canadoce/DuckBuddy/hardware/feet/rfq/duckbuddy-feet-drawing.pdf

TITLE

## Foot sole, LEFT shown, RIGHT is mirror image

PART NO.
DB-FOOT-SOLE-L / DB-FOOT-SOLE-R

MATERIAL
Cast PU elastomer, Shore 60A +-5, bright orange (e.g. RAL 2004)

SCALE

2:1

UNITS

mm

PROJECTION

Views as labelled

REV

A

DATE

2026-11-07

DRAWN

Rafael Caricio

SHEET

TOP VIEW (into cavity, dashed: cavity at Z=6)

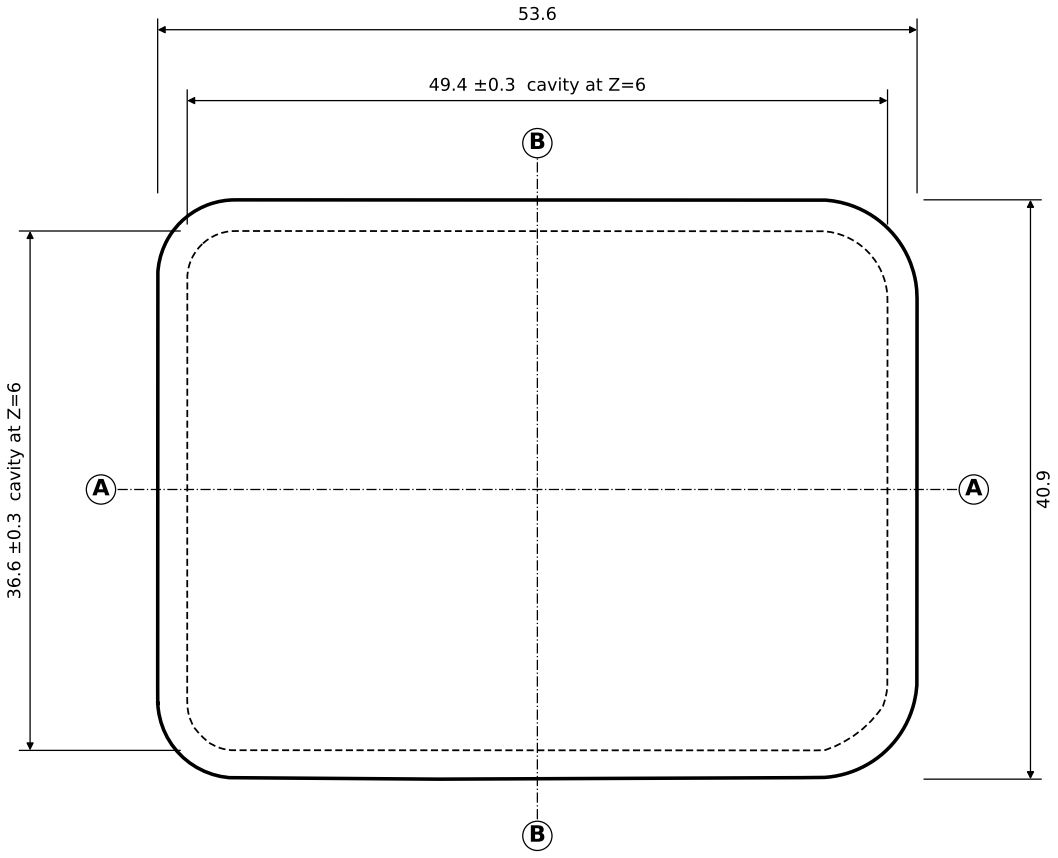
[picture p11: figure]
49.4 ±0.3 cavity at Z=6; 36.6 ±0.3 cavity at Z=6
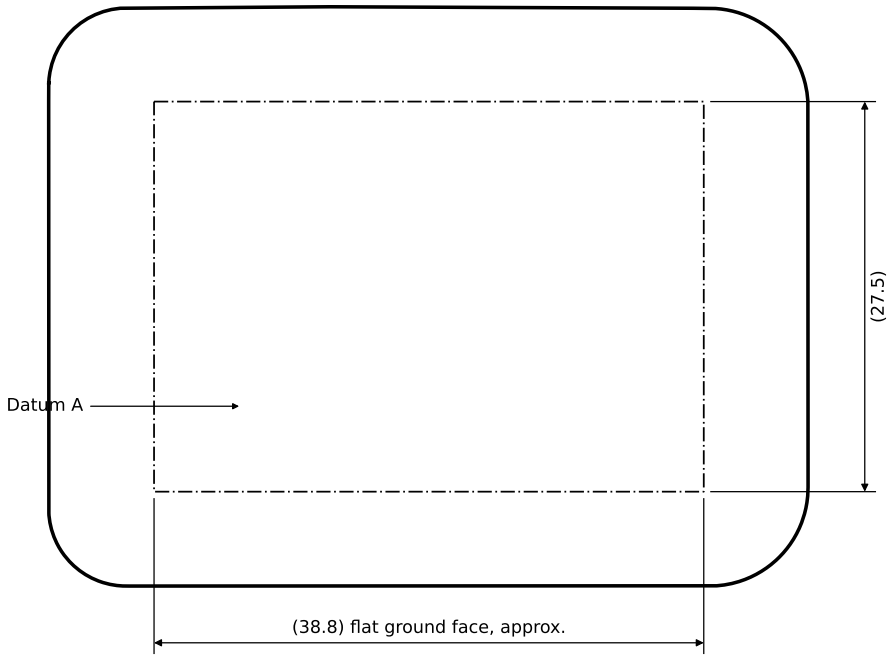
[picture p12: figure]
(38.8) flat ground face, approx.; Datum A

BOTTOM VIEW (ground face; dash-dot: flat area, edges blend up)

Datum A (ground)

(11.6)

# 2.0 floor

-X (heel) | +X (toe)
SECTION A-A (plane Y=0, seen from -Y; (11.6): rim at the toe, ref.) 13.3 | 10.0

Rim top is 4.9 deg to the ground face (ref.)

-Y | +Y
SECTION B-B (plane X=0, seen from +X)

NOTES
1. The STEP file is the master geometry. This drawing gives the critical dimensions and tolerances

only.

2. General tolerance +-0.3 mm (Yellowhammer standard vacuum casting accuracy: +-0.3 %, min +-0.3 mm).
3. The STEP is the finished sole: it is already 0.8 % smaller than the foot, so the soft sole

stretches over the rigid foot and grips it. Add only your usual casting-shrinkage compensation,
no other scaling.
4. Wall as modelled: 1.8-2.1 mm above Z=7; 1.2-1.5 mm in a band at Z=3-7 all round, where the cavity chamfer meets the rounded outside (thinnest at the toe). Wall +0.3/-0.2 mm and never under 1.0 mm. Floor 2.0 +-0.3 mm. No voids or bubbles.
5. Hardness Shore 60A +-5 (ISO 48-4 / ASTM D2240 type A, at 23 C, after full post-cure). Hardness not to be changed without written agreement.
6. Ground face (datum A): matte as-cast finish, no gloss, no release-agent film, no gate, vent, flash or parting line.
7. Gates and vents on the rim top face (it sits under the foot edge). Trim flash flush, max 0.2

mm.
8. Right sole = mirror image of the left sole about the XZ plane. Separate files: sole_left.step,

sole_right.step.

9. Pack left and right soles in separate labelled bags, not compressed or folded.

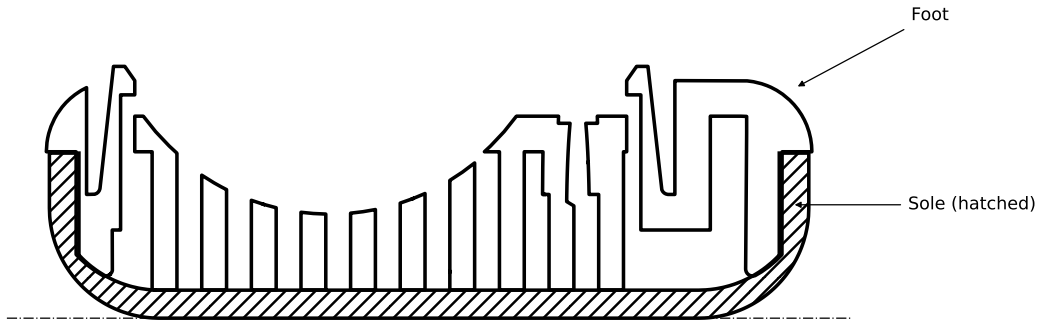
[picture p13: figure]
Sole (hatched); Foot

TITLE

## Foot (rigid), LEFT shown, RIGHT is mirror image

PART NO.
DB-FOOT-L / DB-FOOT-R

MATERIAL
PA12 (SLS, dyed), bright orange (e.g. RAL 2004)

SCALE

2:1

UNITS

mm

PROJECTION

Views as labelled

REV

A

DATE

2026-11-07

DRAWN

Rafael Caricio

SHEET

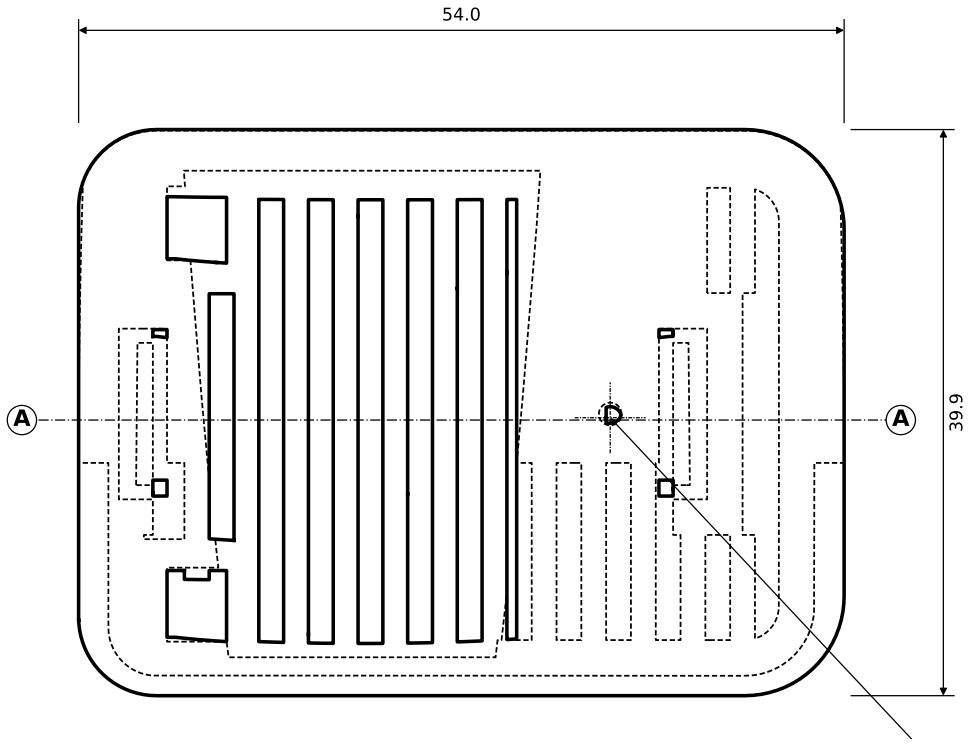
[picture p14: figure]

Pilot hole dia 1.6, 5 deep, for M2 self-tapping screw.
If printed smaller, clean to dia 1.6 with a drill. Do not enlarge.

TOP VIEW (dashed: section at Z=12)

16.4

SECTION A-A

The sole is 0.8 % smaller than the foot (stretch fit), so the outlines overlap.

ASSEMBLY, SECTION A-A (for reference)

NOTES
1. The STEP file is the master geometry. Make the part as modelled, no changes to holes, slots,

lugs or ribs.

2. General tolerance +-0.3 mm or the printing process standard, whichever is tighter.
3. Outer surfaces below the foot edge go into the sole cavity, which is made 0.8 % smaller (stretch fit). Do not add material on these surfaces (no thick coating).
4. Finish: as printed, bead blasted or vapour smoothed. Colour: bright orange, the same shade as the soles, dyed or pigmented through.
5. Right foot = mirror image of the left foot about the XZ plane. Separate files: foot_left.step,

foot_right.step.

6. The foot is an optional line item. Quote it separately from the soles.
