canadoce/DuckBuddy/hardware/pcb/pdb-imu/art/src/dog.png

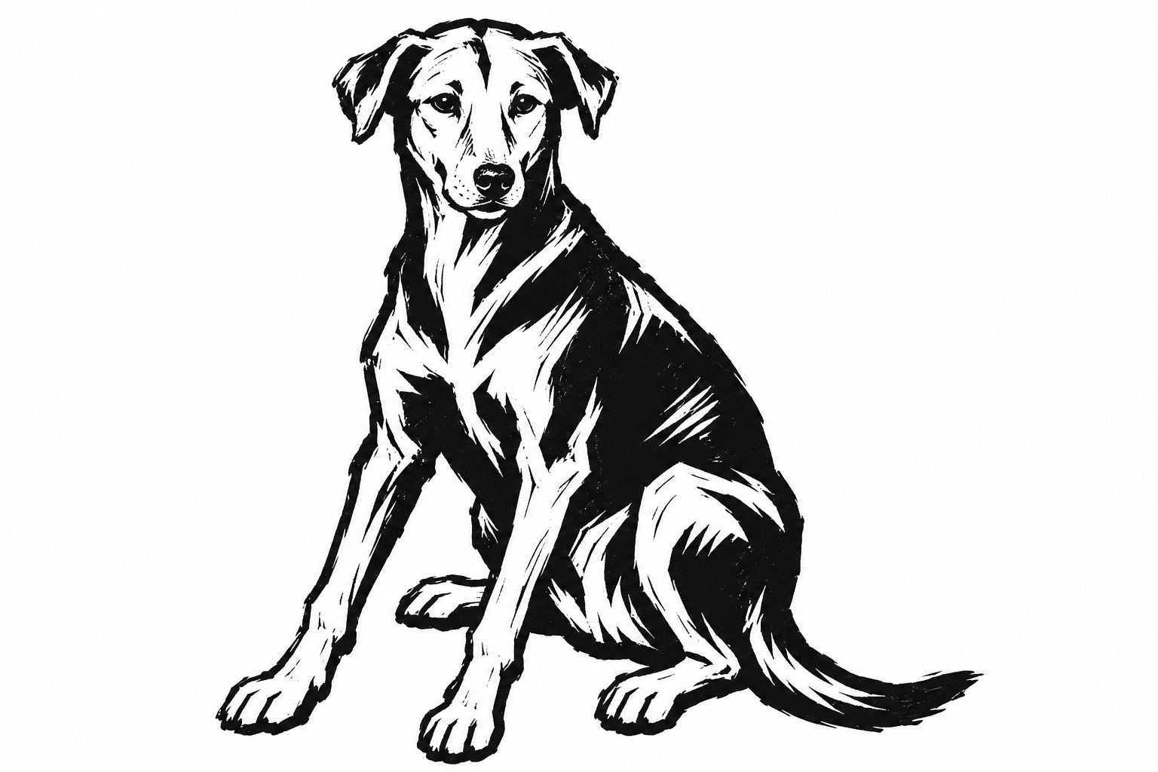
hardware/pcb/pdb-imu/art/src/dog.png
