canadoce/DuckBuddy/hardware/pcb/pdb-imu/fab/2026-11-04-jlcpcb-flat-mount/pdb-imu-r3-bom.csv

Designator | Comment | Value | Footprint | JLCPCB Part #
Q1 | AON7524 | C431195 | C431195 | C431195
Q2 | AON7524 | C431195 | C431195 | C431195
SW1 | MS-1290N | C19188866 | C19188866 | C19188866
R1 | 10k | 10k | res0402 | C25744
D4 |  | C2128 | sod323_anodepin2_cathodepin1 | C2128
Q4 | S8550 | C105432 | C105432 | C105432
Q3 | S8550 | C105432 | C105432 | C105432
U6 | CJ431 | C3113 | C3113 | C3113
R18 | 33k | 33k | res0402 | C25779
R19 | 39k | 39k | res0603 | C23153
R20 | 10k | 10k | res0402 | C25744
R21 | 27k | 27k | res0603 | C22967
R22 | 680k | 680k | res0603 | C25822
R23 | 4.7k | 4.7k | res0402 | C25900
R24 | 10k | 10k | res0402 | C25744
R25 | 10k | 10k | res0402 | C25744
C17 | 22u | 22u | cap0805_nonpolarized | C45783
R2 | 100k | 100k | res0402 | C25741
D2 |  | C173431 | sod123_anodepin2_cathodepin1 | C173431
C2 | 1u | 1u | cap0603_nonpolarized | C15849
D1 |  | C152106 | smb_anodepin2_cathodepin1 | C152106
C1 | RVT100UF25V67RV0011 | 100u | C2836443 | C2836443
F1 | 1210L300/24WR | C22379947 | C22379947 | C22379947
C3 | 10u | 10u | cap0805_nonpolarized | C15850
R3 | 33 | 33 | res0402 | C25105
R6 | 3.3k | 3.3k | res0402 | C25890
LED1 | KT-0805G | C2297 | C2297 | C2297
F2 | 1210L300/24WR | C22379947 | C22379947 | C22379947
C4 | 10u | 10u | cap0805_nonpolarized | C15850
R4 | 33 | 33 | res0402 | C25105
R7 | 3.3k | 3.3k | res0402 | C25890
LED2 | KT-0805G | C2297 | C2297 | C2297
F3 | 1210L300/24WR | C22379947 | C22379947 | C22379947
C5 | 10u | 10u | cap0805_nonpolarized | C15850
R5 | 33 | 33 | res0402 | C25105
R9 | 3.3k | 3.3k | res0402 | C25890
LED3 | KT-0805G | C2297 | C2297 | C2297
F4 | 1A / 32V | 1A / 32V | 0603 | C99544
C6 | 1u | 1u | cap0603_nonpolarized | C15849
U3 | TPS70933DBVR | C89347 | C89347 | C89347
C7 | 4.7u | 4.7u | cap0603_nonpolarized | C19666
U1 | STM32G031F8P6 | C529334 | C529334 | C529334
C8 | 100n | 100n | cap0402_nonpolarized | C1525
C9 | 4.7u | 4.7u | cap0603_nonpolarized | C19666
C10 | 100n | 100n | cap0402_nonpolarized | C1525
R10 | 1k | 1k | res0402 | C11702
LED4 | KT-0603R | C2286 | C2286 | C2286
U2 | LSM6DSV16XTR | C5267406 | C5267406 | C5267406
C11 | 100n | 100n | cap0402_nonpolarized | C1525
C12 | 100n | 100n | cap0402_nonpolarized | C1525
R8 | 10k | 10k | res0402 | C25744
U4 | 74LVC1G126GW | C52140429 | C52140429 | C52140429
C13 | 100n | 100n | cap0402_nonpolarized | C1525
R11 | 100k | 100k | res0402 | C25741
R13 | 33 | 33 | res0402 | C25105
D3 | PESD5V0S1BA | C2827694 | C2827694 | C2827694
R16 | 100k | 100k | res0402 | C25741
R17 | 22k | 22k | res0402 | C25768
C16 | 100n | 100n | cap0402_nonpolarized | C1525
RS1 | RLM12FTCMR002 | 2m | C710257 | C710257
U5 | INA180A2IDBVR | C192764 | C192764 | C192764
C14 | 100n | 100n | cap0402_nonpolarized | C1525
R15 | 1k | 1k | res0402 | C11702
C15 | 100n | 100n | cap0402_nonpolarized | C1525
