canadoce/DuckBuddy/hardware/pcb/pdb-imu/art/src/microduck_iso_parts.png

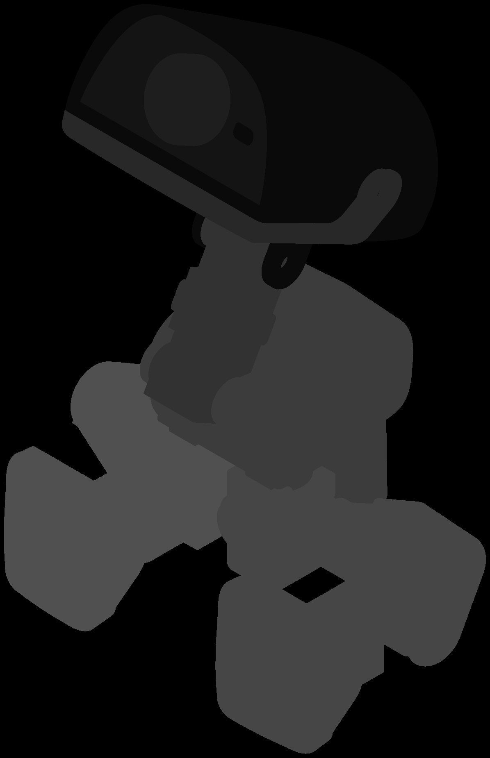
hardware/pcb/pdb-imu/art/src/microduck_iso_parts.png
