canadoce/DuckBuddy/hardware/cad/face-plate/3MF/face_plate.3mf

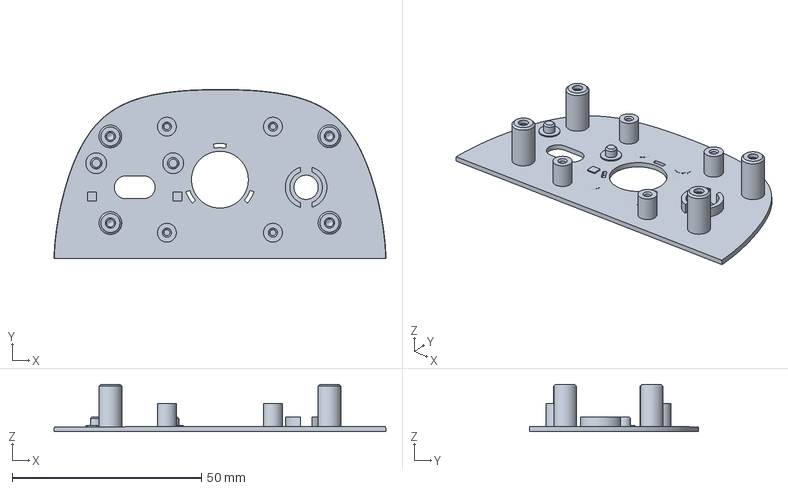
[picture p17: CAD file, 2026-11-09]
hardware/cad/face-plate/3MF/face_plate.3mf
87.7 x 44.7 x 12.5 mm
