canadoce/DuckBuddy/hardware/cad/lipo-plate/reference/power_support__5.stl

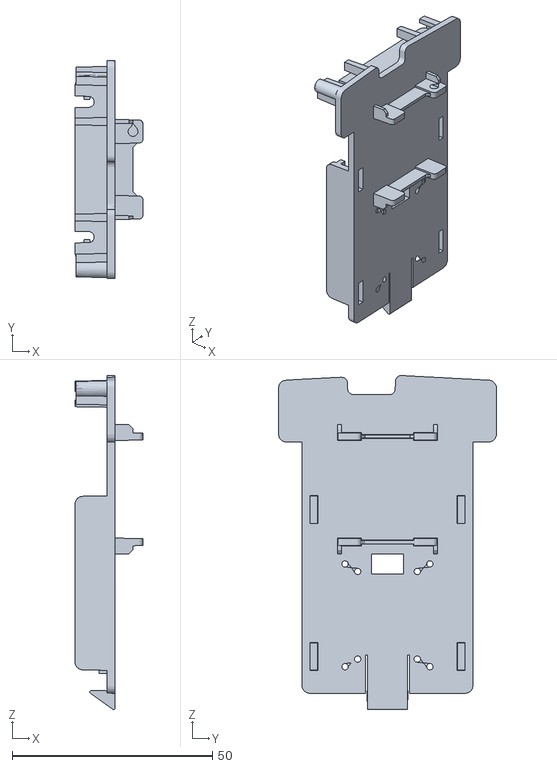
[picture p18: CAD file, 2026-11-06]
hardware/cad/lipo-plate/reference/power_support__5.stl
17.0 x 54.5 x 83.5
