canadoce/DuckBuddy/hardware/cad/lipo-plate/STEP/imu_mount.step

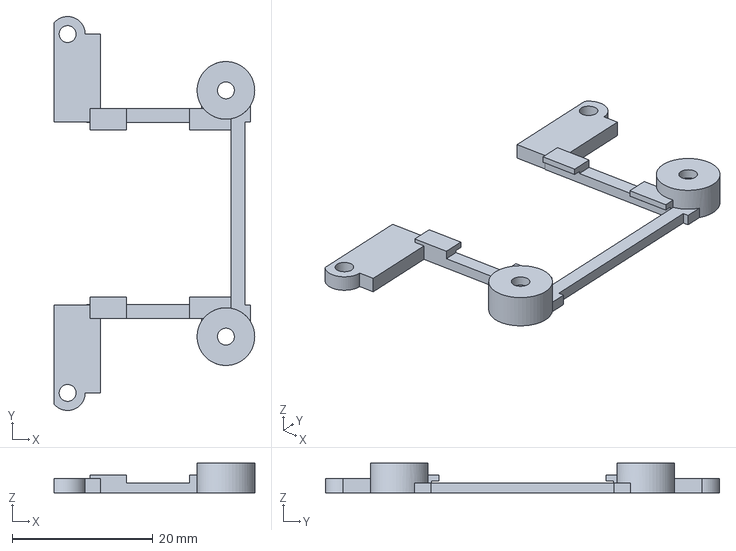
[picture p19: CAD file, 2026-11-09]
hardware/cad/lipo-plate/STEP/imu_mount.step
28.5 x 56.0 x 4.20 mm
