canadoce/DuckBuddy/hardware/cad/open-head/3MF/open_head_shell.3mf

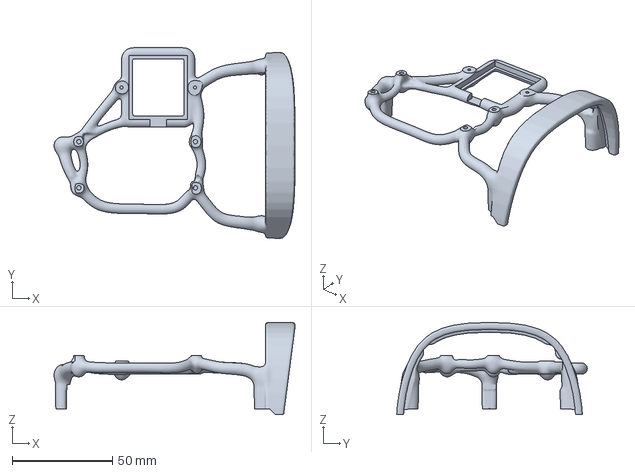
[picture p20: CAD file, 2026-11-09]
hardware/cad/open-head/3MF/open_head_shell.3mf
120.0 x 94.9 x 45.9 mm
