canadoce/DuckBuddy/hardware/cad/open-head/reference/bottom_head_shell_duckbuddy.stl

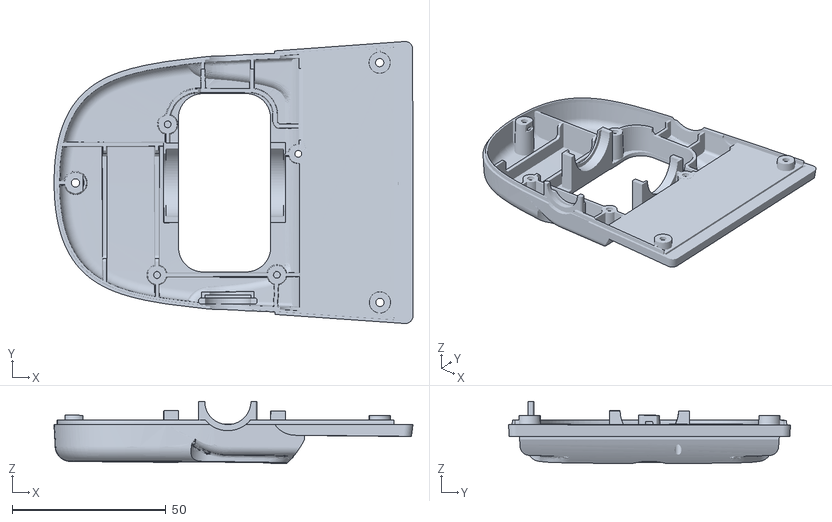
[picture p21: CAD file, 2026-11-06]
hardware/cad/open-head/reference/bottom_head_shell_duckbuddy.stl
116.8 x 91.8 x 20.2
