canadoce/DuckBuddy/hardware/cad/open-head/reference/microduck/jaw_soft__xl330__44.stl

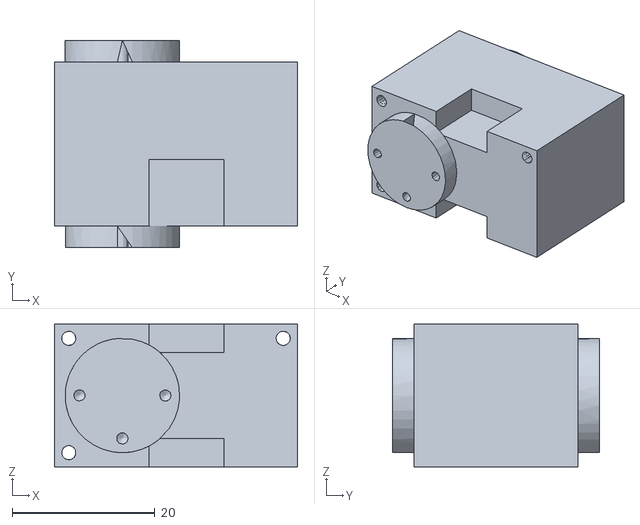
[picture p22: CAD file, 2026-11-06]
hardware/cad/open-head/reference/microduck/jaw_soft__xl330__44.stl
34.0 x 29.0 x 20.0
