canadoce/DuckBuddy/hardware/cad/servo-dummy/3MF/servo_dummy.3mf

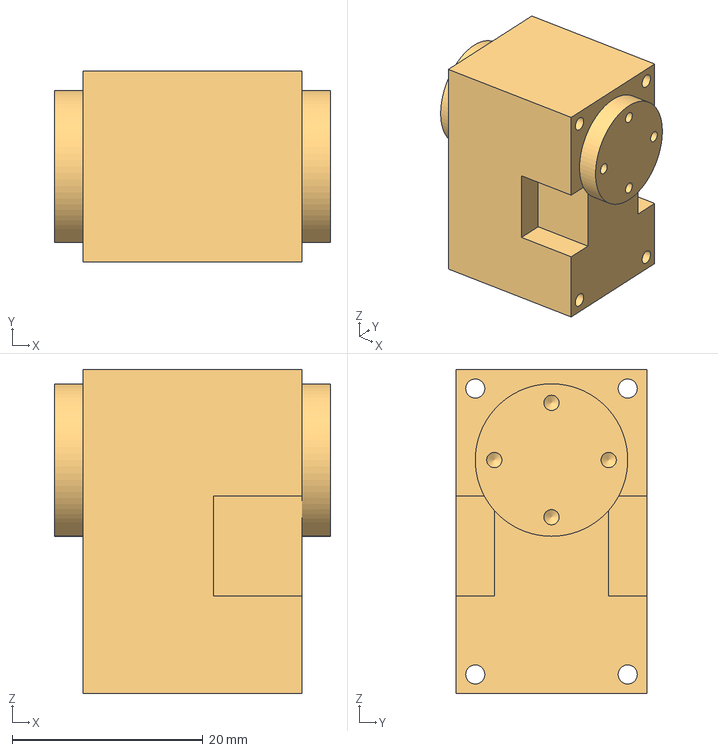
[picture p23: CAD file, 2026-11-07]
hardware/cad/servo-dummy/3MF/servo_dummy.3mf
29.0 x 20.0 x 34.0 mm
