canadoce/DuckBuddy/hardware/feet/STL/sole_right.stl

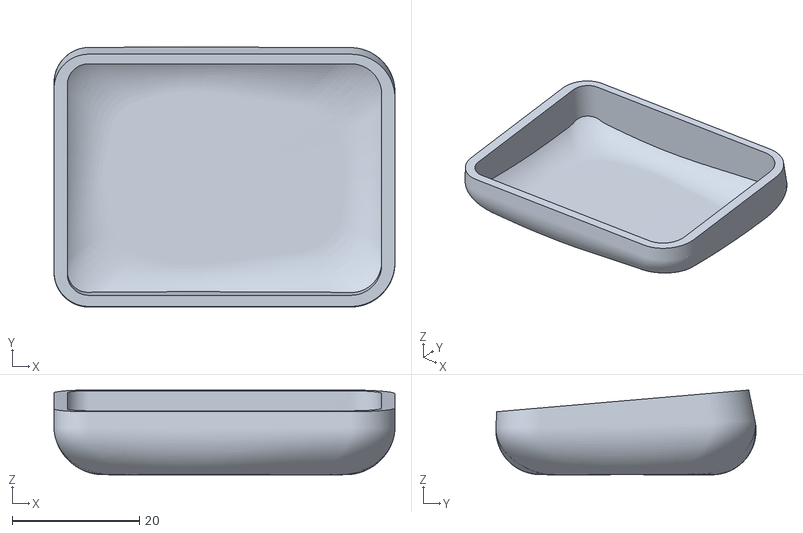
[picture p24: CAD file, 2026-11-09]
hardware/feet/STL/sole_right.stl
53.6 x 40.9 x 13.3
