canadoce/DuckBuddy/hardware/cad/lipo-plate/STEP/lipo_plate.step

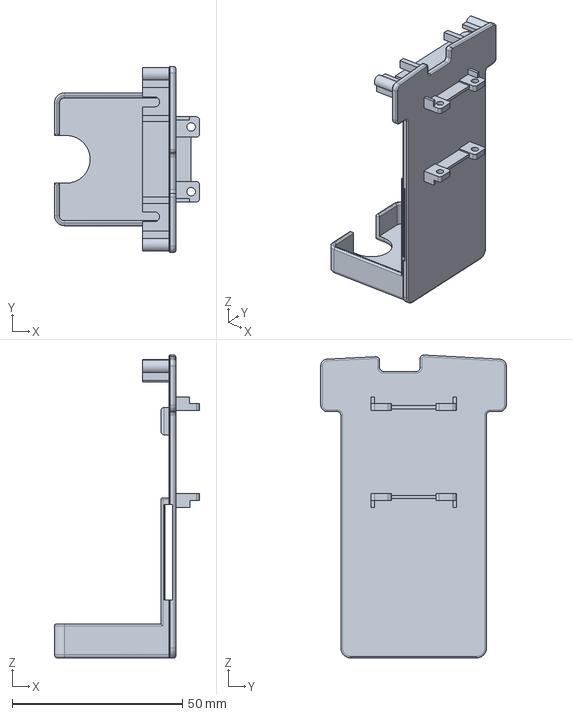
[picture p26: CAD file, 2026-11-09]
hardware/cad/lipo-plate/STEP/lipo_plate.step
42.6 x 54.5 x 88.9 mm
