canadoce/DuckBuddy/hardware/cad/open-head/reference/face_part_duckbuddy.stl

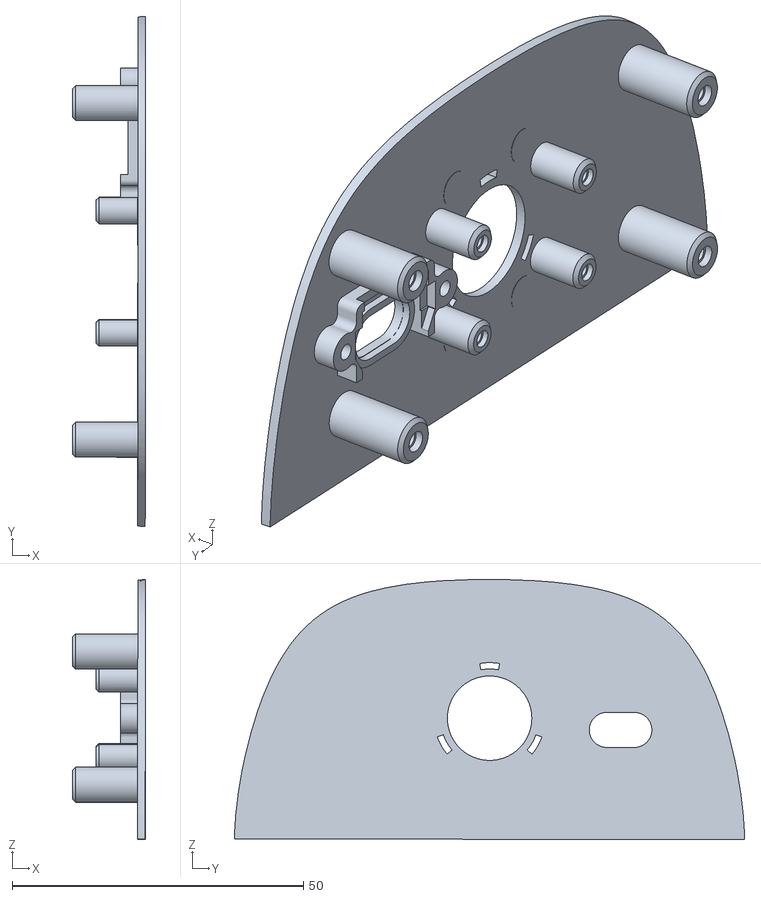
[picture p27: CAD file, 2026-11-06]
hardware/cad/open-head/reference/face_part_duckbuddy.stl
12.5 x 87.7 x 44.7
