canadoce/DuckBuddy/hardware/cad/open-head/reference/microduck/jaw_soft__noenoeil__53.stl

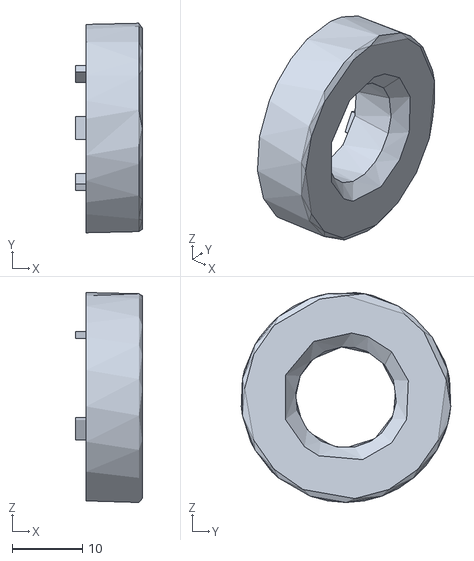
[picture p28: CAD file, 2026-11-06]
hardware/cad/open-head/reference/microduck/jaw_soft__noenoeil__53.stl
9.50 x 29.9 x 29.9
