canadoce/DuckBuddy/hardware/feet/STL/foot_right.stl

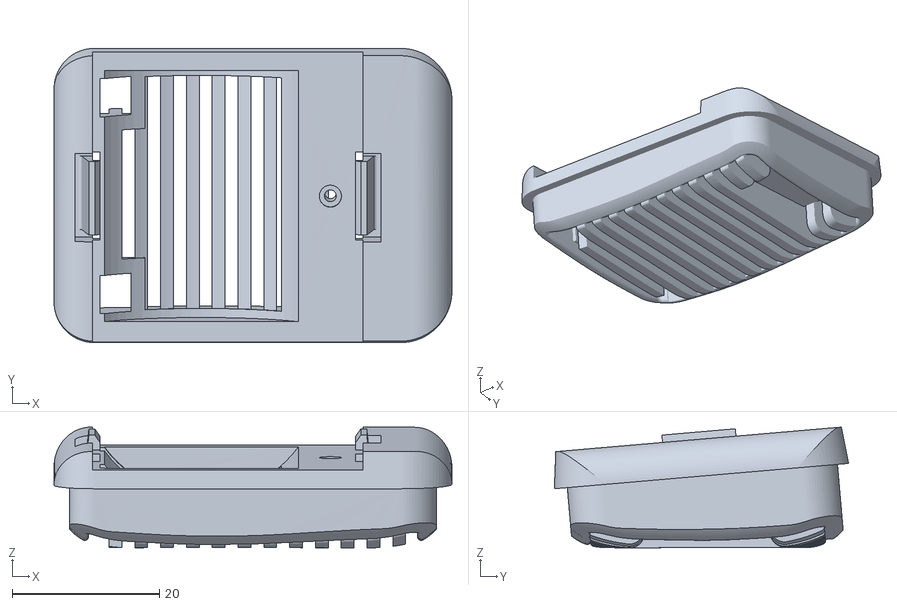
[picture p29: CAD file, 2026-11-09]
hardware/feet/STL/foot_right.stl
54.0 x 39.9 x 16.4
