canadoce/DuckBuddy/hardware/cad/lipo-plate/reference/seeed_bearing__configuration__22x16x4__0.stl

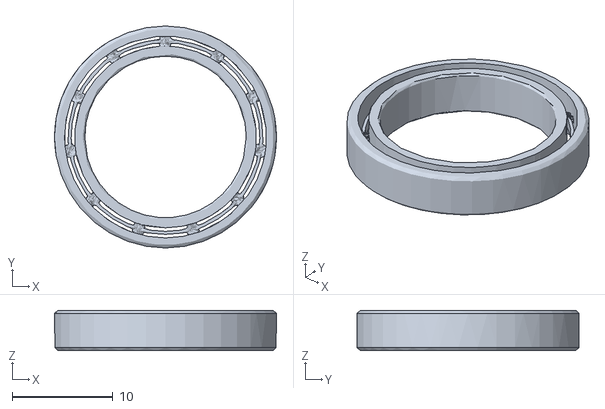
[picture p30: CAD file, 2026-11-06]
hardware/cad/lipo-plate/reference/seeed_bearing__configuration__22x16x4__0.stl
22.0 x 22.0 x 4.00
