canadoce/DuckBuddy/hardware/cad/open-head/reference/microduck/jaw_soft__soft_mouth_top__52.stl

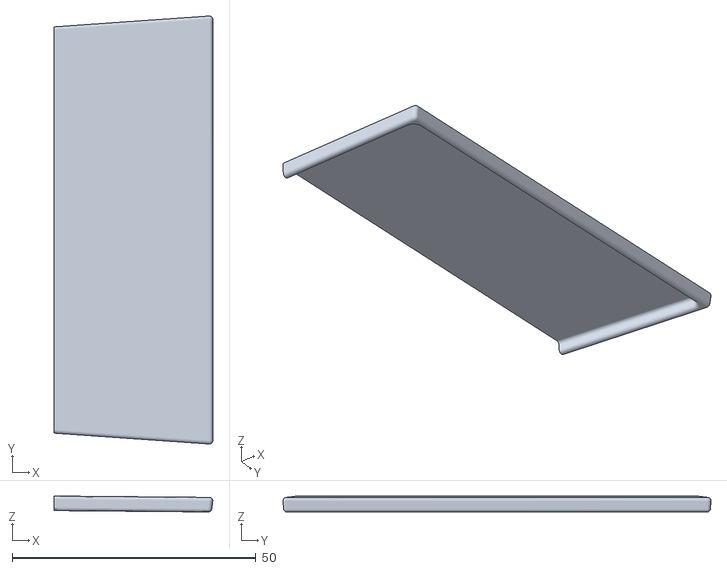
[picture p31: CAD file, 2026-11-06]
hardware/cad/open-head/reference/microduck/jaw_soft__soft_mouth_top__52.stl
32.6 x 87.8 x 3.27
