canadoce/DuckBuddy/hardware/cad/open-head/reference/top_head_shell_duckbuddy.stl

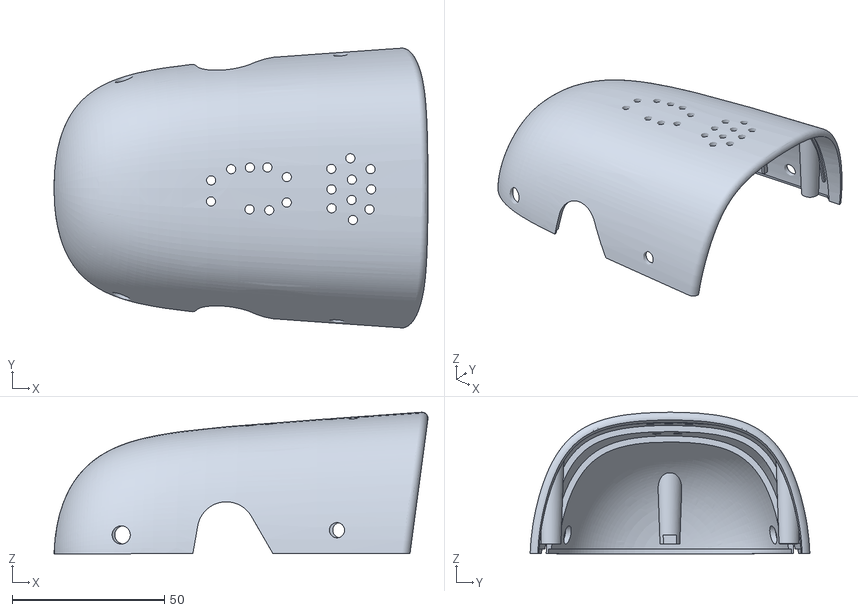
[picture p32: CAD file, 2026-11-06]
hardware/cad/open-head/reference/top_head_shell_duckbuddy.stl
122.7 x 91.8 x 46.4
