canadoce/DuckBuddy/hardware/cad/lipo-plate/reference/right_shell__1.stl

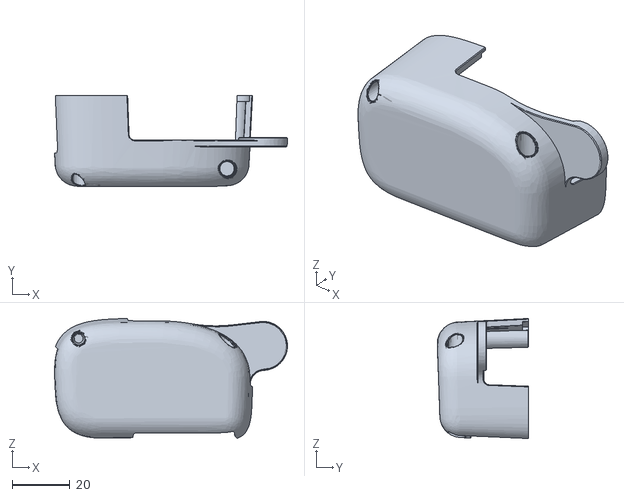
[picture p33: CAD file, 2026-11-06]
hardware/cad/lipo-plate/reference/right_shell__1.stl
80.9 x 31.8 x 41.7
