canadoce/DuckBuddy/hardware/cad/open-head/reference/microduck/jaw_soft__bottom_head_shell__56.stl

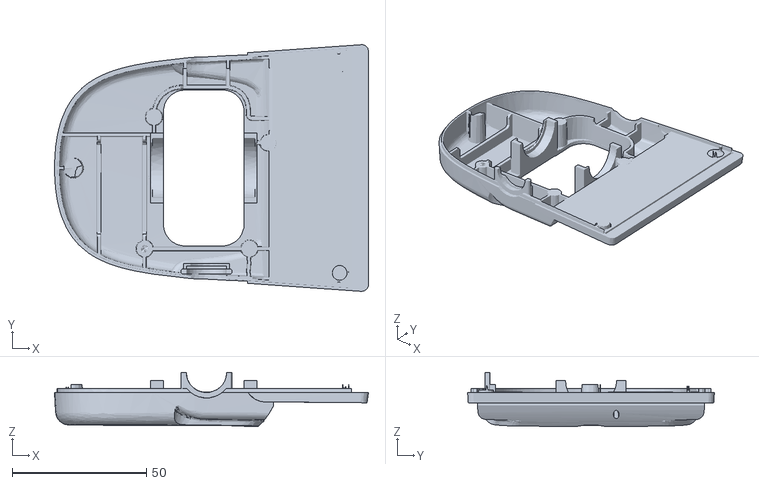
[picture p34: CAD file, 2026-11-06]
hardware/cad/open-head/reference/microduck/jaw_soft__bottom_head_shell__56.stl
116.7 x 91.7 x 20.1
