canadoce/DuckBuddy/hardware/cad/lipo-plate/reference/power_support_duckbuddy.stl

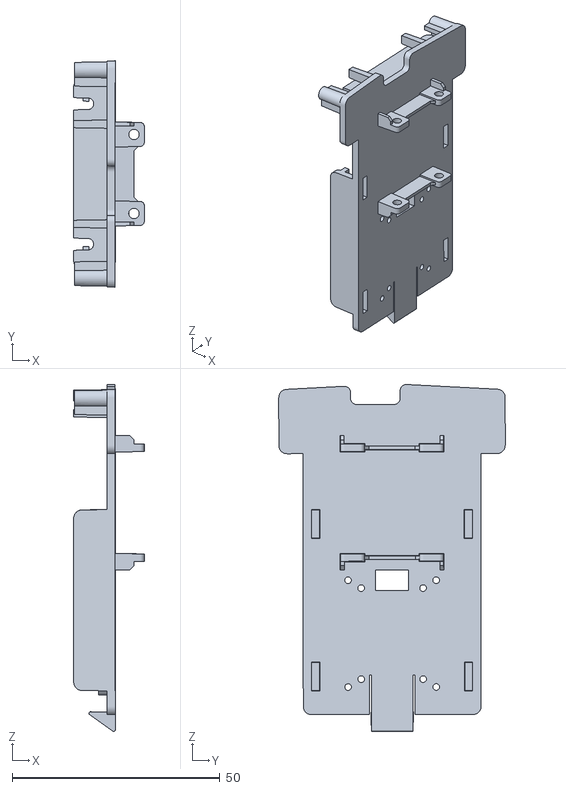
[picture p35: CAD file, 2026-11-06]
hardware/cad/lipo-plate/reference/power_support_duckbuddy.stl
17.0 x 54.5 x 83.5
