canadoce/DuckBuddy/hardware/cad/open-head/reference/microduck/jaw_soft__m12_lens_holder__58.stl

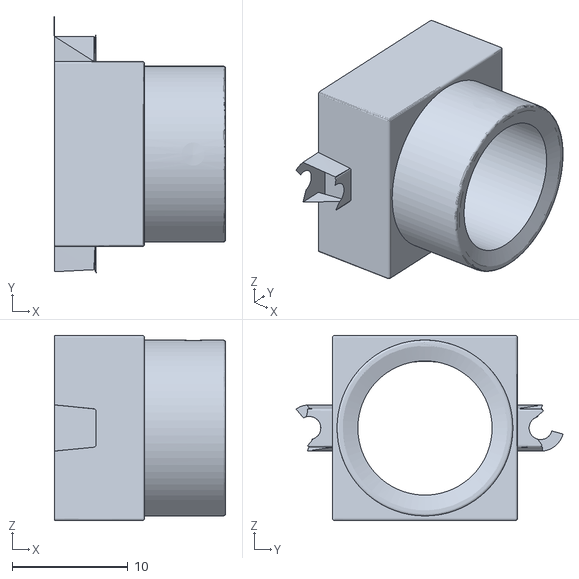
[picture p36: CAD file, 2026-11-06]
hardware/cad/open-head/reference/microduck/jaw_soft__m12_lens_holder__58.stl
14.8 x 23.1 x 16.0
