canadoce/DuckBuddy/hardware/cad/lipo-plate/reference/trunk_base_duckbuddy.stl

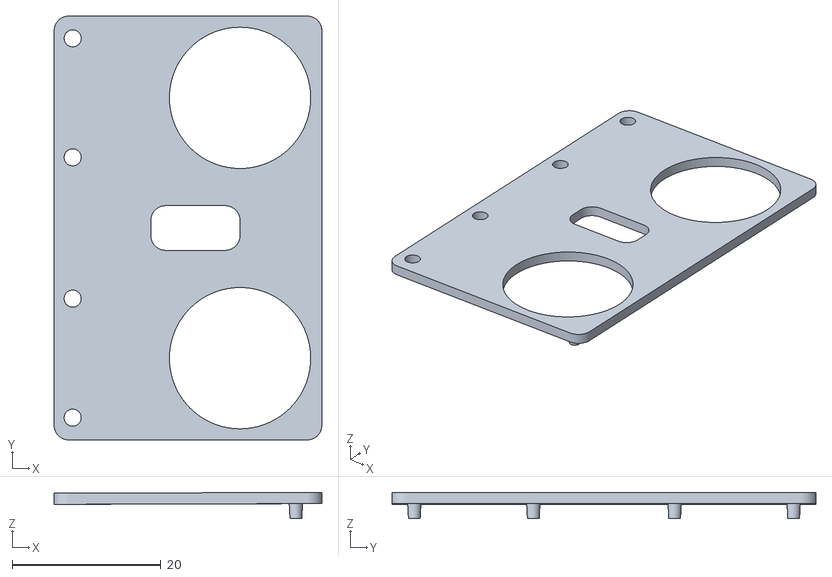
[picture p37: CAD file, 2026-11-06]
hardware/cad/lipo-plate/reference/trunk_base_duckbuddy.stl
36.0 x 57.0 x 3.52
