canadoce/DuckBuddy/hardware/cad/open-head/reference/microduck/neck__neck__35.stl

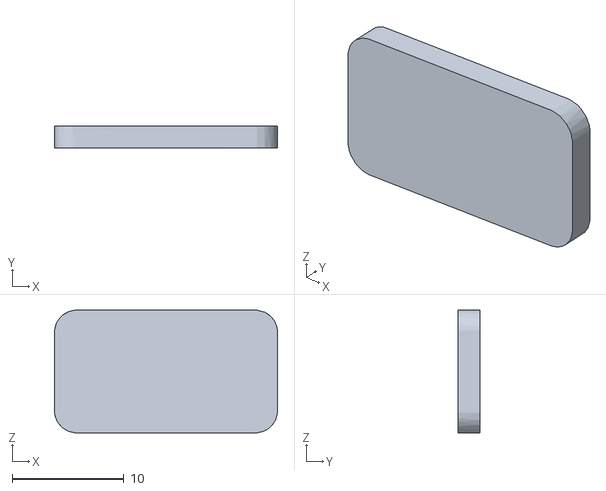
[picture p38: CAD file, 2026-11-06]
hardware/cad/open-head/reference/microduck/neck__neck__35.stl
20.0 x 2.00 x 11.0
