canadoce/DuckBuddy/hardware/cad/open-head/reference/microduck/jaw_soft__jaw__54.stl

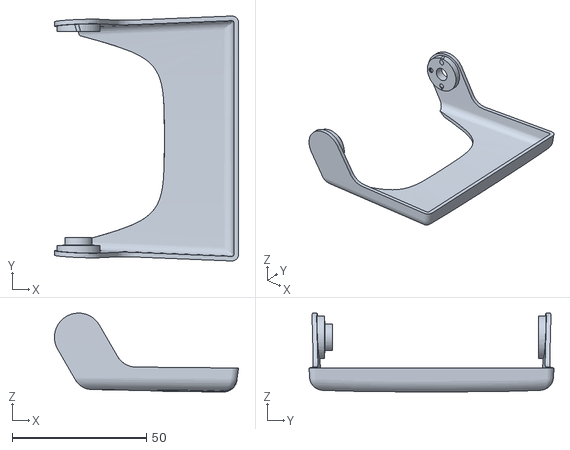
[picture p39: CAD file, 2026-11-06]
hardware/cad/open-head/reference/microduck/jaw_soft__jaw__54.stl
68.7 x 91.4 x 29.4
