canadoce/DuckBuddy/hardware/cad/lipo-plate/reference/np_f970__7.stl

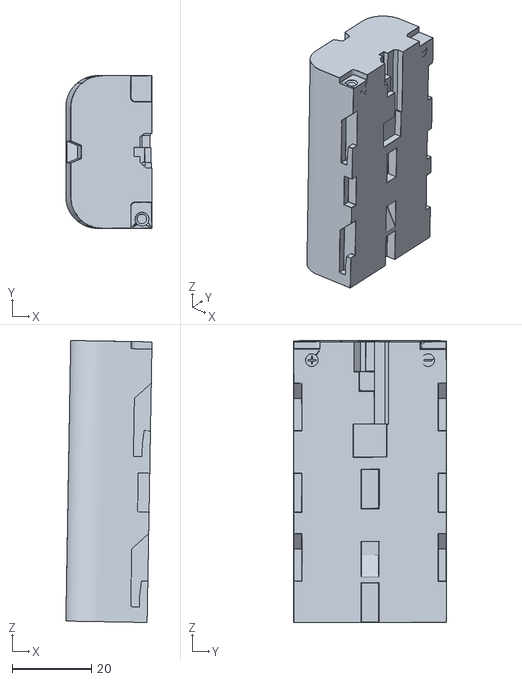
[picture p40: CAD file, 2026-11-06]
hardware/cad/lipo-plate/reference/np_f970__7.stl
21.7 x 38.6 x 71.0
