canadoce/DuckBuddy/hardware/cad/open-head/reference/microduck/jaw_soft__pcb__raspberry_pi_zero_2_w__59.stl

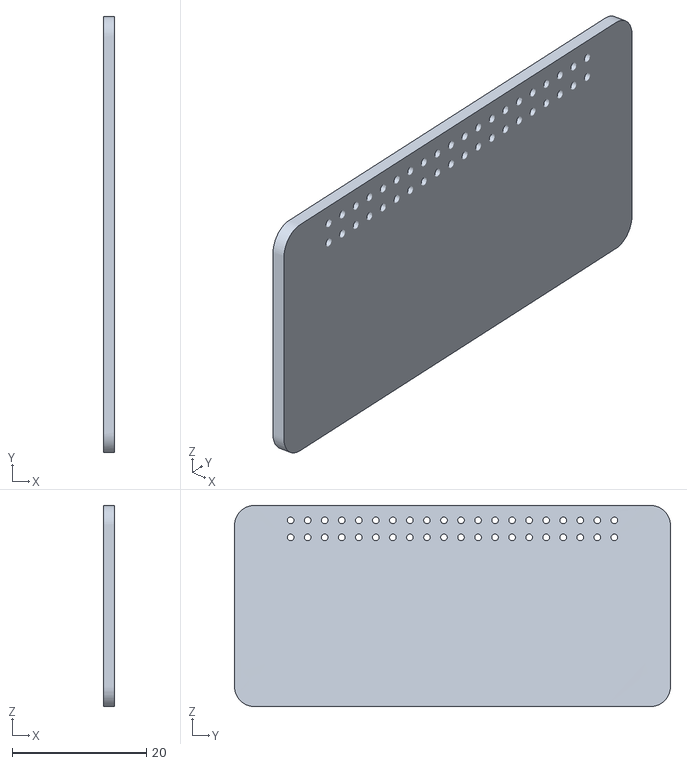
[picture p41: CAD file, 2026-11-06]
hardware/cad/open-head/reference/microduck/jaw_soft__pcb__raspberry_pi_zero_2_w__59.stl
1.60 x 65.0 x 30.0
