canadoce/DuckBuddy/hardware/cad/open-head/reference/microduck/jaw_soft__motor_support__46.stl

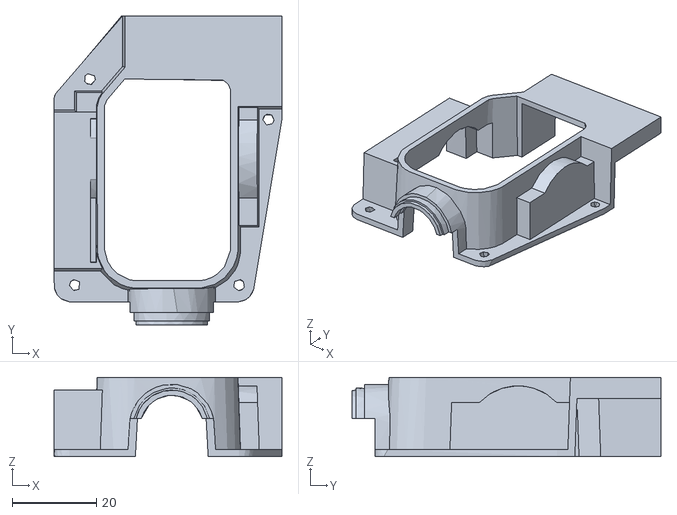
[picture p42: CAD file, 2026-11-06]
hardware/cad/open-head/reference/microduck/jaw_soft__motor_support__46.stl
54.2 x 73.5 x 18.8
