canadoce/DuckBuddy/hardware/cad/lipo-plate/reference/banana_pcb_locker_duckbuddy.stl

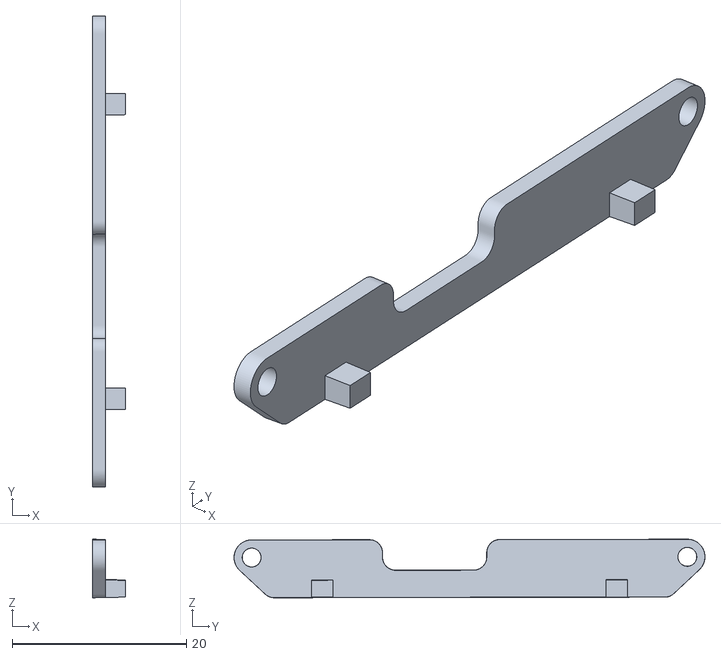
[picture p43: CAD file, 2026-11-06]
hardware/cad/lipo-plate/reference/banana_pcb_locker_duckbuddy.stl
3.82 x 54.0 x 6.73
