canadoce/DuckBuddy/hardware/cad/open-head/reference/microduck/jaw_soft__lens__42.stl

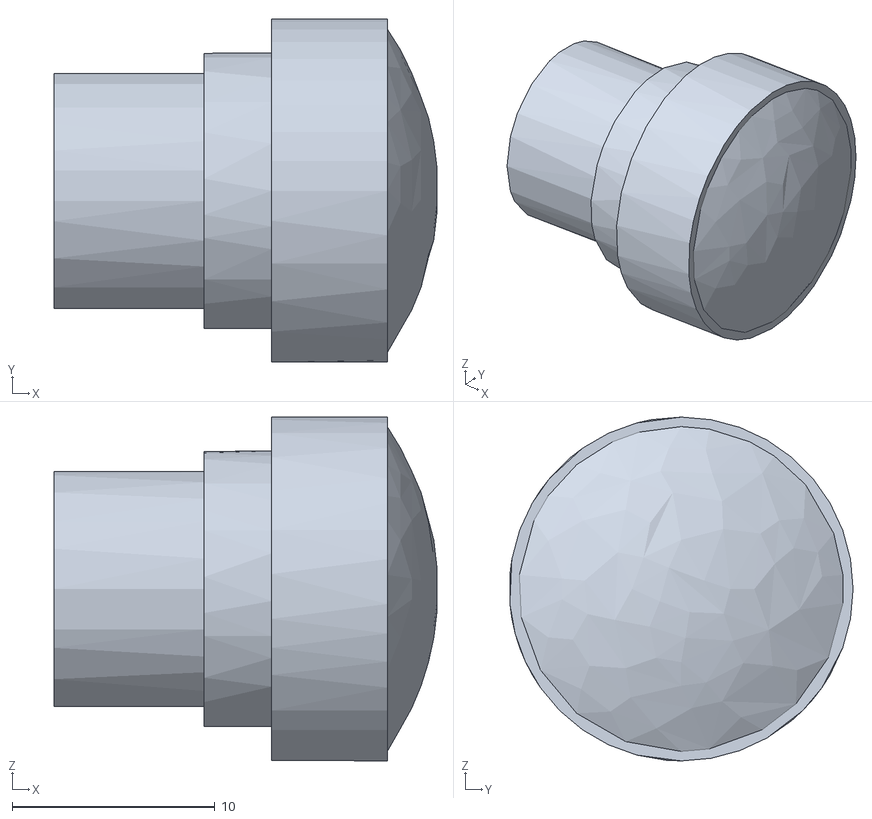
[picture p44: CAD file, 2026-11-06]
hardware/cad/open-head/reference/microduck/jaw_soft__lens__42.stl
18.9 x 16.9 x 16.9
