canadoce/DuckBuddy/hardware/cad/lipo-plate/reference/left_shell_duckbuddy.stl

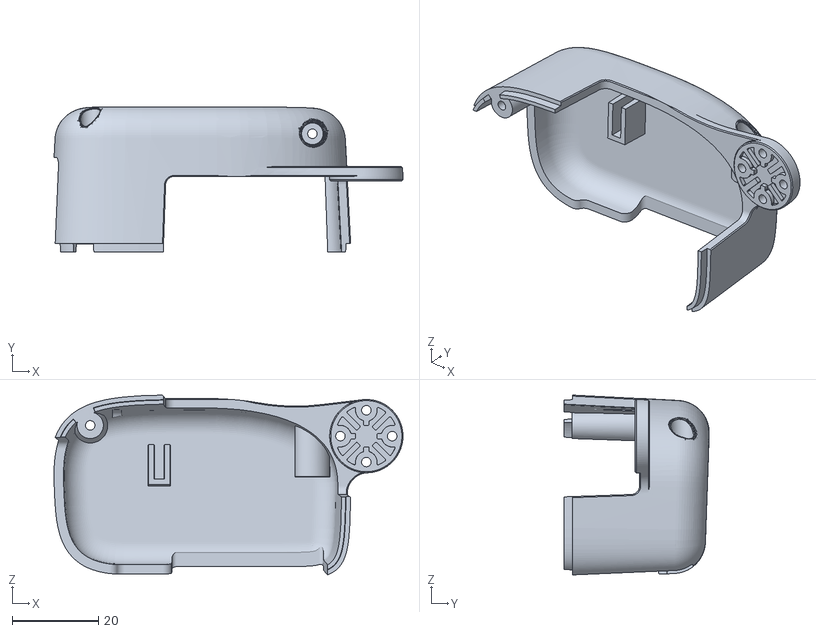
[picture p45: CAD file, 2026-11-06]
hardware/cad/lipo-plate/reference/left_shell_duckbuddy.stl
80.9 x 33.7 x 41.7
