canadoce/DuckBuddy/hardware/cad/lipo-plate/reference/trunk_base__3.stl

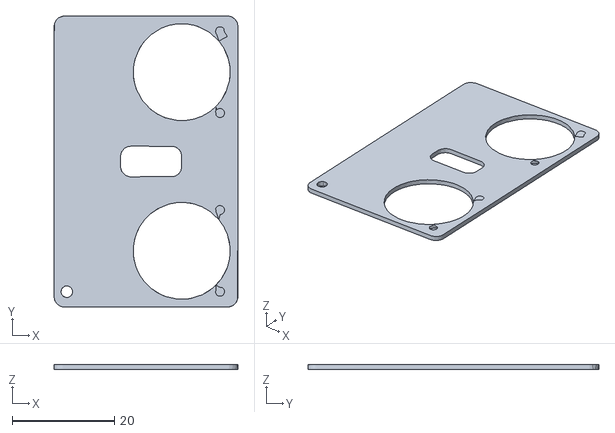
[picture p46: CAD file, 2026-11-06]
hardware/cad/lipo-plate/reference/trunk_base__3.stl
36.0 x 57.0 x 1.00
