canadoce/DuckBuddy/hardware/cad/lipo-plate/reference/left_shell__10.stl

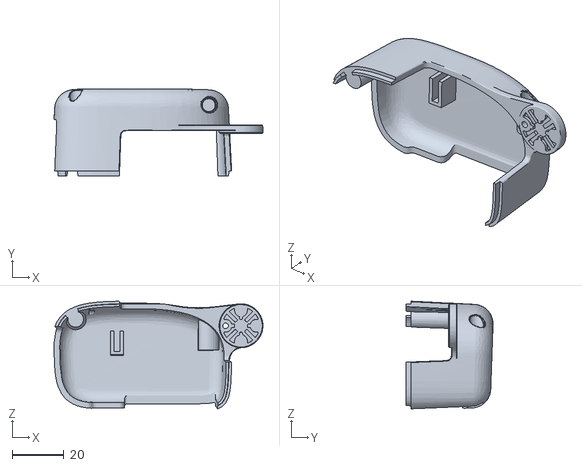
[picture p47: CAD file, 2026-11-06]
hardware/cad/lipo-plate/reference/left_shell__10.stl
80.9 x 33.7 x 41.7
