canadoce/DuckBuddy/hardware/cad/open-head/reference/microduck/jaw_soft__speaker__60.stl

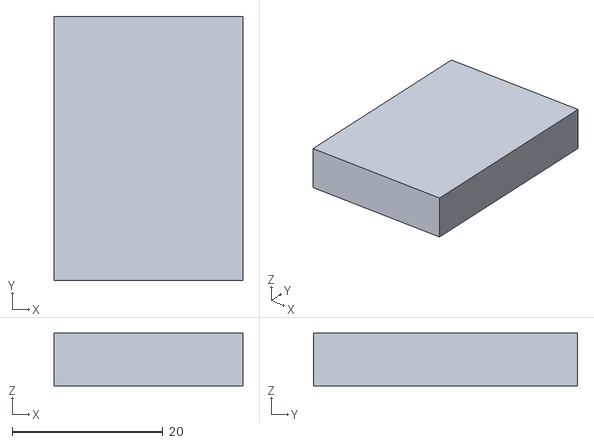
[picture p48: CAD file, 2026-11-06]
hardware/cad/open-head/reference/microduck/jaw_soft__speaker__60.stl
25.0 x 35.0 x 7.00
