canadoce/DuckBuddy/hardware/cad/lipo-plate/reference/banana_pcb_locker__2.stl

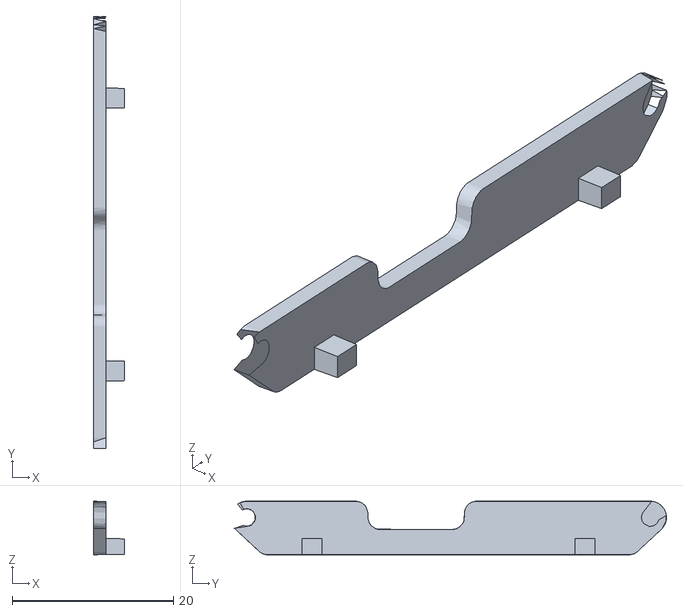
[picture p49: CAD file, 2026-11-06]
hardware/cad/lipo-plate/reference/banana_pcb_locker__2.stl
3.80 x 53.5 x 6.64
