canadoce/DuckBuddy/hardware/cad/open-head/reference/microduck/jaw_soft__face_part__43.stl

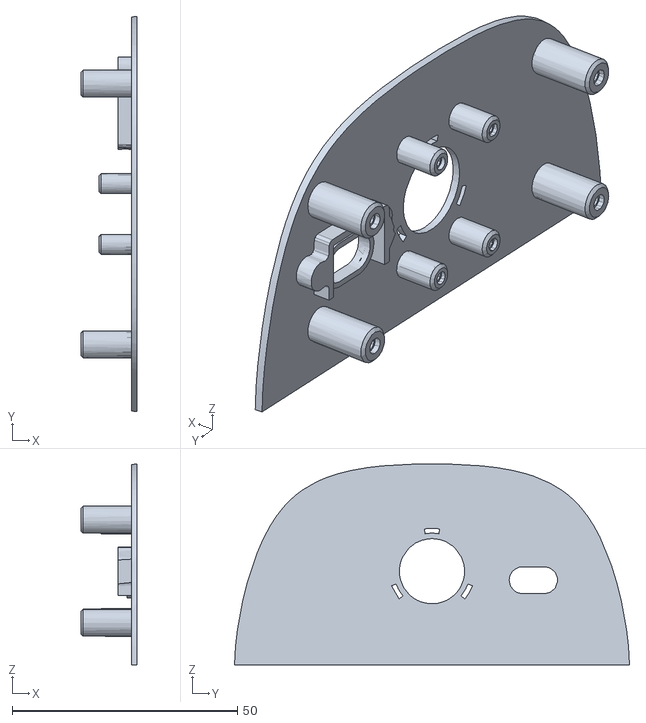
[picture p50: CAD file, 2026-11-06]
hardware/cad/open-head/reference/microduck/jaw_soft__face_part__43.stl
12.5 x 87.7 x 44.6
