canadoce/DuckBuddy/hardware/cad/open-head/reference/microduck/jaw_soft__jaw_soft__45.stl

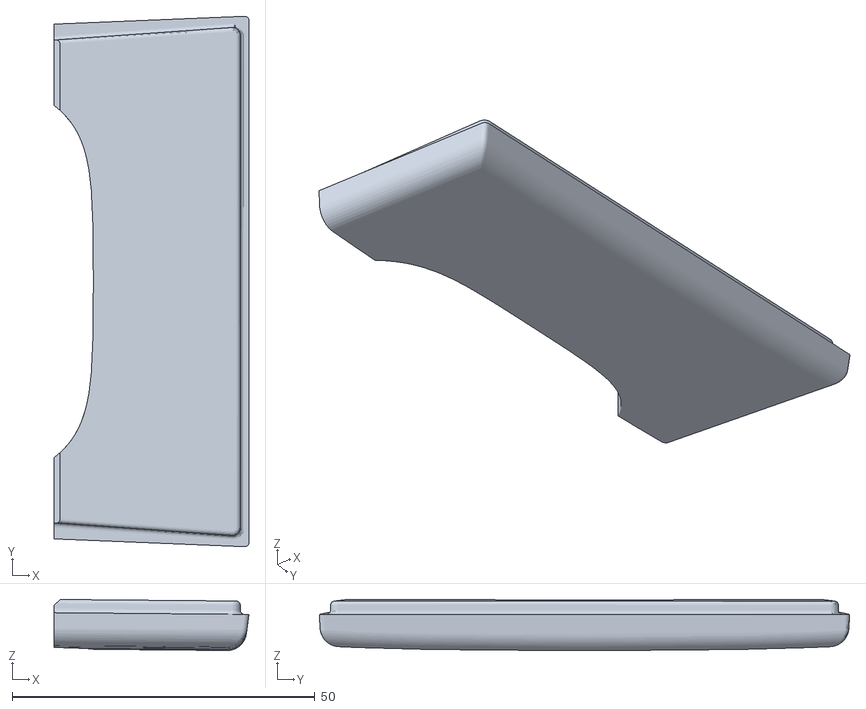
[picture p51: CAD file, 2026-11-06]
hardware/cad/open-head/reference/microduck/jaw_soft__jaw_soft__45.stl
32.2 x 87.7 x 8.44
