canadoce/DuckBuddy/hardware/cad/open-head/reference/microduck/yaw_roll_motion__yaw_roll_motion__38.stl

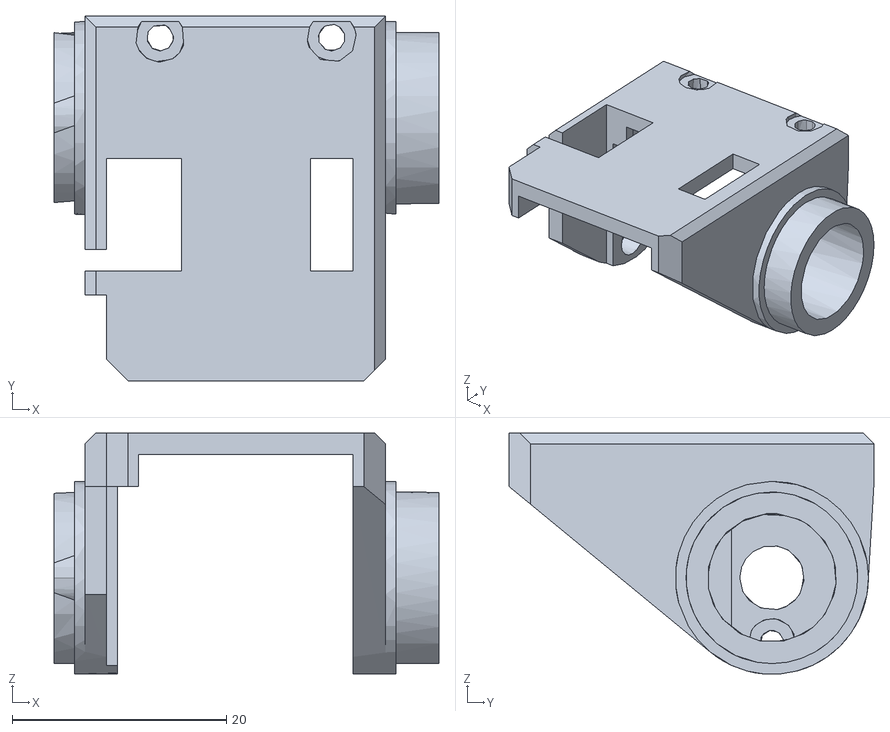
[picture p52: CAD file, 2026-11-06]
hardware/cad/open-head/reference/microduck/yaw_roll_motion__yaw_roll_motion__38.stl
35.9 x 34.0 x 22.5
