canadoce/DuckBuddy/hardware/cad/open-head/reference/microduck/neck_pitch__neck_pitch__36.stl

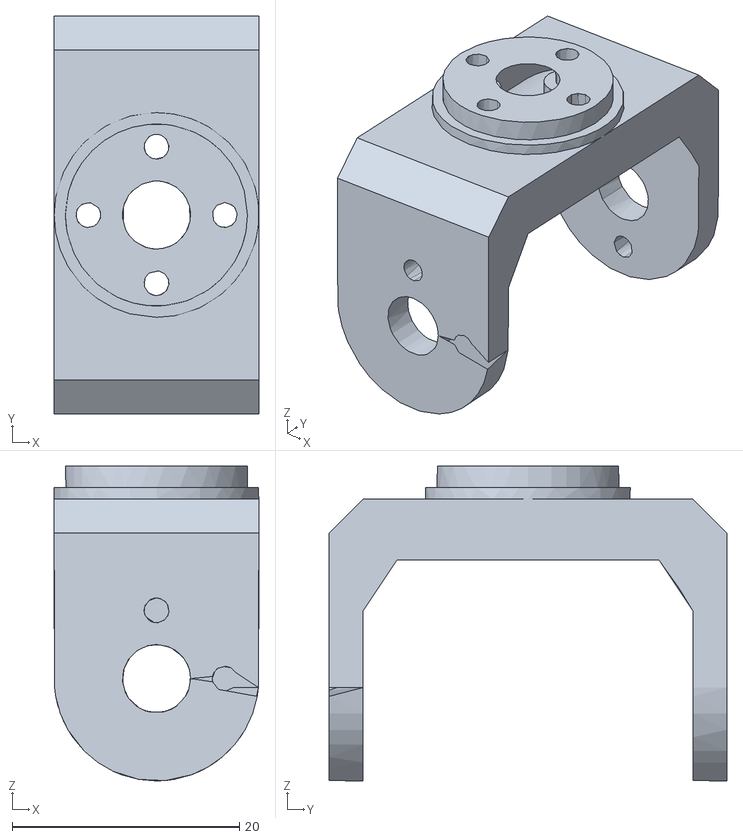
[picture p53: CAD file, 2026-11-06]
hardware/cad/open-head/reference/microduck/neck_pitch__neck_pitch__36.stl
18.0 x 35.0 x 27.7
