canadoce/DuckBuddy/hardware/cad/open-head/reference/microduck/jaw_soft__seeed_bearing__configuration_default__50.stl

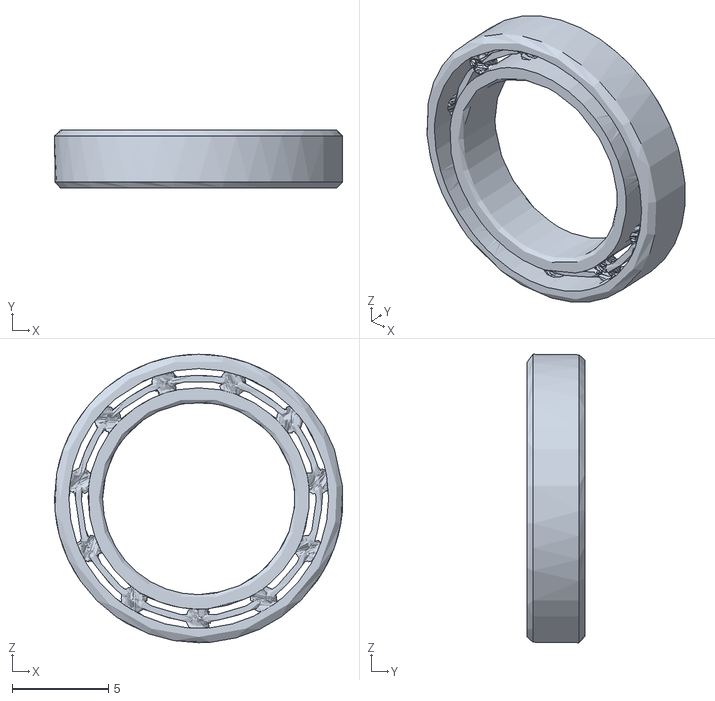
[picture p54: CAD file, 2026-11-06]
hardware/cad/open-head/reference/microduck/jaw_soft__seeed_bearing__configuration_default__50.stl
15.0 x 3.00 x 15.0
