canadoce/DuckBuddy/hardware/cad/open-head/reference/microduck/jaw_soft__elec_rpi_robot_hat_pcb__51.stl

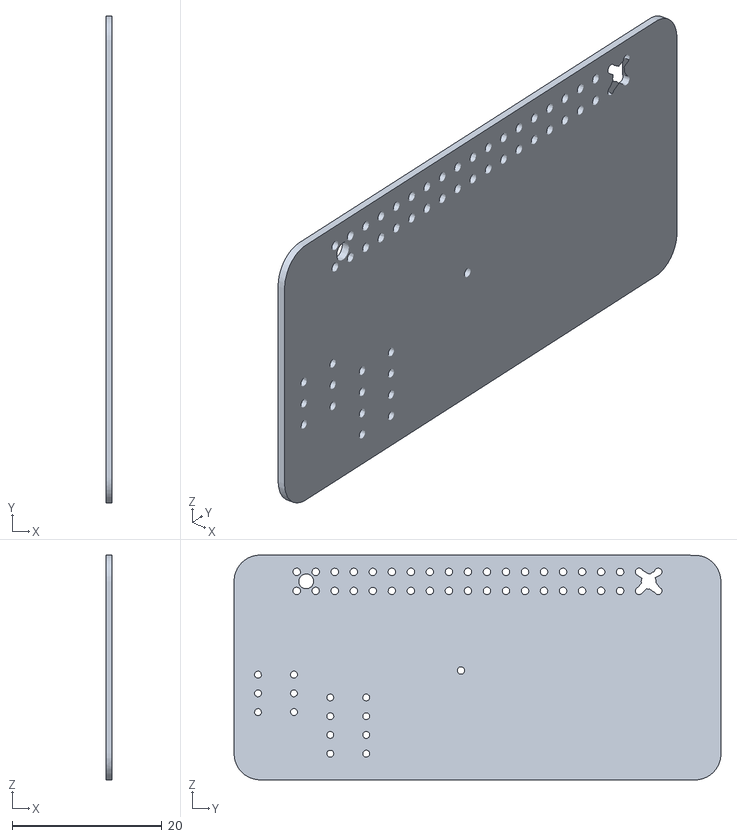
[picture p55: CAD file, 2026-11-06]
hardware/cad/open-head/reference/microduck/jaw_soft__elec_rpi_robot_hat_pcb__51.stl
0.84 x 65.0 x 30.0
