canadoce/DuckBuddy/(list of files, cad)

Other CAD files:
hardware/cad/lipo-plate/reference/xl330__4.stl
hardware/feet/STL/foot_left.stl
hardware/feet/STL/sole_left.stl
hardware/cad/lipo-plate/reference/seeed_bearing__configuration__22x16x4__11.stl
hardware/cad/lipo-plate/reference/xl330__9.stl
hardware/cad/open-head/reference/microduck/neck__neck__32.stl
hardware/cad/lipo-plate/reference/right_shell_duckbuddy.stl
hardware/cad/open-head/reference/microduck/yaw_roll_motion__seeed_bearing__configuration__22x16x4__41.stl
hardware/cad/open-head/reference/microduck/neck__xl330__33.stl
hardware/cad/open-head/reference/microduck/jaw_soft__top_head_shell__47.stl
hardware/cad/open-head/reference/microduck/jaw_soft__xl330__49.stl
hardware/cad/open-head/reference/microduck/neck_pitch__seeed_bearing__configuration__22x16x4__37.stl
hardware/cad/open-head/reference/microduck/yaw_roll_motion__seeed_bearing__configuration__22x16x4__40.stl
hardware/cad/open-head/reference/microduck/neck__xl330__34.stl
hardware/cad/open-head/reference/microduck/yaw_roll_motion__xl330__39.stl
hardware/cad/face-plate/STL/face_plate.stl
hardware/cad/lipo-plate/3MF/imu_mount.3mf
hardware/cad/lipo-plate/3MF/lipo_plate.3mf
hardware/cad/lipo-plate/STL/imu_mount.stl
hardware/cad/lipo-plate/STL/lipo_plate.stl
hardware/cad/open-head/STL/open_head_shell.stl
hardware/cad/servo-dummy/STL/servo_dummy.stl
