canadoce/DuckBuddy/robotd/src/main.rs

//! `robotd` — the robot control daemon.
//!
//! The 50 Hz control loop, the `robot.*` socket, and the health the updater gates on
//! (`docs/design/robotd-design.md` §1.4, §3.4).
//!
//! **Health is why the daemon has the shape it does.** The updater's auto-rollback is only
//! meaningful if `robot.health` means something, and it used to mean "the loop ticked once" —
//! so every rollback was tested against a placeholder. It now means **the loop is meeting its
//! deadline**: a loop running at 60% of target is alive, answers every request, and is badly
//! broken.
//!
//! Holding the pose with no policy (`policy.enabled = false`) stays the right thing to be doing
//! while someone deliberately breaks releases at a bench: the bus sees the real load at the
//! real rate, and nothing falls over when a bad build lands.
//!
//! Every method must be answerable *while the robot is in a bad state*,
//! since that is exactly when it is asked. So the IPC side reads atomics the control loop
//! publishes and never calls into the loop — a wedged loop reports itself unhealthy rather
//! than hanging the caller.

mod chorale;
mod control;
mod intents;
mod params;
mod soc;
mod sound;
mod theremin;

use std::path::PathBuf;
use std::process::ExitCode;
use std::sync::Arc;
use std::sync::atomic::{AtomicBool, AtomicU8, AtomicU32, AtomicU64, Ordering};
use std::time::{Duration, Instant};

use arc_swap::{ArcSwap, ArcSwapOption};
use clap::{Parser, Subcommand};
use duck_control::fall::{FallPredictor, FallPredictorConfig};
use duck_control::io::RobotIo;
use duck_control::obs::{BodyPose, Command as PolicyCommand};
use duck_control::policy::{DEFAULT_STANDING_THRESHOLD, Policy, PolicyPaths};
use duck_control::safety::{Safety, SafetyConfig};
use duck_control::servo_bus::BusConfig;
#[cfg(target_os = "linux")]
use duck_control::servo_bus::ServoBus;
use duck_control::{DEFAULT_POSITION, FakeIo, NUM_JOINTS, Pack};
use duck_ipc_proto as proto;
use tokio::io::{AsyncBufReadExt, AsyncWriteExt, BufReader};
use tokio::net::{UnixListener, UnixStream};

use control::{Controller, SkillTuning, Tuning};
use intents::Intents;
use params::{Mode, Params};

/// What to do when the shutdown sequence completes. Injected so the tests can observe the
/// call instead of powering off the machine running them.
type PowerOff = Arc<dyn Fn() + Send + Sync>;

/// A bring-up ramp is refused while any joint reads further than this from the home pose.
///
/// The ramp moves every joint linearly from where it reads to home, and a reading can be a
/// whole wrap away from where the joint is: the servos report one turn, -180..180°, so a head
/// turned by hand past 180° while limp reads from the other side, and the ramp swings it back
/// the long way — through its stop and its cables. That happened on 2026-10-05 (the head went
/// round half a turn on `robot.init`). Every leg joint's travel is well under this, and a head
/// left anywhere a person would leave it is too; a reading past it means "put me back first".
const RAMP_REFUSE_RAD: f64 = 100.0 * std::f64::consts::PI / 180.0;

/// Neck pitch, head pitch, head yaw and head roll in [`duck_control::JOINT_NAMES`] order.
const HEAD_JOINTS: std::ops::RangeInclusive<usize> = 5..=8;

/// How long a robot handed back after a fall must stay upright before a client's twist is
/// honoured again (see `getting_up`).
const GET_UP_SETTLE: Duration = Duration::from_secs(1);

/// Hold the head joints within `band` radians of home (`[safety] head_band_deg`).
fn band_head(targets: &mut [f64; NUM_JOINTS], band: f64) {
    for j in HEAD_JOINTS {
        targets[j] = targets[j].clamp(DEFAULT_POSITION[j] - band, DEFAULT_POSITION[j] + band);
    }
}

/// The joint furthest beyond [`RAMP_REFUSE_RAD`] from home, as a message, or `None` if the
/// ramp may start.
fn ramp_refusal(positions: &[f64; NUM_JOINTS]) -> Option<String> {
    positions
        .iter()
        .zip(DEFAULT_POSITION.iter())
        .enumerate()
        .map(|(j, (q, home))| (j, (q - home).abs()))
        .filter(|(_, off)| *off > RAMP_REFUSE_RAD)
        .max_by(|a, b| a.1.total_cmp(&b.1))
        .map(|(j, off)| {
            format!(
                "{} reads {:.0}° from home (limit {:.0}°): move it back towards home first",
                duck_control::JOINT_NAMES[j],
                off.to_degrees(),
                RAMP_REFUSE_RAD.to_degrees()
            )
        })
}

/// Model API version this build implements (`updater-design.md` §5.5). Bump when the
/// sensor-input / actuator-output contract a model sees changes.
const MODEL_API: u32 = 1;

/// Socket mode. Same reasoning as `updaterd`'s: the group decides who may ask.
const SOCKET_MODE: u32 = 0o660;

const MAX_LINE: usize = 64 * 1024;

/// How often the loop logs a summary at `info`.
///
/// Per-tick logging would be ~4.3M lines a day at 50 Hz. That is not merely noise: under a
/// journal size cap it is what *evicts* the logs support needs.
const LOOP_SUMMARY_INTERVAL: Duration = Duration::from_secs(300);

/// How fast the beak follows the vowel being sung, as a time constant.
///
/// A vowel is a step — `ah` opens the mouth to 0.90 and `mm` to 0.02 — and a servo asked to jump
/// between them on a 20 ms tick twitches rather than sings. This is roughly how fast a jaw moves.
const CHORALE_MOUTH_TAU_S: f64 = 0.09;

/// How far a subscriber may fall behind before it starts losing frames.
///
/// Five seconds at 50 Hz. State is advisory: a client that cannot keep up gets a gap, never
/// backpressure onto the control loop. Same rule the updater applies to progress.
const STATE_BUFFER: usize = 256;

/// Window over which the achieved rate is measured, and therefore how quickly a degraded
/// loop becomes visible to the health gate. Doubles as the slow-sensor sampling interval
/// ([`publish_slow_sensors`]).
const RATE_WINDOW: Duration = Duration::from_secs(1);

/// How long the ramp to the home pose takes when the policy is first enabled.
///
/// The same two seconds `robotd init` uses, and for the same reason: fast enough that nobody wonders
/// whether the button did anything, slow enough that a robot going from limp to standing does not
/// snap. Not a parameter yet — one number with no evidence that anyone wants a different one.
const HOME_RAMP: Duration = Duration::from_secs(2);

/// Smoothing on the reported battery voltage. At one sample per [`RATE_WINDOW`] this is a
/// ~10 s time constant, which is what makes the number readable: the raw voltage sags
/// several tenths of a volt on every step and recovers between them, so an unsmoothed
/// reading swings while the pack is doing nothing unusual. Borrowed, with the figure, from
/// `microduck_runtime`.
const BATTERY_EMA_ALPHA: f64 = 0.1;

/// How long the shutdown sit gets before torque is cut and the machine powers off. The
/// sitstand descent is a deliberate ~2 s glide; the prototype gives it four seconds.
const SHUTDOWN_SIT: Duration = Duration::from_secs(4);

/// How many consecutive failed bus reads the policy may drive through on the last good
/// sample before it stops.
///
/// **One dropped Dynamixel transaction is ordinary** — `robotd` says so itself when it logs
/// one — and it must therefore be *invisible*. It was not: a failed read used to stop the
/// policy for that tick, which commanded the hold pose and reset the controller, so every
/// ordinary dropped read produced a visible twitch. Measured on a bench robot at ~8 drops a
/// minute with a monitor attached, which is exactly the reported "random tiny spasms".
///
/// Coasting is safe because the observation is *already* a tick old by construction: at
/// 50 Hz the policy is trained on data of exactly this age, and a second tick of it is
/// inside that. Three ticks (60 ms) covers a drop, a retry and a slow tick; past that the
/// robot genuinely cannot see, and holding still is the honest answer.
const COAST_TICKS: u32 = 3;

/// How long driving must have been interrupted before the controller is reset.
///
/// The reset zeroes the action history the policy observes and drops the low-pass anchor,
/// which is right after a real pause and is itself a discontinuity after a 20 ms hiccup —
/// the very jolt it exists to prevent.
const RESET_AFTER_PAUSE: Duration = Duration::from_millis(200);

/// A boot counts as seated when the legs are within this of the sitting pose
/// ([`duck_control::SIT_POSITION`], mean over the leg joints) and nearer to it than to standing.
/// The prototype counted any pose 0.30 rad from standing, which with a sitstand policy loaded
/// took a robot powered up limp with its legs folded for a seated one (2026-10-11) — and the
/// sitstand rise from there tips it over. A real sit is ~0.12 from the pose; limp, folded
/// legs 0.46–0.62.
const SEATED_BOOT_RAD: f64 = 0.25;

/// A mouth that wakes to speak stays powered this long after the last sound or open intent, so a
/// burst of chirps does not toggle its torque between each.
const MOUTH_WAKE_HOLD: Duration = Duration::from_millis(300);

/// Leg torque restored after a rest: blend the leg targets from where the legs lie to where
/// the policy wants them over this long, seconds, so they do not jump.
const REST_LEG_BLEND_S: f64 = 0.8;

/// A deep rest counts as lying once the legs are within this of [`duck_control::LIE_POSITION`]
/// (mean over the leg joints) and the trunk's gravity within [`LIE_GRAVITY_TOL`] of lying.
const LIE_LEGS_RAD: f64 = 0.25;
/// |g - g_lie| — 0.25 is about 14°.
const LIE_GRAVITY_TOL: f64 = 0.25;

/// Where the limp-fall sequence is (`[safety] limp_fall`).
///
/// The daemon's only answer to a fall, and it runs *during* one rather than after it: the
/// trigger is [`duck_control::fall::FallPredictor`], not the `fallen` verdict, because a
/// verdict that waits for the robot to be down cannot make it soft before it lands.
///
/// The verdict is still tracked and published throughout — it just does not gate anything.
#[derive(Debug, Clone, Copy, PartialEq)]
enum LimpFall {
    Idle,
    /// Gains at `gain_limp`, joints commanded to wherever they already are — the softest
    /// thing the servos can do short of cutting torque, which would drop the head on the
    /// floor and lose the pose the next phase ramps from.
    Limp {
        since: Instant,
        landing: Landing,
    },
    /// Ramping from where the robot landed back to the standing pose, so the standing
    /// policy starts from the still, known posture it stands up from cleanly.
    Posing {
        from: [f64; NUM_JOINTS],
        since: Instant,
    },
}

/// Watching a limping robot for the moment it stops moving.
///
/// The end of the limp is read from the gyro rather than timed, because the falls are not
/// all the same length: a stumble is over in a few hundred milliseconds and a topple off a
/// table takes most of a second, and ending the limp early is landing stiff after all.
/// Debounced, because a tumbling robot passes through instants of near-zero rate on its
/// way over — one quiet sample is not a landing.
#[derive(Debug, Clone, Copy, PartialEq, Default)]
struct Landing {
    still_for: Duration,
}

impl Landing {
    /// One tick. `rate` is the gyro magnitude in rad/s, or `None` for a tick with no fresh
    /// sample — which resets rather than accumulates: a robot nobody can read is not a
    /// robot anybody has seen go still.
    fn observe(&mut self, rate: Option<f64>, period: Duration, below: f64, held: Duration) -> bool {
        self.still_for = match rate {
            Some(rate) if rate < below => self.still_for.saturating_add(period),
            _ => Duration::ZERO,
        };
        self.still_for >= held
    }
}

impl LimpFall {
    /// The interpolated pose target for this tick, or `None` once the ramp is done.
    ///
    /// The same linear shape as [`Bringup::homing_target`], and separate from it on
    /// purpose: that ramp is bring-up from limp at the policy gain over a fixed two
    /// seconds, this one is a landed robot being put back into shape, and both its
    /// duration and its gain are tunable because both depend on how the robot lands.
    fn pose_target(&self, now: Instant, over: Duration) -> Option<[f64; NUM_JOINTS]> {
        let LimpFall::Posing { from, since } = self else {
            return None;
        };
        let t = now.duration_since(*since).as_secs_f64() / over.as_secs_f64();
        if t >= 1.0 {
            return None;
        }
        let mut target = [0.0; NUM_JOINTS];
        for (i, slot) in target.iter_mut().enumerate() {
            *slot = from[i] + (DEFAULT_POSITION[i] - from[i]) * t;
        }
        Some(target)
    }
}

#[derive(Parser, Debug)]
#[command(name = "robotd", about = "Robot control daemon", version)]
struct Args {
    /// Socket to serve the `robot.*` API on. `updaterd --robot-socket` must match.
    #[arg(long, default_value = "/run/robotd.sock")]
    socket: PathBuf,

    /// Params file. Defaults to `/etc/robot/robotd.toml`, which may be absent — an
    /// unprovisioned board comes up on defaults. A path given here must exist.
    #[arg(long)]
    params: Option<PathBuf>,

    /// Serial port override, for a board wired differently from the shipped default.
    #[arg(long)]
    port: Option<String>,

    /// Run against a robot made of nothing. For laptop development and tests — there is no
    /// simulator yet, and this is what stands in for one.
    #[arg(long)]
    fake: bool,

    /// With `--fake`: a file holding the gravity the fake IMU reports ("x y z", trunk frame;
    /// upright is `0 0 -1`), re-read five times a second. How tools/sim tips the robot over.
    #[arg(long, requires = "fake")]
    fake_tilt: Option<PathBuf>,

    /// Do not load a policy: run the loop and hold the startup pose.
    ///
    /// Distinct from a policy that failed to load, which is unhealthy. This is the
    /// configuration to use when the thing under test is the updater rather than the gait —
    /// nothing falls over when a deliberately broken release lands.
    #[arg(long)]
    no_policy: bool,

    /// Report unhealthy. For exercising the updater's rollback path on a bench robot
    /// without having to break a real build.
    #[arg(long)]
    unhealthy: bool,

    /// Report that it is not safe to restart, as if the robot were moving.
    #[arg(long)]
    busy: bool,

    #[command(subcommand)]
    command: Option<Command>,
}

#[derive(Subcommand, Debug)]
enum Command {
    /// Enable torque and move to the home pose, then exit.
    ///
    /// Explicit, and separate from running the daemon, because the control loop must never
    /// move the robot on its own: `robotd` restarting during an update would otherwise make
    /// a standing robot lurch, which is both a fall risk and a confounder when the thing
    /// under test is the updater.
    Init {
        #[arg(long, default_value = "2s", value_parser = parse_duration)]
        duration: Duration,
    },
}

fn parse_duration(raw: &str) -> Result<Duration, String> {
    let (value, scale) = match raw.strip_suffix("ms") {
        Some(v) => (v, 1u64),
        None => match raw.strip_suffix('s') {
            Some(v) => (v, 1000),
            None => (raw, 1000),
        },
    };
    value
        .parse::<u64>()
        .map(|n| Duration::from_millis(n * scale))
        .map_err(|_| format!("expected e.g. 500ms or 2s, got {raw:?}"))
}

/// What the control loop publishes about itself.
///
/// Atomics rather than a mutex on purpose: the IPC side must never be able to block on the
/// control loop. A robot whose loop is wedged still has to be able to say "I am not
/// healthy" — if answering required the loop's lock, the one situation where `updaterd`
/// needs an answer is the situation it would hang in.
/// [`Mode`] as the byte [`RobotState::mode`] holds, and back.
///
/// Two tiny functions rather than a numeric cast, so the mapping is written down once: a mode
/// added later gets a code here and nowhere else, and an unknown byte reads as walking rather
/// than panicking on the IPC thread.
fn mode_code(mode: Mode) -> u8 {
    match mode {
        Mode::Walk => 0,
        Mode::Roller => 1,
    }
}

fn mode_of(code: u8) -> Mode {
    match code {
        1 => Mode::Roller,
        _ => Mode::Walk,
    }
}

/// The policy file names for one mode, as a set.
///
/// `None` in a skill slot doubles as "this robot cannot do that", which is what lets `dispatch`
/// refuse a `robot.do` for a skill this mode has no network for instead of queueing a request the
/// loop will drop — and roller mode is exactly that case: no standing network, a crouch where the
/// ground pick was.
#[derive(Debug, Clone, Default)]
struct PolicyNames {
    walk: Option<String>,
    stand: Option<String>,
    sitstand: Option<String>,
    ground_pick: Option<String>,
    kick_left: Option<String>,
    kick_right: Option<String>,
    roulade: Option<String>,
    lie: Option<String>,
}

impl PolicyNames {
    /// The names for `policy`, or all-`None` when no policy is wanted.
    fn of(policy: &params::ResolvedPolicy) -> Self {
        if !policy.enabled {
            return Self::default();
        }
        let name = |path: &Option<std::path::PathBuf>| path.as_deref().and_then(file_name);
        Self {
            walk: file_name(&policy.walk),
            stand: name(&policy.stand),
            sitstand: name(&policy.sitstand),
            ground_pick: name(&policy.ground_pick),
            kick_left: name(&policy.kick_left),
            kick_right: name(&policy.kick_right),
            roulade: name(&policy.roulade),
            lie: name(&policy.lie),
        }
    }
}

struct RobotState {
    /// Epoch for every timestamp below. `Instant` so the clock cannot go backwards.
    started: Instant,
    ticks: AtomicU64,
    /// Ticks whose work overran the period. Cumulative, for diagnosis; the rate check is
    /// what catches a sustained problem.
    missed: AtomicU64,
    /// Microseconds since `started` at the last completed tick.
    last_tick_us: AtomicU64,
    /// Achieved rate over the last window, as `f64::to_bits`. Zero until the first window
    /// closes, which is why the stall check carries the first second.
    achieved_hz: AtomicU64,
    /// Consecutive failed bus reads. Reset by any success.
    consecutive_errors: AtomicU32,
    /// Failed attempts to bring the bus up — opening it, verifying its registers, or
    /// reading the startup pose. Non-zero means the loop is still waiting for a robot to
    /// answer and has never commanded anything.
    startup_bus_failures: AtomicU32,
    /// Motor-bus voltage, EMA-smoothed, as `f64::to_bits`. Zero means *not read yet* — a
    /// distinction that has to survive to the wire, since zero volts and unknown volts look
    /// nothing alike to whoever is deciding whether to charge the robot.
    battery_v: AtomicU64,
    /// Hottest servo of the last thermal sample: temperature as `f64::to_bits`, and which
    /// joint it was. Zero means *not read yet*, same as the battery.
    motor_max_c: AtomicU64,
    motor_mean_c: AtomicU64,
    /// Index into [`duck_control::JOINT_NAMES`] of the hottest joint.
    motor_hottest: AtomicU32,
    /// Hottest board thermal zone, as `f64::to_bits`. Zero means no reading — off Linux, or a
    /// kernel with no thermal sysfs ([`soc`]).
    cpu_temp_c: AtomicU64,
    /// Mirrors of the bus's own IMU diagnostics, refreshed with the thermal sample. Held here
    /// so the IPC side can report them without touching the loop's IO.
    imu_stale_blocks: AtomicU64,
    /// Stale reads in a row as of the last sample. Sampled rather than watched, which is fine
    /// for the fault it describes: a board that has stopped refreshing keeps repeating, so its
    /// run is still growing whenever the next sample lands.
    imu_stale_run: AtomicU64,
    imu_ready: AtomicBool,
    shutdown: AtomicBool,
    /// Fan-out for `robot.state`. Bounded and lossy by design — see [`STATE_BUFFER`].
    state_tx: tokio::sync::broadcast::Sender<proto::RobotState>,
    /// What `btd` should be advertising, published when it changes.
    ///
    /// A broadcast channel like the state stream, and for the same reason: `btd` subscribes, and a
    /// `robotd` with nobody subscribed must not be blocked by that. Small buffer — a subscriber
    /// that has fallen behind on beacons wants the newest one, not a backlog of beats that have
    /// already passed.
    chorale_tx: tokio::sync::broadcast::Sender<proto::ChoraleAdvertise>,
    /// Why the policy is not loaded, if it is not. Set once at startup; the loop keeps
    /// running and holds the pose, so a broken bundle is a rollback rather than a crash.
    policy_error: ArcSwapOption<String>,
    /// Which policy files this process is running, as file names. `None` when the policy is
    /// disabled.
    ///
    /// From the params rather than from the loaded network, and therefore known before the
    /// control thread has finished loading anything — a client that subscribes during startup
    /// gets the answer rather than a race. What *failed* to load is `policy_error`; this is
    /// what was asked for, and the pair is what distinguishes "no policy wanted" from "the
    /// policy this release ships would not load".
    ///
    /// **One swap for the whole set rather than seven fields**, because a mode switch replaces
    /// all of them at once: a reader that caught `walk` from roller beside `stand` from walking
    /// would be told about a robot that does not exist. Swapped by the control loop, which is
    /// the only thing that loads a policy.
    policies: ArcSwap<PolicyNames>,
    /// Whether this robot can make a sound at all: audio enabled, and a bank with wavs in
    /// it. Same job as the `policy_*` fields above — false is "this robot cannot do that",
    /// which is what lets `dispatch` refuse a `robot.sound` with a reason instead of
    /// accepting it into silence. Read once at startup, like the policies: the postinstall
    /// renders the bank and restarts robotd, so a bank cannot appear under a running one.
    /// `[thermal] deep_sit`: a deep rest sits, so it needs no lie policy.
    deep_sit: bool,
    has_voice: bool,
    /// The seed this robot's bank was rendered from (the voice `robot.speak` speaks in), read
    /// once at startup like `has_voice`; `None` without a voice.
    voice_seed: Option<u32>,
    /// Whether a theremin can be picked up: the params allow one, and the depth stream is
    /// actually delivering frames. Published by the loop rather than read once at startup,
    /// because unlike a voice bank the sensor comes and goes — `tofd` restarts, the ToF
    /// drops off the I²C bus — and an accepted theremin on a duck with no depth is a
    /// feature that silently does nothing.
    theremin_ready: AtomicBool,
    /// Whether this robot's config allows it to sing with others. Read once at startup, like the
    /// policies: `[chorale] accept`, false by default.
    chorale_accepted: bool,
    /// `walk` or `roller`, as `robot.mode` reports it.
    ///
    /// Not constant any more: `robot.setMode` switches it while the robot runs, so this is stored
    /// rather than read from the params it started as. An `AtomicU8` over [`Mode`] because it is
    /// read on the IPC side and written by the control loop, and there is nothing to allocate.
    mode: AtomicU8,
    /// Published by the loop so the IPC side can answer without consulting it.
    fallen: AtomicBool,
    /// The policy is driving and has been asked for a non-zero velocity.
    moving: AtomicBool,
    /// Torque is on and the joints are at the home pose, so the policy can drive.
    ///
    /// False covers two different states on purpose — never brought up, and ramping — because a
    /// client can act on neither: the answer to both is "wait, or press Start". The journal
    /// distinguishes them.
    homed: AtomicBool,

    /// The packs this robot takes (`[battery]`), and what is plugged in — see [`PackState`].
    battery_cells: Vec<u8>,
    battery_max_volts: f64,
    pack: std::sync::Mutex<PackState>,

    period_us: u64,
    min_achieved_hz: f64,
    stall_periods: u32,
    max_consecutive_errors: u32,
    force_unhealthy: bool,
    force_busy: bool,
}

/// Readings at rest a pack is identified from: the median of the first few, so one bad bus read
/// cannot name the wrong pack. At one a second this is the robot's first three seconds — limp,
/// before anyone has pressed Start.
const PACK_READINGS: usize = 3;

/// What is plugged in: the first readings, then the verdict on them, kept until robotd stops (a
/// pack is not changed with the robot on — there is no switch, unplugging it is the power off).
#[derive(Debug, Default)]
struct PackState {
    readings: Vec<f64>,
    /// `None` until [`PACK_READINGS`] have come in.
    verdict: Option<PackVerdict>,
}

#[derive(Debug, Clone)]
struct PackVerdict {
    /// What it is, if it could be told — its thresholds apply even to a pack that is refused, so
    /// a 2S on a 3S robot is still sat down at a 2S's empty, not drained flat.
    pack: Option<Pack>,
    /// Why the robot will not power up on it, if it will not.
    problem: Option<String>,
}

/// The verdict on a pack read at `rest_v`, for a robot whose servos take `cells` and at most
/// `max_volts` (`0` = no limit).
fn judge_pack(rest_v: f64, cells: &[u8], max_volts: f64) -> PackVerdict {
    match duck_control::identify_pack(rest_v) {
        Err(why) => PackVerdict {
            pack: None,
            problem: Some(why),
        },
        Ok(pack) => {
            let takes = cells
                .iter()
                .map(|n| format!("{n}S"))
                .collect::<Vec<_>>()
                .join(" or ");
            let problem = if !cells.contains(&pack.cells) {
                Some(format!(
                    "a {} pack ({rest_v:.2} V) on a robot whose servos take {takes}",
                    pack.label()
                ))
            } else if max_volts > 0.0 && rest_v > max_volts + 0.1 {
                Some(format!(
                    "the {} pack reads {rest_v:.2} V, over the servos' {max_volts:.1} V rating",
                    pack.label()
                ))
            } else {
                None
            };
            PackVerdict {
                pack: Some(pack),
                problem,
            }
        }
    }
}

impl RobotState {
    fn new(params: &Params, force_unhealthy: bool, force_busy: bool) -> Self {
        Self {
            started: Instant::now(),
            ticks: AtomicU64::new(0),
            missed: AtomicU64::new(0),
            last_tick_us: AtomicU64::new(0),
            achieved_hz: AtomicU64::new(0),
            consecutive_errors: AtomicU32::new(0),
            startup_bus_failures: AtomicU32::new(0),
            battery_v: AtomicU64::new(0),
            motor_max_c: AtomicU64::new(0),
            motor_mean_c: AtomicU64::new(0),
            motor_hottest: AtomicU32::new(0),
            cpu_temp_c: AtomicU64::new(0),
            imu_stale_blocks: AtomicU64::new(0),
            imu_stale_run: AtomicU64::new(0),
            imu_ready: AtomicBool::new(false),
            shutdown: AtomicBool::new(false),
            state_tx: tokio::sync::broadcast::Sender::new(STATE_BUFFER),
            chorale_tx: tokio::sync::broadcast::Sender::new(8),
            policy_error: ArcSwapOption::empty(),
            policies: ArcSwap::from_pointee(PolicyNames::of(&params.policy.resolved())),
            has_voice: params.audio.enabled && has_any_wav(&params.audio.bank),
            voice_seed: (params.audio.enabled && has_any_wav(&params.audio.bank))
                .then(|| bank_seed(&params.audio.bank))
                .flatten(),
            deep_sit: params.thermal.deep_sit,
            theremin_ready: AtomicBool::new(false),
            chorale_accepted: params.chorale.accept,
            mode: AtomicU8::new(mode_code(params.policy.mode)),
            fallen: AtomicBool::new(false),
            moving: AtomicBool::new(false),
            homed: AtomicBool::new(false),
            period_us: params.period().as_micros() as u64,
            min_achieved_hz: params.update_gate.min_achieved_hz,
            stall_periods: params.update_gate.stall_periods,
            max_consecutive_errors: params.update_gate.max_consecutive_errors,
            battery_cells: params.battery.cells.clone(),
            battery_max_volts: params.battery.max_volts,
            pack: std::sync::Mutex::new(PackState::default()),
            force_unhealthy,
            force_busy,
        }
    }

    /// A raw bus reading, taken once a second: until the pack is identified it is one of the
    /// readings that identify it. Logged once, when the verdict is in.
    fn note_battery_reading(&self, volts: f64) {
        let mut st = self.pack.lock().unwrap_or_else(|e| e.into_inner());
        if st.verdict.is_some() || !(volts.is_finite() && volts > 0.0) {
            return;
        }
        st.readings.push(volts);
        if st.readings.len() < PACK_READINGS {
            return;
        }
        let mut sorted = st.readings.clone();
        sorted.sort_by(f64::total_cmp);
        let rest_v = sorted[sorted.len() / 2];
        let verdict = judge_pack(rest_v, &self.battery_cells, self.battery_max_volts);
        match (&verdict.pack, &verdict.problem) {
            (Some(pack), None) => tracing::info!(
                pack = %pack.label(),
                volts = rest_v,
                empty_v = pack.empty_v(),
                "battery identified"
            ),
            (_, Some(problem)) => {
                tracing::error!(volts = rest_v, %problem, "battery refused: the robot stays limp")
            }
            (None, None) => {}
        }
        st.verdict = Some(verdict);
    }

    /// The identified pack, once there is one.
    fn pack(&self) -> Option<Pack> {
        let st = self.pack.lock().unwrap_or_else(|e| e.into_inner());
        st.verdict.as_ref().and_then(|v| v.pack)
    }

    /// Why the robot must not power up on what is plugged in, if it must not.
    fn battery_refusal(&self) -> Option<String> {
        let st = self.pack.lock().unwrap_or_else(|e| e.into_inner());
        st.verdict
            .as_ref()
            .and_then(|v| v.problem.as_ref())
            .map(|p| format!("battery: {p}"))
    }

    fn health(&self) -> proto::HealthResult {
        // Everything the robot can say about itself, attached to every answer whatever the
        // verdict — and consulted by none of the checks below.
        //
        // Two separate jobs in one method, deliberately. `healthy`/`degraded` are the update
        // system's inputs and may only reflect what a *release* can be blamed for. The rest
        // is a description of the robot for whoever is looking at it, and it travels on the
        // same answer because a robot behaving oddly is asked exactly one question, once.
        let describe =
            |healthy: bool, degraded: bool, reason: Option<String>| proto::HealthResult {
                healthy,
                degraded,
                reason,
                battery: self.battery(),
                motors: self.motor_thermal(),
                cpu_temp_c: {
                    // Zero is "never read", the same sentinel the battery uses: a board at
                    // 0 °C is a sensor that is not there, not a cold robot.
                    let c = f64::from_bits(self.cpu_temp_c.load(Ordering::Relaxed));
                    (c > 0.0).then_some(c)
                },
                control_loop: Some(self.loop_health()),
                bus: proto::BusHealth {
                    consecutive_errors: self.consecutive_errors.load(Ordering::Relaxed),
                    startup_failures: self.startup_bus_failures.load(Ordering::Relaxed),
                },
                imu: Some(proto::ImuHealth {
                    ready: self.imu_ready.load(Ordering::Relaxed),
                    stale_blocks: self.imu_stale_blocks.load(Ordering::Relaxed),
                    consecutive_stale_blocks: self.imu_stale_run.load(Ordering::Relaxed),
                }),
            };

        let unhealthy = |reason: String| describe(false, false, Some(reason));
        // Not healthy, but not the release's fault either — see `HealthResult::degraded`.
        let degraded = |reason: String| describe(false, true, Some(reason));

        if self.force_unhealthy {
            return unhealthy("forced unhealthy by --unhealthy".into());
        }

        // "Starting" is not "started". The gate polls, so it will see the transition.
        if self.ticks.load(Ordering::Relaxed) == 0 {
            // Distinguish "starting" from "cannot see a robot". Both mean no ticks, but only
            // one of them is going to resolve on its own, and the update system quotes this
            // string as the reason it rolled a release back — so it has to name the cause.
            let waiting = self.startup_bus_failures.load(Ordering::Relaxed);
            if waiting > 0 {
                // Degraded, not unhealthy: an unpowered bench board must not roll back every
                // release shipped to it. The bus not answering is the same before and after.
                return degraded(format!(
                    "no robot on the motor bus after {waiting} attempts; \
                     is servo power on and the bus wired?"
                ));
            }
            return unhealthy("control loop has not completed a cycle yet".into());
        }

        // A daemon that came up but cannot run its policy is not healthy, however well the
        // loop is ticking. This is what makes the updater roll back a release whose bundle
        // is wrong, instead of leaving a robot that holds a pose and never walks again.
        if let Some(reason) = self.policy_error.load_full() {
            return unhealthy(format!("policy unavailable: {reason}"));
        }

        let errors = self.consecutive_errors.load(Ordering::Relaxed);
        if errors >= self.max_consecutive_errors {
            return unhealthy(format!("{errors} consecutive bus read failures"));
        }

        // A wedged loop stops stamping. This is what turns a hung control thread into an
        // honest answer instead of a socket that keeps saying "healthy" forever.
        let now_us = self.started.elapsed().as_micros() as u64;
        let stale_us = now_us.saturating_sub(self.last_tick_us.load(Ordering::Relaxed));
        let stall_limit_us = self.period_us.saturating_mul(self.stall_periods as u64);
        if stale_us > stall_limit_us {
            return unhealthy(format!("control loop stalled for {} ms", stale_us / 1000));
        }

        let hz = f64::from_bits(self.achieved_hz.load(Ordering::Relaxed));
        if hz > 0.0 && hz < self.min_achieved_hz {
            return unhealthy(format!(
                "control loop at {hz:.1} Hz, below the {:.1} Hz floor",
                self.min_achieved_hz
            ));
        }

        describe(true, false, None)
    }

    /// The loop's own numbers, as the readout reports them.
    fn loop_health(&self) -> proto::LoopHealth {
        let hz = f64::from_bits(self.achieved_hz.load(Ordering::Relaxed));
        let now_us = self.started.elapsed().as_micros() as u64;
        proto::LoopHealth {
            target_hz: 1_000_000.0 / self.period_us as f64,
            // Zero is the "no window has closed yet" sentinel, not a measured rate.
            achieved_hz: (hz > 0.0).then_some(hz),
            ticks: self.ticks.load(Ordering::Relaxed),
            missed: self.missed.load(Ordering::Relaxed),
            last_tick_age_ms: now_us.saturating_sub(self.last_tick_us.load(Ordering::Relaxed))
                / 1000,
        }
    }

    /// The hottest servo of the last thermal sample, or `None` before the first one.
    fn motor_thermal(&self) -> Option<proto::MotorThermal> {
        let max_c = f64::from_bits(self.motor_max_c.load(Ordering::Relaxed));
        if max_c <= 0.0 {
            return None;
        }
        let hottest = self.motor_hottest.load(Ordering::Relaxed) as usize;
        Some(proto::MotorThermal {
            hottest: duck_control::JOINT_NAMES
                .get(hottest)
                .unwrap_or(&"unknown")
                .to_string(),
            max_c,
            mean_c: f64::from_bits(self.motor_mean_c.load(Ordering::Relaxed)),
        })
    }

    /// The last battery reading, mapped to a percentage — or `None` if there has not been
    /// one.
    ///
    /// Zero is the "never read" sentinel rather than a measurement: the atomic starts there,
    /// and a robot whose bus cannot answer never leaves it. Reporting that as `0.00 V, 0%`
    /// would put a flat-battery warning in front of anyone whose robot has been up for less
    /// than a second.
    ///
    /// Absent too for the first seconds while the pack is being identified: the percentage is
    /// a mapping over a pack, and before there is one there is nothing honest to map onto.
    fn battery(&self) -> Option<proto::Battery> {
        let volts = f64::from_bits(self.battery_v.load(Ordering::Relaxed));
        if volts <= 0.0 {
            return None;
        }
        let st = self.pack.lock().unwrap_or_else(|e| e.into_inner());
        let verdict = st.verdict.as_ref()?;
        Some(proto::Battery {
            volts,
            percent: verdict.pack.map_or(0.0, |p| p.percent(volts)),
            pack: verdict.pack.map(|p| p.label()),
            problem: verdict.problem.clone(),
        })
    }

    fn safe_to_restart(&self) -> proto::SafeToRestartResult {
        if self.force_busy {
            return proto::SafeToRestartResult {
                safe: false,
                reason: Some("forced busy by --busy".into()),
            };
        }
        // Restarting motor control mid-stride is how a robot falls over
        // (`updater-design.md` §7.2). A robot that is merely standing, or already down, is
        // safe to interrupt — it is going nowhere either way.
        if self.moving.load(Ordering::Relaxed) && !self.fallen.load(Ordering::Relaxed) {
            return proto::SafeToRestartResult {
                safe: false,
                reason: Some("the robot is walking".into()),
            };
        }
        proto::SafeToRestartResult {
            safe: true,
            reason: None,
        }
    }
}

#[tokio::main]
async fn main() -> ExitCode {
    // Rust ignores SIGPIPE, which turns `robotd ... | head` into a panic.
    unsafe { libc::signal(libc::SIGPIPE, libc::SIG_DFL) };

    let args = Args::parse();

    tracing_subscriber::fmt()
        .with_env_filter(
            tracing_subscriber::EnvFilter::try_from_default_env()
                .unwrap_or_else(|_| tracing_subscriber::EnvFilter::new("info")),
        )
        .with_writer(std::io::stderr)
        .init();

    duck_ipc_proto::log_startup_identity!("robotd");

    let explicit = args.params.is_some();
    let params_path = args
        .params
        .clone()
        .unwrap_or_else(|| PathBuf::from(params::DEFAULT_PATH));
    let mut params = match Params::load(&params_path, explicit) {
        Ok(params) => params,
        Err(e) => {
            tracing::error!(error = %e, "bad params");
            return ExitCode::FAILURE;
        }
    };
    if let Some(port) = args.port.clone() {
        params.bus.port = port;
    }
    if args.no_policy {
        params.policy.enabled = false;
    }

    if let Some(Command::Init { duration }) = args.command {
        return run_init(&params, duration);
    }

    let state = Arc::new(RobotState::new(&params, args.unhealthy, args.busy));

    if args.unhealthy {
        tracing::warn!("--unhealthy: will report unhealthy, so updates will roll back");
    }
    if args.busy {
        tracing::warn!("--busy: will refuse restarts, so updates will be held off");
    }

    let intents = Arc::new(Intents::new());

    // The real thing. `setsid` detaches the command from this process's cgroup, so the
    // poweroff proceeds while systemd is busy killing robotd itself.
    let poweroff: PowerOff = Arc::new(|| {
        let result = std::process::Command::new("setsid")
            .args(["sh", "-c", "systemctl poweroff"])
            .spawn();
        if let Err(e) = result {
            tracing::error!(error = %e, "cannot power off");
        }
    });

    let control = match spawn_control_thread(
        &args,
        &params,
        Arc::clone(&state),
        Arc::clone(&intents),
        poweroff,
    ) {
        Ok(handle) => handle,
        Err(e) => {
            tracing::error!(error = %e, "cannot start the control loop");
            return ExitCode::FAILURE;
        }
    };

    let serving = serve(
        Arc::clone(&state),
        Arc::clone(&intents),
        args.socket.clone(),
    );
    let mut code = ExitCode::SUCCESS;
    tokio::select! {
        result = serving => {
            if let Err(e) = result {
                tracing::error!(error = %e, "IPC server stopped");
                code = ExitCode::FAILURE;
            }
        }
        _ = shutdown() => tracing::info!("shutting down"),
    }

    // Ask the loop to stop and let it finish the tick it is in, rather than aborting
    // mid-transaction and leaving a half-written packet on the bus.
    state.shutdown.store(true, Ordering::Relaxed);
    let _ = control.join();
    let _ = std::fs::remove_file(&args.socket);
    code
}

/// Enable torque and ramp to the home pose.
#[cfg(target_os = "linux")]
fn run_init(params: &Params, duration: Duration) -> ExitCode {
    let config = match bus_config(&params.bus) {
        Ok(config) => config,
        Err(e) => {
            tracing::error!(error = %e, "the [bus] section cannot describe this robot");
            return ExitCode::FAILURE;
        }
    };
    let mut io = match ServoBus::open(&params.bus.port, &config) {
        Ok(io) => io,
        Err(e) => {
            tracing::error!(error = %e, port = %params.bus.port, "cannot open the bus");
            return ExitCode::FAILURE;
        }
    };
    if let Err(e) = io.check_registers() {
        tracing::error!(error = %e, "motor register check failed");
        return ExitCode::FAILURE;
    }
    if let Err(e) = io.set_torque(true) {
        tracing::error!(error = %e, "cannot enable torque");
        return ExitCode::FAILURE;
    }
    // Before the ramp, not after: position_p_gain is a RAM register that survives this
    // process, so whatever was written last is what the robot stands up with. A previous fall
    // leaves `gain_limp` (50) there, and `init` would then take the robot to its home pose at
    // a third of the intended stiffness — soft enough to be a fall risk in the one command
    // whose whole job is establishing a known state.
    //
    // `robotd`'s control loop sets its own gain on the first tick, so this only governs the
    // ramp and the window before the daemon starts — which is exactly the window where the
    // robot is standing up unsupported.
    if let Err(e) = io.set_gain(params.policy.gain) {
        tracing::error!(error = %e, gain = params.policy.gain, "cannot set the position gain");
        return ExitCode::FAILURE;
    }
    if let Err(e) = io.interpolate_to(&DEFAULT_POSITION, duration, Duration::from_millis(20)) {
        tracing::error!(error = %e, "interpolation to the home pose failed");
        return ExitCode::FAILURE;
    }
    tracing::warn!(?duration, "at home pose, torque enabled");
    ExitCode::SUCCESS
}

#[cfg(not(target_os = "linux"))]
fn run_init(_params: &Params, _duration: Duration) -> ExitCode {
    tracing::error!("init needs a real bus; this build is not on the robot");
    ExitCode::FAILURE
}

/// Start the control loop on its own OS thread, with its own current-thread runtime.
///
/// Its own thread because the bus read is *blocking* serial I/O — on a shared runtime it
/// would occupy a worker for the duration of every transaction. Its own runtime so IPC work
/// can never be scheduled in front of a tick. This mirrors the prototype, where the loop
/// likewise had a runtime to itself and everything else lived on threads.
fn spawn_control_thread(
    args: &Args,
    params: &Params,
    state: Arc<RobotState>,
    intents: Arc<Intents>,
    poweroff: PowerOff,
) -> std::io::Result<std::thread::JoinHandle<()>> {
    let period = params.period();
    let fake = args.fake;
    let fake_tilt = args.fake_tilt.clone();
    let bus = params.bus.clone();
    let params = params.clone();

    std::thread::Builder::new()
        .name("control".into())
        .spawn(move || {
            let runtime = match tokio::runtime::Builder::new_current_thread()
                .enable_time()
                .build()
            {
                Ok(runtime) => runtime,
                Err(e) => {
                    tracing::error!(error = %e, "cannot build the control runtime");
                    return;
                }
            };

            if fake {
                tracing::warn!("--fake: no bus, no robot");
                // A mid-pack voltage (3.7 V a cell) of the configured pack, so `--fake` also
                // runs with a 3S-only config instead of refusing the fake 2S battery.
                let mut io = FakeIo::at(DEFAULT_POSITION);
                if let Some(path) = fake_tilt {
                    io = io.tilted_by(path);
                }
                if let (Some(slow), Some(&cells)) =
                    (io.slow.as_mut(), params.battery.cells.first())
                {
                    slow.volts = 3.7 * f64::from(cells);
                }
                runtime.block_on(control_loop(
                    io,
                    state,
                    intents,
                    params,
                    period,
                    poweroff,
                ));
                return;
            }

            // Waiting, not one shot. `open_bus` verifies motor registers, which means it
            // talks to the servos — so on an unpowered board it fails and this used to fall
            // straight off the end of the thread. No control loop was ever created, and
            // because nothing had been *attempted* the health reason was the bland "control
            // loop has not completed a cycle yet", forever, whatever happened to the robot
            // afterwards. Retrying the read alone was not enough: execution never got there.
            runtime.block_on(async move {
                if let Some(io) = open_bus_waiting(&bus, &state).await {
                    control_loop(io, state, intents, params, period, poweroff).await;
                }
            });
        })
}

/// The real bus on the board; a fake elsewhere, so `open_bus_waiting` has one signature.
#[cfg(target_os = "linux")]
type BusIo = ServoBus;
#[cfg(not(target_os = "linux"))]
type BusIo = FakeIo;

/// Open and verify the bus, waiting for a robot to answer.
///
/// Same reasoning as [`adopt_startup_pose`], one step earlier: an unpowered board cannot
/// pass `check_registers`, and that is a condition someone fixes by flipping a switch, not
/// one to abandon the control loop over.
///
/// Returns `None` only if shutdown is requested while waiting.
async fn open_bus_waiting(bus: &params::Bus, state: &RobotState) -> Option<BusIo> {
    let mut attempt = 0u32;

    while !state.shutdown.load(Ordering::Relaxed) {
        // Logging lives in `open_bus`, which is chatty by design on the first attempt and
        // quiet thereafter — a board waiting overnight must not fill the journal.
        if let Some(io) = open_bus(bus, attempt) {
            state.startup_bus_failures.store(0, Ordering::Relaxed);
            return Some(io);
        }
        attempt += 1;
        // Published before sleeping, so `robot.health` can name the cause immediately.
        state.startup_bus_failures.store(attempt, Ordering::Relaxed);

        // Nothing to retry on a platform that has no bus at all.
        if !cfg!(target_os = "linux") {
            return None;
        }
        tokio::time::sleep(STARTUP_RETRY_INTERVAL).await;
    }

    None
}

/// Open and verify the bus, or explain why not.
#[cfg(target_os = "linux")]
fn open_bus(bus: &params::Bus, attempt: u32) -> Option<BusIo> {
    // First attempt and every thirtieth — about one line per 30 s while waiting.
    let loud = attempt == 0 || attempt.is_multiple_of(STARTUP_READ_LOG_EVERY);
    let port = bus.port.as_str();

    // Converted on every attempt rather than once: a bad `[bus]` section then reaches health
    // through the same counter an unpowered bus does, instead of silently never starting.
    let config = match bus_config(bus) {
        Ok(config) => config,
        Err(e) => {
            if loud {
                tracing::error!(error = %e, attempt, "the [bus] section cannot describe this robot");
            }
            return None;
        }
    };
    let mut io = match ServoBus::open(port, &config) {
        Ok(io) => io,
        Err(e) => {
            if loud {
                tracing::error!(error = %e, port, attempt, "cannot open the bus; waiting");
            }
            return None;
        }
    };
    match io.check_registers() {
        Ok(0) => tracing::info!("motor registers already correct"),
        Ok(n) => tracing::warn!(corrected = n, "motor registers corrected"),
        Err(e) => {
            if loud {
                tracing::error!(
                    error = %e,
                    attempt,
                    "motor register check failed; waiting, is servo power on?"
                );
            }
            return None;
        }
    }
    Some(io)
}

#[cfg(not(target_os = "linux"))]
fn open_bus(_bus: &params::Bus, _attempt: u32) -> Option<BusIo> {
    tracing::error!("no bus on this platform; use --fake");
    None
}

/// What `[bus]` says to open, or why it cannot say.
#[cfg_attr(not(target_os = "linux"), allow(dead_code))]
///
/// Feetech servos have no fixed IDs per limb the way the original's did, so the mapping is
/// configuration — and an incomplete one is an error rather than a guess, since a guess drives
/// one joint with another's targets.
fn bus_config(bus: &params::Bus) -> Result<BusConfig, String> {
    match bus.servo {
        params::ServoKind::DynamixelXl330 => Ok(BusConfig::Dynamixel),
        params::ServoKind::FeetechHls => {
            let ids: [u8; NUM_JOINTS] = bus.joint_ids.as_slice().try_into().map_err(|_| {
                format!(
                    "bus.joint_ids has {} entries; it needs {NUM_JOINTS}, one servo ID per joint",
                    bus.joint_ids.len()
                )
            })?;
            let config = duck_control::feetech::FeetechConfig {
                ids,
                signs: per_joint(&bus.joint_signs, 1, "bus.joint_signs")?,
                offsets: per_joint(&bus.joint_offsets, 0, "bus.joint_offsets")?,
                imu: bus.imu,
                imu_source: match bus.imu_source {
                    params::ImuSource::Bus => duck_control::feetech::ImuSource::Bus,
                    params::ImuSource::Bno055 => duck_control::feetech::ImuSource::Bno055 {
                        device: bus.imu_i2c.clone(),
                        address: bus.imu_i2c_address,
                    },
                },
                current_limit_ma: bus.current_limit_ma,
                // Mouth: JOINT_NAMES 9.
                // A mouth that wakes to speak is the control loop's to let go (`mouth_asleep`).
                limp: std::array::from_fn(|j| j == 9 && !bus.mouth_torque && !bus.mouth_wake),
                imu_mount: duck_control::imu::with_roll_trim(
                    duck_control::imu::with_pitch_trim(
                        duck_control::imu::mount_from_axes(&bus.imu_axes)?,
                        bus.imu_pitch_trim_deg,
                    ),
                    bus.imu_roll_trim_deg,
                ),
                imu_median: bus.imu_median,
                // Neck, head pitch/yaw/roll and mouth: JOINT_NAMES 5..=9.
                position_kp: std::array::from_fn(|j| {
                    if (5..=9).contains(&j) {
                        bus.position_kp_head
                    } else {
                        bus.position_kp
                    }
                }),
                position_kd: bus.position_kd,
            };
            config.validate()?;
            Ok(BusConfig::Feetech(config))
        }
    }
}

/// One value per joint, or none at all meaning `empty` everywhere.
#[cfg_attr(not(target_os = "linux"), allow(dead_code))]
fn per_joint<T: Copy>(values: &[T], empty: T, key: &str) -> Result<[T; NUM_JOINTS], String> {
    if values.is_empty() {
        return Ok([empty; NUM_JOINTS]);
    }
    values.try_into().map_err(|_| {
        format!(
            "{key} has {} entries; it needs {NUM_JOINTS}, or none",
            values.len()
        )
    })
}

/// How long to wait between attempts to read the startup pose.
///
/// A second, not a control period: the read itself already carries a 30 ms bus timeout, and
/// a board waiting for someone to switch servo power on is not in a hurry. Fast enough that
/// powering the robot brings it up while your hand is still on the switch.
const STARTUP_RETRY_INTERVAL: Duration = Duration::from_secs(1);

/// Log one waiting line, then one every this many attempts — about one per 30 s.
const STARTUP_READ_LOG_EVERY: u32 = 30;

/// Adopt the pose the robot is already in, waiting for the bus to answer.
///
/// Never move on start: the servos hold their last commanded goal while this process is
/// dead, so a restart mid-update leaves a standing robot standing, with no gap. That
/// requires a successful read, so there is nothing to command until one lands.
///
/// This used to be a single read that logged and returned on failure — which killed the
/// control thread for the life of the process. `robotd` stayed up and kept answering the
/// socket, so a board booted before its servos were powered was permanently inert: powering
/// them changed nothing and only `systemctl restart robotd` helped, with no hint anywhere
/// that a restart was what was needed. Retrying makes the ordinary order of operations —
/// power the board, then power the servos — just work.
///
/// Read through `Safety` rather than the bus directly: safety owns the only `RobotIo`, so
/// this is the only way to reach it, and going through it keeps that invariant intact even
/// for the one read that happens before the loop starts.
///
/// Returns `None` only if shutdown is requested while waiting.
/// How far the robot has got towards being drivable.
///
/// This is what made pressing Start on a fresh robot do nothing visible: the policy ran, the loop
/// wrote positions, and the servos ignored them because they had no torque. Torque came from
/// `robotd init` — a separate subcommand that opens the motor bus itself, so it needs the daemon
/// stopped, and which appeared in no documentation.
///
/// The invariant the old design protected is narrower than "never touch torque", and it survives
/// intact: **nothing here runs because a process started.** A `robotd` restarted by an update finds
/// `Limp`, writes nothing new, and leaves a standing robot standing. Only an explicit
/// `robot.enable` moves it on, which is a human pressing Start.
#[derive(Debug, Clone, Copy, PartialEq)]
enum Bringup {
    /// No torque asked for yet. The loop still reads, publishes and holds — it just cannot make the
    /// robot do anything, which is the correct state for a robot nobody has asked to move.
    Limp,
    /// Torque is on and the joints are ramping to the home pose. The policy does not drive yet: it
    /// would be stepping from wherever the robot was slumped, which is exactly the lurch the ramp
    /// exists to avoid.
    Homing {
        from: [f64; NUM_JOINTS],
        since: Instant,
    },
    /// At the home pose with torque on. The policy drives when enabled.
    Ready,
}

impl Bringup {
    /// The interpolated target for this tick, or `None` once the ramp is done.
    ///
    /// Linear, like `DynamixelIo::interpolate_to` which `robotd init` uses — same shape, except this
    /// one is computed per tick instead of blocking the thread, because here the loop is running.
    fn homing_target(&self, now: Instant) -> Option<[f64; NUM_JOINTS]> {
        let Bringup::Homing { from, since } = self else {
            return None;
        };
        let t = now.duration_since(*since).as_secs_f64() / HOME_RAMP.as_secs_f64();
        if t >= 1.0 {
            return None;
        }
        let mut target = [0.0; NUM_JOINTS];
        for (i, slot) in target.iter_mut().enumerate() {
            *slot = from[i] + (DEFAULT_POSITION[i] - from[i]) * t;
        }
        Some(target)
    }
}

async fn adopt_startup_pose<T: RobotIo>(
    safety: &mut Safety<T>,
    state: &RobotState,
    period: Duration,
) -> Option<[f64; NUM_JOINTS]> {
    let mut attempt = 0u32;

    while !state.shutdown.load(Ordering::Relaxed) {
        match safety.read() {
            Ok(sensors) => {
                state.startup_bus_failures.store(0, Ordering::Relaxed);
                if attempt > 0 {
                    // Only worth a line if it had to wait — otherwise "control loop running"
                    // below already says everything, and this would just double it.
                    tracing::warn!(
                        attempt,
                        hz = 1.0 / period.as_secs_f64(),
                        "the motor bus answered; holding the pose found at startup"
                    );
                }
                return Some(sensors.positions);
            }
            Err(e) => {
                attempt += 1;
                // Published before sleeping, so `robot.health` can name the cause on the
                // very first failure rather than after the first log line.
                state.startup_bus_failures.store(attempt, Ordering::Relaxed);
                if attempt == 1 || attempt.is_multiple_of(STARTUP_READ_LOG_EVERY) {
                    tracing::warn!(
                        error = %e,
                        attempt,
                        "no answer from the motor bus; waiting, not commanding anything"
                    );
                }
                tokio::time::sleep(STARTUP_RETRY_INTERVAL).await;
            }
        }
    }

    None
}

/// The tick.
///
/// ```text
/// read → observe (fall) → gate (deadman) → policy → safety.apply
/// ```
///
/// Safety holds the only `RobotIo`, so everything above it can propose targets and nothing
/// above it can command a motor.
///
/// A policy that failed to load is survivable, and deliberately so: the loop keeps running
/// at rate, holds its pose, and `robot.health` says why. The updater then rolls the release
/// back. The alternative — refusing to start — becomes a crashloop under
/// `Restart=always` and reaches the health gate as `Unreachable`, which blames the wrong
/// thing in the journal.
/// Load one mode's policy bundle, or `None` when there is nothing to load.
///
/// A function rather than a block inline in the loop's preamble, because it runs twice: once at
/// startup, and again on every `robot.setMode` — which is a mode's whole difference, since the
/// networks and the tuning are all a mode *is* by the time params are resolved.
///
/// A policy that was *not wanted* is healthy; one that was wanted and could not be loaded is not.
/// Collapsing those two would either make a bench robot look broken or let a release with an
/// unusable bundle pass the health gate.
fn build_controller(
    policy_cfg: &params::ResolvedPolicy,
    limp_fall: bool,
    state: &RobotState,
) -> Option<Controller> {
    if !policy_cfg.enabled {
        tracing::warn!("policy disabled; holding the startup pose");
        return None;
    }
    {
        let tuning = Tuning {
            action_scale: policy_cfg.action_scale,
            standing_action_scale: policy_cfg.standing_action_scale,
            standing_gain_ratio: policy_cfg.standing_gain_ratio,
            gain: policy_cfg.gain,
            head_lowpass: policy_cfg.head_lowpass,
            head_deadband: policy_cfg.head_deadband,
            legs_lowpass: policy_cfg.legs_lowpass,
            walk_settle_s: policy_cfg.walk_settle_s,
            walk_stands: policy_cfg.walk_stands,
        };
        let skills = SkillTuning {
            ground_pick_period: policy_cfg.ground_pick_period,
            ground_pick_action_scale: policy_cfg.ground_pick_action_scale,
            ground_pick_gain_ratio: policy_cfg.ground_pick_gain_ratio,
            kick_duration: policy_cfg.kick_duration,
            roulade_duration: policy_cfg.roulade_duration,
            roulade_action_scale: policy_cfg.roulade_action_scale,
            roulade_gain_ratio: policy_cfg.roulade_gain_ratio,
        };
        let paths = PolicyPaths {
            walk: policy_cfg.walk.clone(),
            stand: policy_cfg.stand.clone(),
            sitstand: policy_cfg.sitstand.clone(),
            ground_pick: policy_cfg.ground_pick.clone(),
            kick_left: policy_cfg.kick_left.clone(),
            kick_right: policy_cfg.kick_right.clone(),
            roulade: policy_cfg.roulade.clone(),
            lie: policy_cfg.lie.clone(),
        };
        match Policy::load(&paths, DEFAULT_STANDING_THRESHOLD) {
            Ok(mut policy) => {
                // Roller mode has no standing network — command magnitude stops selecting
                // it. Nothing else reserves it: limp-fall hands back by *letting* the
                // standing network be selected, which is what stands the robot up.
                if policy_cfg.mode == Mode::Roller {
                    policy.set_standing_disabled(true);
                }
                tracing::warn!(
                    mode = policy_cfg.mode.as_str(),
                    walk = %policy_cfg.walk.display(),
                    stand = ?policy_cfg.stand.as_ref().map(|p| p.display().to_string()),
                    sitstand = ?policy_cfg.sitstand.as_ref().map(|p| p.display().to_string()),
                    ground_pick = ?policy_cfg.ground_pick.as_ref().map(|p| p.display().to_string()),
                    kicks = policy_cfg.kick_left.is_some() || policy_cfg.kick_right.is_some(),
                    roulade = ?policy_cfg.roulade.as_ref().map(|p| p.display().to_string()),
                    lie = ?policy_cfg.lie.as_ref().map(|p| p.display().to_string()),
                    limp_fall,
                    "policy loaded"
                );
                Some(Controller::new(policy, tuning, skills))
            }
            Err(e) => {
                tracing::error!(error = %e, "policy unavailable; holding the pose");
                state.policy_error.store(Some(Arc::new(e.to_string())));
                None
            }
        }
    }
}

async fn control_loop<T: RobotIo>(
    io: T,
    state: Arc<RobotState>,
    intents: Arc<Intents>,
    params: Params,
    period: Duration,
    poweroff: PowerOff,
) {
    // `mut` because a mode switch replaces it: the resolved policy *is* the mode, once the
    // per-mode defaults have been applied.
    let mut policy_cfg = params.policy.resolved();
    let mut safety = Safety::new(
        io,
        SafetyConfig {
            fall_gravity_z: params.safety.fall_gravity_z,
            fall_debounce: Duration::from_millis(params.safety.fall_debounce_ms),
            deadman: Duration::from_millis(params.safety.deadman_ms),
            gain_running: policy_cfg.gain,
            gain_limp: params.safety.gain_limp,
        },
    );

    let Some(mut hold) = adopt_startup_pose(&mut safety, &state, period).await else {
        return;
    };

    // Was the robot powered on already sitting? A seated duck has hips and knees folded
    // far from the standing pose. If so, the first bring-up rises via the sitstand network
    // instead of dragging the legs through the linear ramp — the ramp is for a robot that
    // is roughly standing.
    const LEG_JOINTS: [usize; 10] = [0, 1, 2, 3, 4, 10, 11, 12, 13, 14];
    let leg_deviation = LEG_JOINTS
        .iter()
        .map(|&j| (hold[j] - DEFAULT_POSITION[j]).abs())
        .sum::<f64>()
        / LEG_JOINTS.len() as f64;
    let sit_distance = duck_control::leg_distance(&hold, &duck_control::SIT_POSITION);
    let mut seated_boot = sit_distance < SEATED_BOOT_RAD && sit_distance < leg_deviation;
    if seated_boot {
        tracing::warn!(
            deviation = format!("{leg_deviation:.2}"),
            from_sit = format!("{sit_distance:.2}"),
            "seated boot detected — will stand up via the sitstand policy"
        );
    }

    // Loaded once here and again on a mode switch — see `build_controller`.
    let mut controller = build_controller(&policy_cfg, params.safety.limp_fall, &state);

    tracing::warn!(
        joints = NUM_JOINTS,
        hz = 1.0 / period.as_secs_f64(),
        driving = controller.is_some(),
        "control loop running"
    );

    let mut ticker = tokio::time::interval(period);
    // `Skip`, not `Burst` and not `Delay`.
    //
    // `Burst` replays a backlog back to back, stacking motor commands — clearly wrong. But
    // `Delay` is wrong too, and less obviously: it schedules the next tick at *now + period*
    // after each one, so every tick's wakeup latency is added to the period rather than
    // absorbed. A few milliseconds of scheduler jitter becomes a permanent rate loss.
    //
    // Measured, not reasoned about: with `Delay` this loop reported 43.1 Hz against a 50 Hz
    // target and `missed = 0` — not overrunning its work, just being rescheduled late every
    // time. With a real bus read costing 3–8 ms it would have been nearer 35 Hz, and it
    // would have looked like a hardware problem.
    //
    // `Skip` keeps the original schedule and drops missed ticks, which is what a control
    // loop wants: no backlog, no drift.
    ticker.set_missed_tick_behavior(tokio::time::MissedTickBehavior::Skip);

    let mut window_start = Instant::now();
    let mut window_ticks = 0u64;
    let mut last_summary = Instant::now();
    // Worst read / step / write of the summary interval, milliseconds. The command-to-motion
    // delay the policies train against is mostly these plus the servo's own response.
    let mut worst_ms = [0.0f64; 3];
    let mut was_driving = false;
    let mut bringup = Bringup::Limp;
    // A mode switch in flight: the mode to end up in, once the robot is home. `None` the rest of
    // the time, which is nearly always.
    let mut mode_change: Option<Mode> = None;
    // The policy params this loop is running, which a mode switch replaces. Owned rather than
    // borrowed from `params` because the mode is no longer what the file said.
    let mut policy_params = params.policy.clone();

    // Command smoothing, per the prototype: `cmd += α × (target − cmd)` at the tick rate.
    // A stick snap becomes a ramp the gait can follow; the state lives here because it is
    // per-tick, which the intent slots must not be.
    let dt = period.as_secs_f64();
    let cmd_alpha = params.control.cmd_alpha.clamp(0.0, 1.0);
    let head_alpha = params.control.head_alpha.clamp(0.0, 1.0);
    let mut twist_ema = [0.0f64; 3];
    // The servo temperature guard (`[thermal]`), fed once a second with the slow sensors; the
    // last per-servo sample rides every `robot.state` frame until the next.
    let mut thermal = duck_control::thermal::ThermalGuard::new(
        params.thermal.warn_c,
        params.thermal.walk_max_c,
        params.thermal.sit_c,
        params.thermal.hysteresis_c,
    );
    let mut thermal_sit = false;
    // Resting to cool down (`[thermal] rest_c`, `robot.rest`): `duck_control::rest` decides,
    // the loop carries it out. `legs_limp` mirrors what was last asked of the bus; `leg_blend`
    // is the start pose and elapsed time of the blend after the legs get torque back.
    let mut rest = duck_control::rest::Rest::new(duck_control::rest::RestConfig {
        resume_c: params.thermal.resume_c,
        min_rest_s: params.thermal.rest_min_s,
        settle_s: 2.0,
        ..Default::default()
    });
    let mut legs_limp = false;
    // What the rest asked of the bus, and whether the mouth sleeps on top of it: a mouth that only
    // wakes to speak (`[bus] mouth_wake`) is limp whenever it has nothing to say.
    let mouth_wakes = !params.bus.mouth_torque && params.bus.mouth_wake;
    let mut rest_mask = [false; NUM_JOINTS];
    let mut mouth_asleep = false;
    let mut last_speech: Option<Instant> = None;
    let with_mouth = |mut mask: [bool; NUM_JOINTS], asleep: bool| {
        mask[duck_control::model::MOUTH_INDEX] |= asleep;
        mask
    };
    // A deep rest lies down and lets the head go with the legs (`robot.rest {deep}`, or hot with
    // the head at `[thermal] rest_head_c`); a light one sits and keeps the head.
    let mut rest_deep = false;
    // How a deep rest gets down: lying (the lie policy), or seated (`[thermal] deep_sit`).
    let deep_lies = !params.thermal.deep_sit;
    let mut leg_blend: Option<([f64; NUM_JOINTS], f64)> = None;
    let mut servo_temps: Vec<f64> = Vec::new();
    // Holds the heading a straight walk started on (`[control] heading_hold_gain`, off at 0).
    let mut heading = duck_control::heading::HeadingHold::new(
        params.control.heading_hold_gain,
        params.control.heading_hold_max,
        params.control.heading_hold_tau_s,
        params.control.heading_hold_deadband_deg.to_radians(),
        dt,
    );
    let mut head_ema = [0.0f64; 4];
    let mut body_ema = [0.0f64; 3];

    // Coasting over a dropped bus read, and where the robot actually is.
    //
    // `known_positions` is updated from every sample that arrives and is what a fallback
    // holds. It used to be `hold`, which is only assigned when driving *stops* — and the
    // assignment needed a sample, which is the one thing a failed read does not have. So a
    // drop mid-stride held whatever `hold` was last set to, which after bring-up is the home
    // pose: one tick of "snap to standing" at full gain, mid-motion.
    let mut coast = Coast::new();
    let mut stopped_driving_at: Option<Instant> = None;

    // Contact odometry, ticked at the loop's own rate on the sample the loop already
    // read — the prototype ran it at 100 Hz on extra bus reads, which is exactly the
    // bus pressure the spasms investigation taught this loop not to add.
    let mut odometry = odometry::Odometry::alpha();

    // The sit-then-power-off sequence.
    let mut shutdown_sit: Option<Instant> = None;
    let mut powered_off = false;
    let mut warned_imu_warming = false;

    // Limp-fall (`[safety] limp_fall`): the predictor that sees a fall start, and where the
    // sequence it drives has got to. Built whether or not the mode is on — it costs a
    // multiply-subtract per tick, and having the numbers computed on every robot is what
    // makes the thresholds tunable against a recording from a robot that was not running
    // the mode.
    let mut falling = FallPredictor::new(FallPredictorConfig {
        tilt_z: params.safety.limp_fall_tilt_z,
        predicted_z: params.safety.limp_fall_predict_z,
        lookahead: Duration::from_millis(params.safety.limp_fall_lookahead_ms),
        debounce: Duration::from_millis(params.safety.limp_fall_debounce_ms),
    });
    let limp_fall_still = Duration::from_millis(params.safety.limp_fall_still_ms);
    let limp_fall_max = Duration::from_millis(params.safety.limp_fall_max_ms);
    let limp_fall_pose = Duration::from_millis(params.safety.limp_fall_pose_ms);
    let mut limp_fall = LimpFall::Idle;
    // After a hand-back: how long the robot has been upright since. While it is `Some` the
    // twist stays at zero, so the standing network — the stand-up — keeps the robot until
    // it is up, whatever a client is still asking for.
    let mut getting_up: Option<Duration> = None;

    // The voice, and the ear. Both optional equipment: a robot without a codec or a bank
    // walks identically — the player degrades to a debug line, and the mic worker is only
    // spawned when configured, with its own retry loop when arecord flaps.
    let mut voice = params
        .audio
        .enabled
        .then(|| sound::Sound::new(params.audio.bank.clone(), params.audio.device.clone()));
    let pet: Option<pet_detect::worker::PetHandle> = if params.audio.enabled
        && params.audio.pet_detect_resolved(params.policy.mode)
        && let Some(model) = params.audio.pet_model_resolved()
        && model.exists()
    {
        match pet_detect::worker::PetHandle::spawn(pet_detect::worker::PetConfig {
            alsa_device: params.audio.capture_device(),
            model_path: model.clone(),
            enter_threshold: params.audio.pet_enter_threshold,
            exit_threshold: params.audio.pet_exit_threshold,
            denoise: params.audio.denoise,
        }) {
            Ok(handle) => {
                tracing::warn!(model = %model.display(), "petting detection listening");
                Some(handle)
            }
            Err(e) => {
                // Not unhealthy: the classifier is a feature, not the robot. A missing
                // model on a release that ships one is caught by the packaging tripwires.
                tracing::warn!(error = %e, "petting detection unavailable");
                None
            }
        }
    } else {
        // Configured on but nothing to run: a bench robotd, a board that predates the
        // model, or audio off. Quietly so on purpose — the mic is optional equipment.
        None
    };

    // The theremin. Its depth reader starts now and parks on `tofd`'s socket whether or not
    // anyone ever asks for an instrument: one blocked read costs nothing, and connecting
    // lazily would make the first arming window wait for a connection as well as for
    // frames — a second of silence that reads as a broken feature. Off entirely when the
    // params say so, or when audio is off, since a theremin with no voice is a mouth
    // opening for no reason.
    let mut theremin = (params.theremin.enabled && params.audio.enabled)
        .then(|| theremin::Theremin::spawn(params.theremin.socket.clone(), params.theremin.hand()));
    // How far the beak is open for the chorale, slewed across ticks — see where it is written.
    let mut chorale_mouth = 0.0f64;
    // And how the head sways while singing, applied to the next tick's command.
    let mut chorale_head = [0.0f64; 4];

    // The note the theremin is holding, kept across ticks so a hand leaving the frame fades
    // the note at its own pitch instead of gliding to the bottom of the range on its way out.
    let mut theremin_hz = 0.0f64;

    // The chorale. Off unless the config opted in — see `[chorale] accept`, and note that off
    // means putting nothing on the air rather than declining politely.
    let mut chorale = (params.chorale.accept && params.audio.enabled)
        .then(|| {
            let personality = voice.as_mut().and_then(|v| v.personality())?;
            // `DUCK_CHORALE_PIECE=<id>` pins the conductor's pick — a bench lever for testing
            // one piece, read once like everything else about this process's configuration.
            let forced_piece = std::env::var("DUCK_CHORALE_PIECE")
                .ok()
                .and_then(|v| v.parse::<u8>().ok());
            Some(chorale::Chorale::new(
                personality.pitch_center_hz,
                personality.seed,
                forced_piece,
            ))
        })
        .flatten();
    if chorale.is_some() {
        tracing::warn!("chorale: this robot will sing with others");
    }

    // Say hello in this robot's own voice as the control loop comes up, as the prototype
    // does — the greet is also the audible "robotd is running" on a headless board. Its
    // own switch, because the reason to want it gone (restarting the daemon all day) is
    // not a reason to give up the triggers and the mic that `audio.enabled = false` takes
    // with it.
    if let Some(voice) = voice.as_mut()
        && params.audio.greet
    {
        voice.play("greet", false);
    }

    while !state.shutdown.load(Ordering::Relaxed) {
        ticker.tick().await;
        let tick_start = Instant::now();

        let fresh = match safety.read() {
            Ok(sensors) => {
                state.consecutive_errors.store(0, Ordering::Relaxed);
                Some(sensors)
            }
            Err(e) => {
                let n = state.consecutive_errors.fetch_add(1, Ordering::Relaxed) + 1;
                // One dropped transaction is ordinary on a serial bus; a run of them is not.
                // Log the first and then every tenth, so a persistent fault is visible
                // without a wall of identical lines.
                if n == 1 || n.is_multiple_of(10) {
                    tracing::warn!(error = %e, consecutive = n, "bus read failed");
                }
                None
            }
        };
        let read_ms = tick_start.elapsed().as_secs_f64() * 1e3;

        // Coast over a dropped read on the last good sample — see [`COAST_TICKS`]. The
        // distinction between "fresh" and "what the policy steps from" matters twice below:
        // safety only observes fresh samples, so a repeat cannot feed the fall debounce, and
        // `known_positions` only advances on fresh ones, so a coasted tick cannot pretend to
        // know where the joints have moved to.
        let sensors = coast.sample(fresh);

        if let Some(fresh) = fresh.as_ref() {
            safety.observe(fresh, period);
            // Only once the orientation filter has converged: seeding the anchor from a
            // quaternion that is still swinging would put the world origin somewhere the
            // robot never was. A coasted tick is skipped too — repeating a stale sample
            // into the estimator would tell it the robot froze, which it did not.
            if safety.imu_ready() {
                odometry.update(&fresh.positions, fresh.imu.quat);
            }
        }
        state.fallen.store(safety.fallen(), Ordering::Relaxed);

        let snapshot = intents.snapshot();
        let (gated, deadman) = safety.gate(snapshot.command, snapshot.twist_age);
        let mut limits: Vec<duck_control::safety::Limit> = deadman.into_iter().collect();

        // An explicit `robot.init` / `robot.relax`, taken once.
        //
        // Before the enable-driven bring-up below, so a `relax` that arrives in the same tick as a
        // still-set `enabled` flag wins — `request_relax` clears that flag, and reading the request
        // first means the order cannot invert.
        match intents.take_power_request() {
            Some(intents::PowerRequest::Init) => match (bringup, sensors.as_ref()) {
                // Unlike `enable`, this needs no policy: "stand up" is a reasonable thing to ask of
                // a robot with no walking network at all, and it is what a bench robot needs before
                // anything else can be tested.
                (Bringup::Limp, Some(_)) if state.battery_refusal().is_some() => {
                    let why = state.battery_refusal().unwrap_or_default();
                    tracing::warn!(reason = %why, "robot.init refused: the robot stays limp");
                }
                (Bringup::Limp, Some(sensors)) if ramp_refusal(&sensors.positions).is_some() => {
                    let why = ramp_refusal(&sensors.positions).unwrap_or_default();
                    tracing::warn!(reason = %why, "robot.init refused: the robot stays limp");
                }
                (Bringup::Limp, Some(sensors)) => match safety.set_torque(true) {
                    Ok(()) => {
                        if seated_boot && controller.as_ref().is_some_and(|c| c.has_sitstand()) {
                            seated_boot = false;
                            tracing::warn!(
                                "robot.init: seated boot — rising via the sitstand policy"
                            );
                            controller
                                .as_mut()
                                .expect("checked above")
                                .begin_boot_rise();
                            bringup = Bringup::Ready;
                        } else {
                            tracing::warn!(?HOME_RAMP, "robot.init: torque on, ramping to home");
                            bringup = Bringup::Homing {
                                from: sensors.positions,
                                since: tick_start,
                            };
                        }
                    }
                    Err(e) => tracing::warn!(error = %e, "cannot enable torque"),
                },
                // Already up: ramp back to home from wherever the joints are, as the
                // prototype's init_position always does — Start on a robot stopped
                // mid-crouch must not hand the policy that crouch as its starting pose.
                // The policy holds off while Homing runs and resumes at Ready.
                (Bringup::Ready, Some(sensors)) => {
                    tracing::warn!(?HOME_RAMP, "robot.init: re-homing from the current pose");
                    bringup = Bringup::Homing {
                        from: sensors.positions,
                        since: tick_start,
                    };
                }
                // Mid-ramp, or no sample to ramp from: nothing to do, and saying so beats
                // a silent no-op.
                (state, _) => tracing::info!(?state, "robot.init: nothing to bring up"),
            },
            Some(intents::PowerRequest::Relax) => match safety.set_torque(false) {
                Ok(()) => {
                    tracing::warn!("robot.relax: torque off");
                    // Back to the start, so the next `init` or Start ramps from wherever the robot
                    // ends up rather than assuming it is still at the home pose.
                    bringup = Bringup::Limp;
                    was_driving = false;
                }
                Err(e) => {
                    tracing::warn!(error = %e, "cannot cut torque; the robot is still powered")
                }
            },
            None => {}
        }

        // One-shot skill requests, taken once per tick like the power request. They need a
        // driving robot — the prototype's buttons likewise did nothing until the policy ran.
        let requests = intents.take_skills();
        if requests.any() {
            match controller.as_mut() {
                Some(controller)
                    if snapshot.enabled && bringup == Bringup::Ready && shutdown_sit.is_none() =>
                {
                    let outcome = |what: &str, result: Result<(), &'static str>| match result {
                        Ok(()) => tracing::warn!(skill = what, "skill started"),
                        Err(reason) => tracing::warn!(skill = what, reason, "skill refused"),
                    };
                    if requests.ground_pick {
                        outcome("ground_pick", controller.start_ground_pick());
                    }
                    if requests.kick_left {
                        outcome("kick_left", controller.start_kick(true));
                    }
                    if requests.kick_right {
                        outcome("kick_right", controller.start_kick(false));
                    }
                    if requests.sit_toggle {
                        match controller.sit_toggle() {
                            Ok(direction) => tracing::warn!(direction, "sit toggle"),
                            Err(reason) => tracing::warn!(reason, "sit toggle refused"),
                        }
                    }
                    if requests.lie_toggle {
                        match controller.lie_toggle() {
                            Ok(direction) => tracing::warn!(direction, "lie toggle"),
                            Err(reason) => tracing::warn!(reason, "lie toggle refused"),
                        }
                    }
                    if requests.roulade {
                        // A held button lands here every tick; only the start of a roll is
                        // journal-worthy. `Ok(false)` is a chain refresh, and stays quiet.
                        match controller.request_roulade() {
                            Ok(true) => tracing::warn!(skill = "roulade", "skill started"),
                            Ok(false) => {}
                            Err(reason) => {
                                tracing::debug!(skill = "roulade", reason, "skill refused");
                            }
                        }
                    }
                }
                _ => tracing::info!("skill request ignored: the policy is not driving"),
            }
        }

        // A servo hot enough to sit for (`[thermal] sit_c`): sit once the robot is standing
        // still under the policy, rather than mid-stride — the sitstand policy starts from a
        // stand. A request the servos have since cooled out of is dropped.
        if thermal_sit && !thermal.sit_hot() {
            thermal_sit = false;
        }
        if thermal_sit {
            match controller.as_mut() {
                Some(c) if !c.has_sitstand() => {
                    tracing::warn!("servo hot, but no sitstand policy is loaded to sit with");
                    thermal_sit = false;
                }
                Some(c)
                    if snapshot.enabled
                        && bringup == Bringup::Ready
                        && shutdown_sit.is_none()
                        && limp_fall == LimpFall::Idle
                        && getting_up.is_none()
                        && !safety.fallen()
                        && !c.busy()
                        && twist_ema.iter().all(|v| v.abs() < 0.02) =>
                {
                    if !c.is_sitting() {
                        match c.sit_toggle() {
                            Ok(_) => tracing::warn!("servo hot: sitting down to cool"),
                            Err(reason) => tracing::warn!(reason, "servo hot: sit refused"),
                        }
                    }
                    thermal_sit = false;
                }
                _ => {}
            }
        }

        // Rest to cool down: asked for over IPC, or a servo at `[thermal] rest_c` while the
        // robot stands still. Taken away by anything else claiming the robot — a fall, relax,
        // shutdown, the policy turned off — and then the legs get their torque back at once.
        // The pad's one key (`Skill::RestToggle`): not resting, rest deep where the robot can —
        // seated (`[thermal] deep_sit`) or lying (a lie policy) — so it sits and lets every joint
        // go; resting light, go deep; resting deep (or unable to), wake.
        let toggled =
            (requests.rest_toggle && snapshot.enabled && bringup == Bringup::Ready).then(|| {
                let deep_ok = !deep_lies || controller.as_ref().is_some_and(|c| c.has_lie());
                if rest.active() && (rest_deep || !deep_ok) {
                    (false, false)
                } else {
                    (true, deep_ok)
                }
            });
        if let Some((on, deep)) = intents.take_rest_request().or(toggled) {
            if on {
                if !rest.active() {
                    rest_deep = deep;
                } else if deep && !rest_deep && !deep_lies {
                    // Deep asked for during a light rest (lifed's, say): seated already, so the
                    // head lets go too — now, if the legs already have.
                    rest_deep = true;
                    if legs_limp {
                        for m in &mut rest_mask[5..9] {
                            *m = true;
                        }
                        match safety.set_limp(with_mouth(rest_mask, mouth_asleep)) {
                            Ok(()) => tracing::warn!("resting: deep now, the head limp too"),
                            Err(e) => {
                                tracing::warn!(error = %e, "resting: could not let the head go")
                            }
                        }
                    }
                }
                rest.request(duck_control::rest::RestReason::Asked);
            } else {
                rest.wake();
            }
        }
        let rest_max_c = state.motor_thermal().map(|m| m.max_c);
        if params.thermal.rest_c > 0.0
            && !rest.active()
            && rest_max_c.is_some_and(|c| c >= params.thermal.rest_c)
        {
            // The head too, if it is hot and the robot can lie down to rest it.
            let head_max_c = servo_temps.get(5..9).and_then(|t| {
                t.iter()
                    .copied()
                    .fold(None, |m: Option<f64>, v| Some(m.map_or(v, |m| m.max(v))))
            });
            rest_deep = params.thermal.rest_head_c > 0.0
                && head_max_c.is_some_and(|c| c >= params.thermal.rest_head_c)
                && controller.as_ref().is_some_and(|c| {
                    if deep_lies {
                        c.has_lie()
                    } else {
                        c.has_sitstand()
                    }
                });
            tracing::warn!(
                max_c = ?rest_max_c,
                ?head_max_c,
                deep = rest_deep,
                "servo hot: resting to cool down"
            );
            rest.request(duck_control::rest::RestReason::Hot);
        }
        if rest.active() || legs_limp {
            let upright_driving = snapshot.enabled
                && bringup == Bringup::Ready
                && shutdown_sit.is_none()
                && limp_fall == LimpFall::Idle
                && getting_up.is_none()
                && !safety.fallen();
            let can_rest = controller.as_ref().is_some_and(|c| {
                if rest_deep && deep_lies {
                    c.has_lie()
                } else {
                    c.has_sitstand()
                }
            });
            if !rest.active() || !upright_driving || !can_rest {
                if rest.active() {
                    tracing::warn!(
                        upright_driving,
                        can_rest,
                        deep = rest_deep,
                        "rest abandoned"
                    );
                }
                if legs_limp {
                    if let Err(e) = {
                        rest_mask = [false; NUM_JOINTS];
                        safety.set_limp(with_mouth(rest_mask, mouth_asleep))
                    } {
                        tracing::warn!(error = %e, "could not give the joints their torque back");
                    }
                    legs_limp = false;
                }
                rest.abort();
            } else if let (Some(c), Some(s)) = (controller.as_mut(), sensors.as_ref()) {
                use duck_control::rest::{RestAction, RestInputs};
                // Down: the sitstand network holds the sit (the lie network the lie) and the
                // legs are near that pose; still: calm, the trunk where that pose has it.
                let calm = s.imu.gyro.iter().map(|v| v * v).sum::<f64>().sqrt() < 0.15;
                let (seated, still) = if rest_deep && deep_lies {
                    let g_err = s
                        .imu
                        .gravity
                        .iter()
                        .zip(duck_control::LIE_GRAVITY)
                        .map(|(a, b)| (a - b) * (a - b))
                        .sum::<f64>()
                        .sqrt();
                    (
                        c.is_lying()
                            && duck_control::leg_distance(
                                &s.positions,
                                &duck_control::LIE_POSITION,
                            ) < LIE_LEGS_RAD,
                        calm && g_err < LIE_GRAVITY_TOL,
                    )
                } else {
                    (
                        c.is_sitting()
                            && duck_control::leg_distance(
                                &s.positions,
                                &duck_control::SIT_POSITION,
                            ) < SEATED_BOOT_RAD,
                        calm && s.imu.gravity[2] < -0.9,
                    )
                };
                let input = RestInputs {
                    dt,
                    can_sit: !c.busy()
                        && !c.is_sitting()
                        && !c.is_lying()
                        && twist_ema.iter().all(|v| v.abs() < 0.02),
                    seated,
                    still,
                    max_c: rest_max_c,
                };
                match rest.tick(input) {
                    Some(RestAction::Sit) => {
                        let down = if rest_deep && deep_lies {
                            c.lie_toggle()
                        } else {
                            c.sit_toggle()
                        };
                        match down {
                            Ok(_) => tracing::warn!(deep = rest_deep, "resting: getting down"),
                            Err(reason) => {
                                tracing::warn!(reason, "resting: getting down refused");
                                rest.abort();
                            }
                        }
                    }
                    Some(RestAction::LegsLimp(true)) => {
                        // Lying, the head lets go too: it rests on the jaw.
                        let mut mask = [false; NUM_JOINTS];
                        for j in duck_control::LEG_JOINTS {
                            mask[j] = true;
                        }
                        if rest_deep {
                            for m in &mut mask[5..9] {
                                *m = true;
                            }
                        }
                        rest_mask = mask;
                        match safety.set_limp(with_mouth(mask, mouth_asleep)) {
                            Ok(()) => {
                                legs_limp = true;
                                tracing::warn!(deep = rest_deep, "resting: limp");
                            }
                            Err(e) => {
                                tracing::warn!(error = %e, "resting: cannot let the legs go");
                                let _ = {
                                    rest_mask = [false; NUM_JOINTS];
                                    safety.set_limp(with_mouth(rest_mask, mouth_asleep))
                                };
                                rest.abort();
                            }
                        }
                    }
                    Some(RestAction::LegsLimp(false)) => {
                        if let Err(e) = {
                            rest_mask = [false; NUM_JOINTS];
                            safety.set_limp(with_mouth(rest_mask, mouth_asleep))
                        } {
                            tracing::warn!(error = %e, "resting: could not power the legs");
                        }
                        legs_limp = false;
                        leg_blend = Some((s.positions, 0.0));
                        tracing::warn!(max_c = ?rest_max_c, "resting: cool, powered again");
                    }
                    Some(RestAction::Stand { settled }) => {
                        // Up on the sitstand network once the sit is restored; a sit that would
                        // not come back (a deep rest let every joint go) gets up on the stand-up
                        // network instead, which rises from anywhere (`rise_on_standing`).
                        let up = if rest_deep && deep_lies {
                            c.lie_toggle()
                        } else if settled {
                            c.sit_toggle()
                        } else {
                            tracing::warn!(
                                "rested: the sit did not come back; up on the stand-up network"
                            );
                            c.rise_on_standing()
                        };
                        match up {
                            Ok(_) => tracing::warn!("rested: standing up"),
                            Err(reason) => tracing::warn!(reason, "rested: stand refused"),
                        }
                    }
                    None => {}
                }
            }
        }

        // Sounds: the wheee hold as a level, then the one-shot tags queued by clients. In
        // that order, because the ride owns the PCM while it lasts — the one-shots have to
        // see the ride this tick started (they wait) or the release this tick did (they
        // play). The hold is held only while `padd`'s re-notifications stay fresh; a client
        // that dies mid-ride leaves a ride that lands rather than one that loops forever.
        if let Some(voice) = voice.as_mut() {
            let hold = if powered_off {
                intents::WheeeHold::Released
            } else {
                intents.wheee_hold()
            };
            voice.theremin_settle();
            voice.wheee(hold);
            for tag in intents.take_sounds() {
                voice.play(tag.as_str(), false);
            }
            match intents.take_speech() {
                Some(intents::Speech::Say(path)) => voice.play_file(&path),
                Some(intents::Speech::Hush) => voice.hush(),
                None => {}
            }

            // Petting: coo, exactly when the prototype coos — not fallen, no scripted move
            // in flight. The verdict is used bare here (not the armed fall gate): this is a
            // sound cue, and cooing while face-down would be worse than staying quiet.
            if let Some(pet) = pet.as_ref() {
                while let Some(ev) = pet.try_recv_event() {
                    match ev {
                        pet_detect::PettingEvent::Start => {
                            let calm =
                                !safety.fallen() && controller.as_ref().is_none_or(|c| !c.busy());
                            if calm {
                                tracing::info!("petting started");
                                voice.play("coo", false);
                            } else {
                                tracing::debug!("petting detected (ignored: busy or down)");
                            }
                        }
                        pet_detect::PettingEvent::End => tracing::debug!("petting ended"),
                    }
                }
                // Ambient sound events have no consumer until the autonomous brain arrives;
                // surfaced at debug so mic tuning on a bench has data to look at.
                while let Some(ev) = pet.try_recv_sound() {
                    tracing::debug!(event = ?ev, "ambient sound");
                }
            }
        }

        // A drive-mode switch: `robot.setMode`, which the pad's held D-pad up sends.
        //
        // The robot goes back to its home pose first and the policies load there, for the reason
        // the prototype relaunched into pose 0: swapping the network under a moving gait means the
        // next tick is a different policy's idea of what the legs were doing. Torque stays on
        // throughout — the robot holds itself up across the swap rather than sitting down.
        if let Some(code) = intents.take_mode_switch() {
            let target = mode_of(code);
            if target == policy_params.mode {
                tracing::info!(
                    mode = target.as_str(),
                    "already in that mode; nothing to switch"
                );
            } else if mode_change.is_some() {
                tracing::warn!(mode = target.as_str(), "a mode switch is already in flight");
            } else {
                tracing::warn!(
                    from = policy_params.mode.as_str(),
                    to = target.as_str(),
                    "mode switch: going home before loading the other policies"
                );
                // The prototype's cue, and worth keeping: one quack for walking, two for roller,
                // so the robot says which mode it is going to without anybody reading a log.
                if let Some(voice) = voice.as_mut() {
                    voice.play("chirp", false);
                    if target == Mode::Roller {
                        voice.play("chirp", false);
                    }
                }
                mode_change = Some(target);
                // Home the robot with the machinery `init` and a fall recovery already use: it
                // ramps per tick, and `driving` is false until it reaches Ready.
                if let Some(sensors) = sensors.as_ref() {
                    bringup = Bringup::Homing {
                        from: sensors.positions,
                        since: tick_start,
                    };
                }
            }
        }

        // The sit-then-power-off sequence: `robot.shutdown`, or a genuinely empty pack.
        // The battery reading is a ~10 s EMA refreshed once a second, so a load sag cannot
        // reach the floor — a pack that gets there is spent.
        let battery_v = f64::from_bits(state.battery_v.load(Ordering::Relaxed));
        let battery_empty = params.safety.battery_empty_shutdown
            && battery_v > 0.0
            && state.pack().is_some_and(|pack| battery_v <= pack.empty_v());
        if !powered_off && shutdown_sit.is_none() && (intents.take_shutdown() || battery_empty) {
            let can_sit = snapshot.enabled
                && bringup == Bringup::Ready
                && !safety.fallen()
                && controller.as_ref().is_some_and(|c| c.has_sitstand());
            if can_sit {
                tracing::warn!(battery_empty, "shutdown: sitting down before power off");
                // Goodbye peck; non-blocking — it plays out during the sit.
                if let Some(voice) = voice.as_mut() {
                    voice.play("peck", false);
                }
                controller
                    .as_mut()
                    .expect("can_sit checked the controller")
                    .begin_shutdown_sit();
                shutdown_sit = Some(tick_start);
            } else {
                tracing::warn!(battery_empty, "shutdown: cutting torque and powering off");
                if let Err(e) = safety.set_torque(false) {
                    tracing::warn!(error = %e, "cannot cut torque before power off");
                }
                // Goodbye peck; blocking, so it is heard before the poweroff kills this
                // process's cgroup. The one deliberate block in the loop, on its last tick.
                if let Some(voice) = voice.as_mut() {
                    voice.play("peck", true);
                }
                intents.set_enabled(false);
                powered_off = true;
                poweroff();
            }
        }
        if let Some(started) = shutdown_sit
            && !powered_off
            && tick_start.duration_since(started) >= SHUTDOWN_SIT
        {
            tracing::warn!("sit complete: cutting torque and powering off");
            if let Err(e) = safety.set_torque(false) {
                tracing::warn!(error = %e, "cannot cut torque before power off");
            }
            intents.set_enabled(false);
            bringup = Bringup::Limp;
            powered_off = true;
            poweroff();
        }

        // Limp-fall (`[safety] limp_fall`): catch the fall on the way down.
        //
        // The standing policy is a good stand-up-er and a bad faller. It stands a still
        // robot up cleanly from face-down or face-up; asked to do it out of a dynamic fall
        // it tries, fails, tries again — at walking gain, against the floor — and the
        // motors pay for every attempt. So take the fall away from it: go soft before the
        // landing, let the robot arrive limp, put it back into the standing pose, and only
        // then hand it over. What the policy then sees is the case it is good at.
        //
        // Everything here is off the policy's path by construction: `driving` is false for
        // the whole sequence, so the controller is not stepped and the targets below come
        // from this block. Nothing in `safety` needs telling: the fall verdict gates
        // nothing, so the pose ramp moves a robot lying on the floor like any other tick.
        if params.safety.limp_fall {
            // Abandoned mid-sequence: someone cut the torque, disabled the policy, or the
            // shutdown sit started. Whatever took over owns the robot now — drop out rather
            // than finishing a pose ramp nobody asked for, and hold where the robot is
            // rather than snapping back to a pose it collapsed out of a second ago.
            if limp_fall != LimpFall::Idle
                && !(snapshot.enabled
                    && bringup == Bringup::Ready
                    && shutdown_sit.is_none()
                    && !powered_off)
            {
                tracing::warn!("limp-fall abandoned — something else took the robot");
                limp_fall = LimpFall::Idle;
                falling.reset();
                hold = coast.known_positions(hold);
            }
            match limp_fall {
                LimpFall::Idle => {
                    // Only on a fresh sample: a coasted one is the same reading twice, and
                    // feeding it to a debounce would let one bad tick count three times.
                    let eligible = was_driving
                        // Already down. There is no fall left to catch, and this is what
                        // stops the sequence firing at a robot on the floor working its way
                        // upright: a stand-up rocks, and a rock is a tilt with a rate on it.
                        // Limping through that would be an endless limp-pose-retry loop.
                        && !safety.fallen()
                        // Nor while the stand-up has it, until it has stood for a second:
                        // part-way up the robot is no longer `fallen`, and the tilt and rate
                        // of the rise read as a new fall — on 2026-10-08 that limped two
                        // rises out of three back onto the floor. A stand-up that does fall
                        // starts again from wherever it lands, which is what it trains for.
                        && getting_up.is_none()
                        && shutdown_sit.is_none()
                        && !powered_off
                        // A roulade tips the robot over on purpose, a ground pick pitches it
                        // forward, and a sit is not a fall. Limping through any of them would
                        // break a move that was working. Nor is lying down: the lie pose is
                        // pitched 26°, right at `limp_fall_tilt_z`, and gets there with a rate.
                        && controller
                            .as_ref()
                            .is_some_and(|c| !c.busy() && !c.is_sitting() && !c.is_lying());
                    match fresh.as_ref() {
                        Some(fresh) if eligible && safety.imu_ready() => {
                            if falling.observe(&fresh.imu, period) {
                                tracing::warn!(
                                    gravity_z = format!("{:.2}", fresh.imu.gravity[2]),
                                    rate =
                                        format!("{:.2}", FallPredictor::gravity_z_rate(&fresh.imu)),
                                    gain = params.safety.gain_limp,
                                    "falling — going limp to land soft"
                                );
                                limp_fall = LimpFall::Limp {
                                    since: tick_start,
                                    landing: Landing::default(),
                                };
                            }
                        }
                        // Not eligible, or blind for this tick. Drop any debounce in
                        // progress rather than resuming it later against a robot that has
                        // moved on.
                        _ => falling.reset(),
                    }
                }
                LimpFall::Limp { since, mut landing } => {
                    let rate = fresh
                        .as_ref()
                        .map(|s| s.imu.gyro.iter().map(|w| w * w).sum::<f64>().sqrt());
                    let landed = landing.observe(
                        rate,
                        period,
                        params.safety.limp_fall_still_rate,
                        limp_fall_still,
                    );
                    // Whatever the gyro says: a robot held in someone's hands, or resting
                    // against something that keeps nudging it, must not stay limp forever.
                    let timed_out = tick_start.duration_since(since) >= limp_fall_max;
                    if landed || timed_out {
                        // From where the robot actually is. `hold` is where it was when
                        // driving stopped, which is a pose it has since collapsed out of —
                        // ramping from that would start with a jump.
                        let from = coast.known_positions(hold);
                        tracing::warn!(
                            limp_ms = tick_start.duration_since(since).as_millis(),
                            timed_out,
                            pose_ms = limp_fall_pose.as_millis(),
                            "landed — posing back to standing"
                        );
                        limp_fall = LimpFall::Posing {
                            from,
                            since: tick_start,
                        };
                    } else {
                        limp_fall = LimpFall::Limp { since, landing };
                    }
                }
                LimpFall::Posing { since, .. }
                    if !params.safety.limp_fall_hand_back
                        && tick_start.duration_since(since) >= limp_fall_pose =>
                {
                    // A policy that cannot stand up must not be handed a robot on the
                    // floor (see `limp_fall_hand_back`). Disabled, the loop holds the pose
                    // it was just ramped to; enabling again goes through the usual checks.
                    tracing::warn!(
                        "posed — the policy is disabled after the fall (limp_fall_hand_back = false)"
                    );
                    limp_fall = LimpFall::Idle;
                    falling.reset();
                    hold = DEFAULT_POSITION;
                    intents.set_enabled(false);
                }
                LimpFall::Posing { since, .. } => {
                    if tick_start.duration_since(since) >= limp_fall_pose {
                        tracing::warn!("posed — handing back to the standing policy");
                        limp_fall = LimpFall::Idle;
                        falling.reset();
                        hold = DEFAULT_POSITION;
                        getting_up = Some(Duration::ZERO);
                        // Hand back to the policy, and let it choose. The twist has been
                        // held at zero through the whole sequence, so with nobody driving
                        // the standing network is what command magnitude selects — which
                        // is the stand-up. A client that *is* driving gets its walk back;
                        // the humans stay in charge, here as everywhere else.
                        if let Some(controller) = controller.as_mut() {
                            controller.reset();
                        }
                    }
                }
            }
        }
        let in_limp_fall = limp_fall != LimpFall::Idle;
        // A robot handed back on the floor gets up before it is driven anywhere: on
        // 2026-10-07 a client still sending a walk got the fallen robot handed to the
        // walking network, which cannot get up and kicked at the floor until the client
        // stopped. Held until upright for `GET_UP_SETTLE`, or until someone else takes the
        // robot (disabled, a new fall).
        getting_up = match getting_up {
            Some(_) if !snapshot.enabled || in_limp_fall => None,
            Some(_) if safety.fallen() => Some(Duration::ZERO),
            Some(upright) => Some(upright + period).filter(|t| *t < GET_UP_SETTLE),
            None => None,
        };
        let hold_still = in_limp_fall || getting_up.is_some();

        // Smooth the command. The limp-fall sequence holds the twist at zero outright, so
        // the robot is not handed back mid-command; and leaving body-pose mode snaps the
        // body back to nominal rather than gliding, which is its B-button exit.
        // A servo too hot to walk on (`[thermal] walk_max_c`): stand until it cools, and say
        // so in `limited_by` rather than ignore the client.
        // A rest holds the robot still too, for the same reason.
        let too_hot = thermal.walk_blocked() || rest.active();
        if too_hot && gated.twist.iter().any(|v| *v != 0.0) {
            limits.push(duck_control::safety::Limit::Thermal);
        }
        let twist_target = if hold_still || too_hot {
            heading.reset();
            [0.0; 3]
        } else {
            heading.apply(gated.twist, safety.imu_ready().then(|| odometry.yaw()))
        };
        if in_limp_fall {
            twist_ema = [0.0; 3];
        }
        for (ema, target) in twist_ema.iter_mut().zip(twist_target) {
            *ema += cmd_alpha * (target - *ema);
        }
        for (ema, target) in head_ema.iter_mut().zip(gated.head) {
            *ema += head_alpha * (target - *ema);
        }
        if snapshot.pose.active {
            for (ema, target) in body_ema.iter_mut().zip(snapshot.pose.body) {
                *ema += cmd_alpha * (target - *ema);
            }
        } else {
            body_ema = [0.0; 3];
        }
        let command = PolicyCommand {
            twist: twist_ema,
            // The chorale's sway rides on top of whatever the head was asked to do, computed
            // last tick (20 ms stale, invisible at sway speed) and slewed to zero when the
            // singing stops so the head settles rather than snaps.
            head: [
                head_ema[0] + chorale_head[0],
                head_ema[1] + chorale_head[1],
                head_ema[2] + chorale_head[2],
                head_ema[3] + chorale_head[3],
            ],
            body: BodyPose {
                z: body_ema[0],
                roll: body_ema[1],
                pitch: body_ema[2],
            },
        };

        // Bring the robot up when someone asks it to drive and it has no torque yet.
        //
        // Not gated on the fall: a fallen robot ramps like any other, as the prototype
        // does. Being down is a report, and the humans stay in charge.
        //
        // Needs a sample: `from` is where the joints actually are, and starting a ramp from a
        // position nobody read would be the lurch this exists to avoid.
        // `controller.is_some()` as well, because this call means "enable the policy": powering the
        // joints to run a policy that is disabled or would not load is work towards nothing, and it
        // would make a release whose bundle is broken stand the robot up and then hold. A robot that
        // should stand without a policy is what `robotd init` is for.
        if let (Bringup::Limp, true, true, Some(sensors)) = (
            bringup,
            snapshot.enabled,
            controller.is_some(),
            sensors.as_ref(),
        ) {
            if let Some(why) = state
                .battery_refusal()
                .or_else(|| ramp_refusal(&sensors.positions))
            {
                // Cleared, not retried: this path runs every tick while `enabled` is set, and
                // the joint will not move back by itself (nor the pack change). Enabling again
                // once it is put right starts the ramp.
                tracing::warn!(reason = %why, "enable refused: the robot stays limp");
                intents.set_enabled(false);
            } else {
                match safety.set_torque(true) {
                    Ok(()) => {
                        if seated_boot && controller.as_ref().is_some_and(|c| c.has_sitstand()) {
                            // Seated boot: hold the seat and rise via the sitstand network —
                            // the linear ramp would drag folded legs sideways through the floor.
                            seated_boot = false;
                            tracing::warn!("seated boot — rising via the sitstand policy");
                            controller
                                .as_mut()
                                .expect("checked above")
                                .begin_boot_rise();
                            bringup = Bringup::Ready;
                        } else {
                            tracing::warn!(
                                ?HOME_RAMP,
                                "enabling the policy: torque on, ramping to home"
                            );
                            bringup = Bringup::Homing {
                                from: sensors.positions,
                                since: tick_start,
                            };
                        }
                    }
                    // Reported, not fatal, and it stays `Limp` so the next tick tries again: a bus that
                    // dropped one transaction is ordinary, and a robot that refused to ever come up
                    // because of it would be worse than one that keeps asking.
                    Err(e) => {
                        tracing::warn!(error = %e, "cannot enable torque; the robot stays limp")
                    }
                }
            }
        }
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
