canadoce/DuckBuddy/robotd-params/src/lib.rs

//! `robotd`'s startup parameters: the schema, the defaults, and the validation.
//!
//! A file rather than a wall of CLI flags — the prototype grew 142 of them and most were
//! variants, dead skills and dead sensors, all of which are gone. **Read once at startup,
//! not watched**; live reload is deferred (`docs/design/robotd-design.md` §4.2). That fact
//! is load-bearing for tooling: *any* change to the file requires a `robotd` restart, so an
//! editor never has to ask which keys are live.
//!
//! It lives outside `releases/<ver>/` so it survives an update *and* a rollback: this is
//! per-robot configuration, not shipped defaults (`architecture.md` §3).
//!
//! A crate of its own rather than a module of `robotd`, for one consumer: `robotctl
//! configure` edits the file interactively, and doing that against a copied schema is how a
//! copied schema drifts. [`registry`] is the machine-readable index of every key — what it
//! is, what it defaults to, what values it takes — and its completeness is enforced by a
//! test that walks [`Params`]'s own serialization, so a new section cannot be added without
//! the registry (and therefore the editor) learning about it.

pub mod registry;

use std::path::{Path, PathBuf};

use serde::{Deserialize, Serialize};

/// Where a release is mounted. Policy paths default under here, so an ordinary update
/// carries the policy with the binaries that were trained against it.
pub const RELEASE_DIR: &str = "/opt/robot/daemon/current";

/// Where a provisioned robot keeps it, alongside the updater's own config.
pub const DEFAULT_PATH: &str = "/etc/robot/robotd.toml";

#[derive(Debug, Clone, Default, Serialize, Deserialize)]
#[serde(deny_unknown_fields, default)]
pub struct Params {
    pub bus: Bus,
    pub control: Control,
    pub update_gate: UpdateGate,
    pub policy: PolicyParams,
    pub safety: SafetyParams,
    pub audio: AudioParams,
    pub theremin: ThereminParams,
    pub chorale: ChoraleParams,
    pub media: MediaParams,
    pub detect: DetectParams,
    pub thermal: Thermal,
    pub battery: BatteryParams,
}

/// The packs this robot takes. robotd tells which one is plugged in from a reading at rest,
/// before any torque (`duck_control::identify_pack`: 2S or 3S, LiPo or LiHV), and takes every
/// threshold per cell from there. What this robot is built for is the one thing it cannot
/// read: its servos — HL-2915s want 3S (9–14 V), HD-1910s want 2S and burn on 3S (4–8.4 V).
/// A pack outside this is refused: the robot stays limp and says why.
#[derive(Debug, Clone, Serialize, Deserialize)]
#[serde(deny_unknown_fields, default)]
pub struct BatteryParams {
    /// Cell counts this robot runs on. `[3]` for the HL-2915 robot, `[2]` for an HD-1910 one;
    /// both (the default) for a file that has not said.
    pub cells: Vec<u8>,
    /// The servos' rated supply, V: a pack reading above it at rest is refused (a full 2S LiHV
    /// is 8.7 V, over an HD-1910's 8.4). `0` (the default) checks only the cell count.
    pub max_volts: f64,
}

impl Default for BatteryParams {
    fn default() -> Self {
        Self {
            cells: vec![2, 3],
            max_volts: 0.0,
        }
    }
}

/// The servo temperature guard (`duck_control::thermal`), acting on the hottest servo once a
/// second. The servos latch their own overheat shutdown and cut torque (the HL-2915s on the
/// robot: register 13 = 80 °C, 2026-10-11), which drops a walking robot; this stops short of it. On the HL-2915
/// robot (2026-10-10) a walking trial warmed the hottest servo 6–8 °C and two or three in a
/// row reached 58–61 °C; 1.5 minutes with torque off brought 61 °C back to 48.
#[derive(Debug, Clone, Serialize, Deserialize)]
#[serde(deny_unknown_fields, default)]
pub struct Thermal {
    /// Log a warning when the hottest servo reaches this, °C. `0` turns it off.
    pub warn_c: f64,
    /// Refuse to walk while the hottest servo is at or above this, °C: the twist is zeroed
    /// and `robot.state` reports `thermal` in `limited_by`. `0` turns it off.
    pub walk_max_c: f64,
    /// Sit down (the sitstand policy) once the hottest servo reaches this while the robot is
    /// standing still, °C. `0` (the default) turns it off: it needs a sitstand policy, and none
    /// had been tried on the HL-2915 robot when this was written.
    pub sit_c: f64,
    /// How far below a threshold the hottest servo must cool before the threshold clears, °C.
    pub hysteresis_c: f64,
    /// Rest once the hottest servo reaches this while the robot stands still, °C: sit, let the
    /// legs go limp, stand again at `resume_c` (`duck_control::rest`). Unlike `sit_c` the legs
    /// cool — a held sit does not (2026-10-11: 58 → 61 °C in a minute). `0` (the default) turns
    /// it off; it needs a sitstand policy and a bus that can leave single joints limp.
    pub rest_c: f64,
    /// A rest ends once the hottest servo is at or below this, °C.
    pub resume_c: f64,
    /// A rest lasts at least this long once the legs are limp, seconds.
    pub rest_min_s: f64,
    /// During a rest the head goes limp too once its hottest servo (neck, head pitch / yaw /
    /// roll) is at or above this, °C. The neck holds the head up through the whole rest and
    /// kept heating while the legs cooled (2026-10-13: legs 34–36 °C, neck 55). `0` (the
    /// default) keeps the head powered — it can still look at someone while the duck rests.
    pub rest_head_c: f64,
    /// A deep rest (head limp too) sits instead of lying down: seated on a flat floor, the
    /// whole robot let go stays put (the user, 2026-10-14) — the stand-in until a lie-down that
    /// lands softly. Needs the sitstand policy rather than the lie one.
    pub deep_sit: bool,
}

impl Default for Thermal {
    fn default() -> Self {
        Self {
            warn_c: 55.0,
            walk_max_c: 65.0,
            sit_c: 0.0,
            hysteresis_c: 5.0,
            rest_c: 0.0,
            resume_c: 45.0,
            rest_min_s: 30.0,
            rest_head_c: 0.0,
            deep_sit: false,
        }
    }
}

/// The one video mode a robot streams in, as a name rather than four numbers.
///
/// **Frame size, rate and a matching bitrate move together or not at all.** They are not
/// independent settings: 1080p at the 2 Mb/s that suits 720p is a smear, and 720p at 6 Mb/s
/// spends a link's headroom on nothing. Offering `width`, `height`, `fps` and `bitrate` as four
/// keys would make every wrong combination of them expressible — including the ones the capture
/// path cannot produce at all, and a pipeline that will not start costs the WebRTC *control*
/// channel along with the video, because the two are bundled (`remote-webrtc.md`).
///
/// So the ladder is fixed, and every rung is 16:9 — the sensor's own aspect. A mode that changed
/// the shape of the picture would be cropping or squashing rather than lowering quality, which is
/// not what anybody picking "smaller" is asking for.
#[derive(Debug, Clone, Copy, PartialEq, Eq, Default, Serialize, Deserialize)]
pub enum Quality {
    /// The sensor's full frame. The most detail, and the rung least likely to hold 30 fps on
    /// this ISP path — [`MediaParams`] says what is measured and what is not.
    #[serde(rename = "1080p30")]
    Q1080p30,
    /// What every measurement in `mediad` was taken at, and the default.
    #[default]
    #[serde(rename = "720p30")]
    Q720p30,
    /// Same picture, half the frames: the rung for a link that cannot carry 30.
    #[serde(rename = "720p15")]
    Q720p15,
    /// Small and cheap, for a bad link or a busy CPU.
    #[serde(rename = "360p30")]
    Q360p30,
}

/// Every mode, in the order an editor cycles them — and the strings the file uses.
///
/// One list, so the registry's choices, the file's values and [`Quality`] itself cannot disagree;
/// [`tests::every_quality_label_round_trips`] pins it to the enum in both directions.
pub const QUALITY_LABELS: &[&str] = &["1080p30", "720p30", "720p15", "360p30"];

impl Quality {
    /// The modes, in [`QUALITY_LABELS`] order.
    pub const ALL: [Quality; 4] = [
        Quality::Q1080p30,
        Quality::Q720p30,
        Quality::Q720p15,
        Quality::Q360p30,
    ];

    /// The name this mode has in the file.
    pub fn label(self) -> &'static str {
        match self {
            Quality::Q1080p30 => "1080p30",
            Quality::Q720p30 => "720p30",
            Quality::Q720p15 => "720p15",
            Quality::Q360p30 => "360p30",
        }
    }

    /// Frame size in pixels. Every rung is 16:9 and every dimension is a multiple of 8, which
    /// is what the ISP's scaler and the encoder's macroblocks both want.
    pub fn size(self) -> (u32, u32) {
        match self {
            Quality::Q1080p30 => (1920, 1080),
            Quality::Q720p30 | Quality::Q720p15 => (1280, 720),
            Quality::Q360p30 => (640, 360),
        }
    }

    pub fn width(self) -> u32 {
        self.size().0
    }

    pub fn height(self) -> u32 {
        self.size().1
    }

    pub fn fps(self) -> u32 {
        match self {
            Quality::Q720p15 => 15,
            _ => 30,
        }
    }

    /// What this mode streams at when `[media] bitrate` is unset — bits per second.
    ///
    /// Scaled with the pixel rate rather than picked per rung: 720p30 is the measured 2 Mb/s
    /// `mediad` has always used, and the others are that number times their share of the pixels
    /// per second, rounded to something a human can read. Congestion control moves from here, so
    /// this is a starting point rather than a cap.
    pub fn default_bitrate(self) -> u32 {
        match self {
            Quality::Q1080p30 => 4_000_000,
            Quality::Q720p30 => 2_000_000,
            Quality::Q720p15 => 1_000_000,
            Quality::Q360p30 => 800_000,
        }
    }
}

/// How `mediad` decides what bitrate to actually send at.
///
/// **This is a CPU setting as much as a network one.** The estimator is not free: on the board,
/// with one peer connected, `rtpgccbwe` is the single largest consumer in the process — 7.6% of a
/// core against `v4l2src`'s 0.3% — because it works per packet while capture works per DMABuf
/// handle. Turning it off deletes that thread.
///
/// What it costs is adaptivity, and that is not a small thing: adapting the rate to the link is
/// the whole reason `webrtcsink` is handed raw video rather than pre-encoded H.264
/// (`mediad::pipeline`). On a link that stays good — a robot one hop away on its own LAN — the
/// estimator spends CPU discovering a ceiling it will never hit. On a link that degrades, it is
/// what keeps a picture rather than a stall.
///
/// **It also decides what `bitrate` means.** With an estimator running, `bitrate` is a starting
/// point it ramps away from within seconds. Disabled, nothing moves it, and `bitrate` is the rate.
#[derive(Debug, Clone, Copy, PartialEq, Eq, Default, Serialize, Deserialize)]
#[serde(rename_all = "lowercase")]
pub enum CongestionControl {
    /// Nothing adapts. `bitrate` is exactly what is sent, and a link that degrades degrades the
    /// picture rather than the rate.
    Disabled,
    /// `webrtcsink`'s own sender-side heuristic. Cheaper than the estimator, blunter than it.
    Homegrown,
    /// Google Congestion Control, and `webrtcsink`'s own default — so this is what every robot has
    /// been running, and naming it here changes nothing.
    #[default]
    Gcc,
}

/// Every mode, in the order an editor cycles them.
///
/// These are `webrtcsink`'s own property nicknames rather than names of ours: they are what gets
/// set on the element, and a second vocabulary in between would be one more thing to get wrong.
/// Note `gcc`, not `googcc` — [`tests::every_congestion_label_round_trips`] pins the spelling.
pub const CONGESTION_LABELS: &[&str] = &["disabled", "homegrown", "gcc"];

impl CongestionControl {
    pub const ALL: [CongestionControl; 3] = [
        CongestionControl::Disabled,
        CongestionControl::Homegrown,
        CongestionControl::Gcc,
    ];

    /// The `congestion-control` nickname `webrtcsink` knows this by.
    pub fn nick(self) -> &'static str {
        match self {
            CongestionControl::Disabled => "disabled",
            CongestionControl::Homegrown => "homegrown",
            CongestionControl::Gcc => "gcc",
        }
    }
}

/// `[media]` — what `mediad` streams.
///
/// **These were command-line flags in `mediad.service`, and that is why this section exists.**
/// The release installer rewrites that unit file, so the only supported way to change a flag was
/// a systemd drop-in — a mechanism nobody reaches for to answer "why is the video soft?". Here
/// they are three keys in the file `robotctl configure` already edits.
///
/// `mediad` reads this file at startup and nothing else does anything to it, so a change needs
/// `systemctl restart mediad` — not `robotd`. The editor offers the right one.
///
/// **What is measured and what is not.** 720p30 is the rung every number in `mediad::pipeline`
/// comes from: 29.3 fps off the ISP main path, with the capture format and buffer depth that took
/// three bench sessions to find. The sensor is pinned to a 1920x1080 mode that runs at 30 and the
/// ISP scales down from it, so 1080p30 asks for no scaling at all — what is unmeasured there is
/// whether the capture path and the encoder hold 30 fps at 2.25x the pixels. A rung that does not
/// hold runs slower; it is not a pipeline that fails to start.
#[derive(Debug, Clone, Serialize, Deserialize)]
#[serde(deny_unknown_fields, default)]
pub struct MediaParams {
    /// Stream the head camera. `false` streams a test pattern instead, which is what a board
    /// with no camera wants: the pipeline starts, so the WebRTC control channel exists.
    pub camera: bool,
    /// Frame size and rate, as one name. [`Quality`] says why it is one key and not four.
    pub quality: Quality,
    /// Starting video bitrate, bits per second. Unset follows the quality —
    /// [`Quality::default_bitrate`] — which is what almost every robot wants.
    ///
    /// A *starting* point unless `congestion_control` is `disabled`, which is the one setting that
    /// makes this the rate.
    pub bitrate: Option<u32>,
    /// Whether the send rate adapts to the link, and by what. [`CongestionControl`] has the
    /// trade — it is the largest single CPU consumer in this process.
    pub congestion_control: CongestionControl,
}

impl Default for MediaParams {
    fn default() -> Self {
        Self {
            // On, because a robot with a camera is the case, and a board without one shows a
            // test pattern rather than nothing only if somebody turns this off.
            camera: true,
            quality: Quality::default(),
            bitrate: None,
            // `webrtcsink`'s own default, named rather than inherited: what the element defaults
            // to is a fact about a plugin we ship from a pinned release, and the day it changes
            // should not be the day every robot's send rate changes with it.
            congestion_control: CongestionControl::default(),
        }
    }
}

/// `[detect]` — finding other ducks in the camera.
///
/// **Read by `mediad`, not by `robotd`**, which is a first for this file: the frames are on
/// `mediad`'s tee and perception belongs next to the sensor. It lives here anyway, because this is
/// the file `robotctl configure` edits and a robot has one place where its switches are — a second
/// config file for the second daemon that wants one is how a fleet ends up with settings nobody can
/// find.
#[derive(Debug, Clone, Serialize, Deserialize)]
#[serde(deny_unknown_fields, default)]
pub struct DetectParams {
    /// Off by default. The detector costs a model in the release, ~50 ms of CPU per frame and some
    /// heat; a robot that nothing asks to look for ducks should not be paying for it.
    pub enabled: bool,
    /// Where to look, and therefore *what runs it*: a `.rknn` goes to the NPU, an `.onnx` runs on
    /// the CPU. Absent means the release's own model, NPU first — see [`DetectParams::model`].
    pub model: Option<PathBuf>,
    /// Frames per second to run the detector at.
    ///
    /// **2 Hz is a thermal number, not a taste.** Flat out on a Radxa Zero 3 this reaches 95 °C and
    /// the CPU throttles to 408 MHz, which is a robot that walks badly to see well. Two looks a
    /// second is plenty for "is there a duck over there", and costs about a tenth of one core.
    pub hz: f64,
    /// Confidence a detection needs, against **this** model.
    ///
    /// A quantised model's output tensor carries its own scale, so the number that means 0.9 on the
    /// float model does not mean 0.9 here — the INT8 scores of the shipped model saturate around
    /// 1.4. Tuned on the board, not inherited from training.
    pub threshold: f32,
}

impl Default for DetectParams {
    fn default() -> Self {
        Self {
            enabled: false,
            model: None,
            hz: 2.0,
            threshold: 0.35,
        }
    }
}

impl MediaParams {
    /// The bitrate the daemon will actually start at.
    pub fn bitrate_resolved(&self) -> u32 {
        self.bitrate
            .unwrap_or_else(|| self.quality.default_bitrate())
    }
}

impl DetectParams {
    /// The models to try, best first. Empty when the detector is off.
    ///
    /// **A list, not a choice**, because whether the NPU works is not something this file can know.
    /// The `.rknn` is preferred — it is why the detector is cheap — but a board whose NPU is
    /// disabled in its device tree (which is how Armbian ships the Radxa Zero 3) or which never ran
    /// `setup-npu.sh` has no runtime to load it with. Falling through to the `.onnx` means such a
    /// board still sees, on the CPU, instead of logging one warning and doing nothing for ever.
    ///
    /// An explicit `model` is the operator being specific, so it is tried alone.
    pub fn models(&self) -> Vec<PathBuf> {
        if !self.enabled {
            return Vec::new();
        }
        if let Some(path) = &self.model {
            if is_none_sentinel(path) {
                return Vec::new();
            }
            return vec![path.clone()];
        }
        let release = PathBuf::from(RELEASE_DIR).join("models");
        [
            release.join("duck_detect.rknn"),
            release.join("duck_detect.onnx"),
        ]
        .into_iter()
        .filter(|path| path.exists())
        .collect()
    }
}

/// `[chorale]` — several ducks singing one piece.
///
/// `accept` is **false by default, and that is the whole section.** A chorale is not only a sound:
/// it moves the mouth and it moves the head. A robot that began animating because another robot
/// walked into the room would be doing motion nobody asked for, in someone's living room, and two
/// people's ducks in a café have no business pairing up. Off also means *invisible* rather than
/// visibly declining — a duck that has not opted in puts nothing on the air at all.
#[derive(Debug, Clone, Default, Serialize, Deserialize)]
#[serde(deny_unknown_fields, default)]
pub struct ChoraleParams {
    /// Whether this robot may sing with others at all. `false` — and it is derived rather than
    /// written out, so that the default cannot be changed by editing one word.
    pub accept: bool,
}

/// `[theremin]` — the ToF theremin: what counts as a hand, and where the depth frames come
/// from.
///
/// The interesting field is `statuses`, and it is the reason this section exists at all. ST
/// documents 5 and 9 as "range valid", and a build that believes only those stops seeing a
/// hand at about 30 cm on this sensor — past that a moving hand comes back as 4 or 13,
/// *consistency failed*, carrying a distance that is fine for a pitch. That took a bench
/// session to find, so the set is configurable: a duck whose theremin has a short reach wants
/// more codes in, and one that plays phantom notes at nothing wants fewer.
#[derive(Debug, Clone, Serialize, Deserialize)]
#[serde(deny_unknown_fields, default)]
pub struct ThereminParams {
    /// Master switch. On by default: the instrument still has to be picked up with
    /// `robot.theremin`, so what this turns off is the *ability* to, on a duck where the
    /// feature is unwanted or the sensor is known bad.
    pub enabled: bool,
    /// `tofd`'s depth stream.
    pub socket: PathBuf,
    /// Nearest playable range, metres.
    pub near_m: f64,
    /// Farthest playable range, metres.
    pub far_m: f64,
    /// Fewest zones that make a hand.
    pub min_zones: usize,
    /// ST status bytes whose distance is believed. See the section docs — this is the one
    /// that decides how far the instrument reaches.
    pub statuses: Vec<u8>,
    /// How long a note is held through a sensor dropout, milliseconds. This is what keeps a
    /// flickering zone from chopping a note into gravel.
    pub hold_ms: u64,
}

impl Default for ThereminParams {
    fn default() -> Self {
        let hand = kinematics::hand::Config::default();
        Self {
            enabled: true,
            socket: PathBuf::from(duck_ipc_proto::socket::TOF),
            near_m: hand.near_m,
            far_m: hand.far_m,
            min_zones: hand.min_zones,
            statuses: hand.statuses,
            hold_ms: hand.hold.as_millis() as u64,
        }
    }
}

impl ThereminParams {
    /// The hand-detection config these params describe.
    pub fn hand(&self) -> kinematics::hand::Config {
        kinematics::hand::Config {
            near_m: self.near_m,
            far_m: self.far_m,
            min_zones: self.min_zones,
            statuses: self.statuses.clone(),
            hold: std::time::Duration::from_millis(self.hold_ms),
        }
    }
}

/// `[audio]` — the voice and the microphone. All optional equipment: a robot without a
/// codec (or a bank) walks identically and stays quiet, so nothing here reaches a health
/// verdict.
#[derive(Debug, Clone, Serialize, Deserialize)]
#[serde(deny_unknown_fields, default)]
pub struct AudioParams {
    /// Master switch: no sounds, no mic worker.
    pub enabled: bool,
    /// ALSA playback device — the TLV320AIC3104 codec.
    pub device: String,
    /// Where the per-robot voice bank lives. The release's postinstall renders it there
    /// (`sounds ensure-bank`), seeded from the SoC serial.
    pub bank: PathBuf,
    /// Quack once as the control loop comes up. On by default because on a headless board
    /// it is the audible "robotd is running"; off for anyone who restarts the daemon all
    /// day and would rather it did so quietly.
    pub greet: bool,
    /// Listen for petting on the onboard mic and coo about it. Absent means **off**: the
    /// per-mode resolution the prototype shipped (on for walking) cooed at every incidental
    /// head scratch, which wore thin fast. Set `true` to opt in.
    pub pet_detect: Option<bool>,
    /// The petting classifier. Absent means the release's copy; the literal `"none"`
    /// disables it outright.
    pub pet_model: Option<PathBuf>,
    /// Probability above which petting starts, and below which it ends (hysteresis).
    pub pet_enter_threshold: f32,
    pub pet_exit_threshold: f32,
    /// Take steady background noise — the rev-a head fan — out of the mic stream before
    /// anything listens to it. On the robot it lifted a voice at 1 m from 17 to 25 dB over
    /// the fan without touching the voice itself.
    pub denoise: bool,
    /// Open the beak with the loudness of the voice-bank sound playing (`robot.sound`, the
    /// trigger's chirp, the greet), on top of any mouth intent.
    pub lipsync: bool,
}

impl Default for AudioParams {
    fn default() -> Self {
        Self {
            enabled: true,
            device: "plughw:aic3104".to_owned(),
            bank: PathBuf::from("/var/lib/robot/sounds"),
            greet: true,
            pet_detect: None,
            pet_model: None,
            pet_enter_threshold: 0.95,
            pet_exit_threshold: 0.85,
            denoise: true,
            lipsync: true,
        }
    }
}

impl AudioParams {
    /// Whether the mic worker runs, resolved against the drive mode.
    pub fn pet_detect_resolved(&self, _mode: Mode) -> bool {
        // Off unless asked for, in either mode. It used to resolve per mode as the prototype's
        // launcher did (on for walking, off for the roller) — and cooing at every incidental
        // head scratch turned out to be more annoying than charming in daily use. The mode is
        // still passed so flipping this back is a one-line change, not a signature change.
        self.pet_detect.unwrap_or(false)
    }

    /// The capture PCM for the mic worker: the playback device with subdevice 0. Only
    /// appended when the operator has not already spelled a subdevice out — `plughw:aic3104`
    /// in `robotd.toml` is the default and needs it, but the equally natural full spec
    /// `plughw:aic3104,0` would otherwise become `plughw:aic3104,0,0`, which no card
    /// answers to. That lands the worker in its restart loop for the life of the daemon.
    pub fn capture_device(&self) -> String {
        if self.device.contains(',') {
            self.device.clone()
        } else {
            format!("{},0", self.device)
        }
    }

    /// The classifier path, or `None` when disabled with the `"none"` sentinel.
    pub fn pet_model_resolved(&self) -> Option<PathBuf> {
        match &self.pet_model {
            Some(p) if is_none_sentinel(p) => None,
            Some(p) => Some(p.clone()),
            None => Some(PathBuf::from(RELEASE_DIR).join("models/pet_detect.onnx")),
        }
    }
}

/// Which drive configuration this robot runs. One robot, two personalities: legs, or the
/// roller. They differ in policies *and* tuning, so the mode is one switch here rather than
/// six paths an operator has to keep consistent — the prototype's launcher kept two whole
/// command lines for the same reason. Switching is an edit plus `systemctl restart robotd`.
#[derive(Debug, Clone, Copy, Default, PartialEq, Eq, Serialize, Deserialize)]
#[serde(rename_all = "snake_case")]
pub enum Mode {
    #[default]
    Walk,
    Roller,
}

impl Mode {
    pub fn as_str(self) -> &'static str {
        match self {
            Mode::Walk => "walk",
            Mode::Roller => "roller",
        }
    }
}

#[derive(Debug, Clone, Serialize, Deserialize)]
#[serde(deny_unknown_fields, default)]
pub struct PolicyParams {
    /// Whether to load a policy at all.
    ///
    /// False means slice 1's behaviour: run the loop, hold the pose, stay healthy. That is a
    /// legitimate configuration — it is the safest thing to be doing while hammering
    /// install/rollback cycles at a bench — and it is distinct from a policy that was wanted
    /// and could not be loaded, which is unhealthy.
    pub enabled: bool,
    /// `walk` (default) or `roller`. Changes which policies load *and* the tuning defaults
    /// below — every unset field resolves per mode, so a roller robot needs one line.
    pub mode: Mode,
    /// Policy paths. Absent means the mode's default inside the release directory, so a
    /// normal update ships them; point one elsewhere to try a build without cutting a
    /// release. The literal `"none"` disables a slot outright — the prototype's convention.
    pub walk: Option<PathBuf>,
    /// Standing policy. Without one the walking policy runs at every velocity.
    pub stand: Option<PathBuf>,
    /// Commanded sit↔stand (posture flag in the twist `vx` slot). Sit toggle, shutdown sit
    /// and the seated-boot rise all need it.
    pub sitstand: Option<PathBuf>,
    /// Phase-scripted ground pick. In roller mode this slot holds the crouch.
    pub ground_pick: Option<PathBuf>,
    pub kick_left: Option<PathBuf>,
    pub kick_right: Option<PathBuf>,
    /// Episodic forward roll. Ships by default in both modes, as the prototype now does.
    pub roulade: Option<PathBuf>,
    /// Commanded lie-down↔stand (posture flag in the twist `vx` slot, like `sitstand`): lying on
    /// the shins and the soft jaw. The lie toggle and the deep rest need it. No release default.
    pub lie: Option<PathBuf>,
    /// Scales raw policy output into a joint offset. Absent resolves per mode: 0.9 walking
    /// (the prototype's alpha default), 0.8 roller.
    pub action_scale: Option<f64>,
    pub standing_action_scale: f64,
    /// Standing runs softer, at this fraction of `gain`.
    pub standing_gain_ratio: f64,
    /// Position P gain while running.
    pub gain: u16,
    /// First-order low-pass on the head joint targets, `1.0` = pass-through. Default 0.5
    /// in both modes — the value the alpha policies are *trained* with, so it must match
    /// or transfer degrades. (The roller preset used to ship it off; the prototype rebased
    /// its roller line on the alpha defaults, and this follows.)
    pub head_lowpass: Option<f64>,
    /// A dead band on the head targets, radians: a head joint's target is only moved once the
    /// filtered target is this far from the one last sent. Absent or 0: off. The policies'
    /// head outputs wander 0.5-1 deg on a still robot, and every tick's new target set the head
    /// servos hunting in their gear play (2026-10-15, sitting: head_yaw moved 3x its target's
    /// step, and ran hottest of all); 0.006 is about a third of a degree.
    pub head_deadband: Option<f64>,
    /// Same, for the ten leg joints. Walking default 0.7.
    pub legs_lowpass: Option<f64>,
    /// After walking, how long the walking network keeps driving once the command has
    /// dropped under the standing threshold, seconds, before the standing network takes
    /// over. Absent: the standing network takes over on that very tick, as the prototype
    /// does — on the HL-2915 robot (2026-10-09) that swap of network, gain and action scale
    /// in one tick, mostly with a foot in the air, put it down on 7 of 8 stops. The
    /// walking policies are trained at zero command too, so they can bring the robot to
    /// rest. A fall's hand-back still goes straight to the standing network.
    pub walk_settle_s: Option<f64>,
    /// The walking network also stands the robot still — for a walk-and-stand (VelStand)
    /// policy. The standing network then only gets the robot up after a fall, and hands
    /// back once it has been upright for a second.
    pub walk_stands: bool,
    /// One ground-pick cycle, seconds. The move ends at 70% of the cycle, as the prototype
    /// does. Absent resolves per mode: 4.0 walking, 3.0 roller (the crouch).
    pub ground_pick_period: Option<f64>,
    /// Action scale while the ground pick runs. Absent: 1.0 walking, 0.8 roller.
    pub ground_pick_action_scale: Option<f64>,
    /// Gain multiplier while the ground pick runs.
    pub ground_pick_gain_ratio: f64,
    /// How long a kick window stays on the kick network, seconds.
    pub kick_duration: f64,
    /// One roulade — one forward roll, seconds. Holding the button chains rolls; this is
    /// the length of each. The prototype's measured single-roll time.
    pub roulade_duration: f64,
    /// Action scale while a roulade runs.
    pub roulade_action_scale: f64,
    /// Gain multiplier while a roulade runs.
    pub roulade_gain_ratio: f64,
    /// Scale actions with battery voltage: effective scale × (nominal / measured). The
    /// servos' effective kP tracks their supply, so this holds the robot's response steady
    /// as the pack sags. Off by default, as in the prototype.
    pub voltage_adapt: bool,
    /// Reference voltage for `voltage_adapt` — the supply the gains were identified at.
    pub nominal_voltage: f64,
}

/// The literal that disables an optional policy slot, per the prototype's `--x-policy None`.
fn is_none_sentinel(path: &std::path::Path) -> bool {
    path.as_os_str().eq_ignore_ascii_case("none")
}

/// `[policy]` with every absent field resolved against the mode's defaults.
///
/// This is what the rest of `robotd` consumes — nothing downstream should ever have to ask
/// "walk or roller?" to know the action scale.
#[derive(Debug, Clone, PartialEq)]
pub struct ResolvedPolicy {
    pub enabled: bool,
    pub mode: Mode,
    pub walk: PathBuf,
    pub stand: Option<PathBuf>,
    pub sitstand: Option<PathBuf>,
    pub ground_pick: Option<PathBuf>,
    pub kick_left: Option<PathBuf>,
    pub kick_right: Option<PathBuf>,
    pub roulade: Option<PathBuf>,
    pub lie: Option<PathBuf>,
    pub action_scale: f64,
    pub standing_action_scale: f64,
    pub standing_gain_ratio: f64,
    pub gain: u16,
    pub head_lowpass: Option<f64>,
    pub head_deadband: Option<f64>,
    pub legs_lowpass: Option<f64>,
    pub walk_settle_s: Option<f64>,
    pub walk_stands: bool,
    pub ground_pick_period: f64,
    pub ground_pick_action_scale: f64,
    pub ground_pick_gain_ratio: f64,
    pub kick_duration: f64,
    pub roulade_duration: f64,
    pub roulade_action_scale: f64,
    pub roulade_gain_ratio: f64,
    pub voltage_adapt: bool,
    pub nominal_voltage: f64,
}

impl PolicyParams {
    pub fn resolved(&self) -> ResolvedPolicy {
        let release = |name: &str| PathBuf::from(RELEASE_DIR).join("policies").join(name);
        let path = |field: &Option<PathBuf>, default: Option<&str>| -> Option<PathBuf> {
            match field {
                Some(p) if is_none_sentinel(p) => None,
                Some(p) => Some(p.clone()),
                None => default.map(release),
            }
        };

        let (walk_default, stand, sitstand, ground_pick, kick) = match self.mode {
            Mode::Walk => (
                "alpha_walking.onnx",
                Some("alpha_stand.onnx"),
                Some("alpha_sitstand.onnx"),
                Some("alpha_ground_pick.onnx"),
                true,
            ),
            // The prototype's roller preset, since rebased on the alpha defaults: roller
            // policy, crouch on the ground-pick trigger, and everything else — sit/stand,
            // kicks, the trained low-pass — as the walking mode has it. `stand` stays
            // unloaded, deliberately: the prototype loads the standing network in roller
            // mode and then skips every standing transition while `roller_mode` is set, so
            // it never runs — not loading it is the same robot without the dead session.
            Mode::Roller => (
                "roller.onnx",
                None,
                Some("alpha_sitstand.onnx"),
                Some("roller_crouch.onnx"),
                true,
            ),
        };

        ResolvedPolicy {
            enabled: self.enabled,
            mode: self.mode,
            walk: path(&self.walk, Some(walk_default)).expect("walk always has a default"),
            stand: path(&self.stand, stand),
            sitstand: path(&self.sitstand, sitstand),
            ground_pick: path(&self.ground_pick, ground_pick),
            kick_left: path(&self.kick_left, kick.then_some("ball_kick_left.onnx")),
            kick_right: path(&self.kick_right, kick.then_some("ball_kick_right.onnx")),
            roulade: path(&self.roulade, Some("roulade.onnx")),
            lie: path(&self.lie, None),
            action_scale: self.action_scale.unwrap_or(match self.mode {
                Mode::Walk => 0.9,
                Mode::Roller => 0.8,
            }),
            standing_action_scale: self.standing_action_scale,
            standing_gain_ratio: self.standing_gain_ratio,
            gain: self.gain,
            head_lowpass: Some(self.head_lowpass.unwrap_or(0.5)).filter(|a| *a < 1.0),
            head_deadband: self.head_deadband.filter(|d| *d > 0.0),
            legs_lowpass: Some(self.legs_lowpass.unwrap_or(0.7)).filter(|a| *a < 1.0),
            walk_settle_s: self.walk_settle_s.filter(|s| *s > 0.0),
            walk_stands: self.walk_stands,
            ground_pick_period: self.ground_pick_period.unwrap_or(match self.mode {
                Mode::Walk => 4.0,
                Mode::Roller => 3.0,
            }),
            ground_pick_action_scale: self.ground_pick_action_scale.unwrap_or(match self.mode {
                Mode::Walk => 1.0,
                Mode::Roller => 0.8,
            }),
            ground_pick_gain_ratio: self.ground_pick_gain_ratio,
            kick_duration: self.kick_duration,
            roulade_duration: self.roulade_duration,
            roulade_action_scale: self.roulade_action_scale,
            roulade_gain_ratio: self.roulade_gain_ratio,
            voltage_adapt: self.voltage_adapt,
            nominal_voltage: self.nominal_voltage,
        }
    }
}

#[derive(Debug, Clone, Serialize, Deserialize)]
#[serde(deny_unknown_fields, default)]
pub struct SafetyParams {
    /// Projected-gravity z above which the robot counts as going down. Upright is about
    /// -1.0; on its side is near 0.
    pub fall_gravity_z: f64,
    /// How long that has to hold. Debounced so a firm footfall is not a fall.
    pub fall_debounce_ms: u64,
    /// Intent age past which the velocity is zeroed. Stop, not limp.
    pub deadman_ms: u64,
    /// The gain limp-fall yields at — low enough to give way rather than fight the floor.
    pub gain_limp: u16,
    /// Sit down and power the machine off when the battery EMA reaches the pack's empty floor
    /// (3.3 V a cell: 9.9 V on 3S, 6.6 V on 2S — `duck_control::Pack::empty_v`). The EMA moves
    /// over ~10 s, so a load sag cannot trip it.
    ///
    /// The power-off is `systemctl poweroff`, which logind refuses a non-root user without a
    /// polkit rule — and a refused power-off leaves the computer running on a pack that is
    /// already empty: on 2026-10-05 the robot went limp at 9.9 V as designed, the power-off
    /// was refused, and the pack was at 7.3 V five minutes later.
    pub battery_empty_shutdown: bool,

    /// Go limp *while falling*, to land soft instead of fighting the floor all the way
    /// down. **On by default** since it was validated on a robot — the whole point is that
    /// the fleet lands soft, and a mode every board has to opt into individually is a mode
    /// most boards do not have.
    ///
    /// The only thing the daemon does about a fall. Drop to `gain_limp`, let the robot
    /// collapse, pose it back to standing once it has landed, then hand it to the standing
    /// policy — which stands up far more cleanly from a still robot than from one that has
    /// been thrashing since the fall began. With it off, a fall changes nothing: the policy
    /// keeps driving and the humans stay in charge.
    pub limp_fall: bool,
    /// Projected-gravity z the robot must already be past before a fall prediction counts
    /// — about 26° of tilt, which ordinary walking does not reach.
    pub limp_fall_tilt_z: f64,
    /// Where the extrapolation must reach to count as falling. Same sense as
    /// `fall_gravity_z`, and by default the same number.
    pub limp_fall_predict_z: f64,
    /// How far ahead the tilt rate is extrapolated.
    pub limp_fall_lookahead_ms: u64,
    /// How long the fall verdict must hold before the gains drop. Three ticks at 50 Hz —
    /// longer than a footfall impulse, short enough to leave most of the fall to limp
    /// through.
    pub limp_fall_debounce_ms: u64,
    /// Angular-rate magnitude below which the robot counts as having landed, rad/s.
    pub limp_fall_still_rate: f64,
    /// How long it has to stay that still before the limp ends.
    pub limp_fall_still_ms: u64,
    /// Hard cap on the limp, however the landing reads. A robot that never goes still —
    /// held in someone's hands, or resting against something that keeps nudging it —
    /// must not stay limp forever.
    pub limp_fall_max_ms: u64,
    /// How long the ramp back to the standing pose takes, once the robot has landed.
    /// 0.6 s — settled on at the robot. The joints travel across the floor unloaded rather
    /// than lifting anything, so a full second was mostly dead time before the stand-up;
    /// 0.6 keeps some margin over the 0.3 that also worked.
    pub limp_fall_pose_ms: u64,
    /// Gain for that ramp. The joints have to actually travel across the floor, so it is
    /// not the limp gain; it is the softened standing gain rather than the walking one.
    pub limp_fall_pose_gain: u16,
    /// Once posed, hand the robot back to the standing policy (the default — the alpha
    /// standing network stands up from the floor). Off, the policy is disabled instead and
    /// the robot holds the pose until someone enables it again: for a policy that was never
    /// trained on a fallen robot, such as one from a walking-only task that ends every
    /// episode at the first fall. Handed a robot lying on the floor, the HL-2915 walking
    /// policy drove its joints into their stops and thrashed there.
    pub limp_fall_hand_back: bool,
    /// Experimental: while a policy drives, hold neck pitch, head pitch, head yaw and head
    /// roll within this many degrees of the home pose. 0 (the default) is off. For finding
    /// out how much a policy leans on its head to balance: the HL-2915 walking policy, its
    /// legs lagging, threw the head forward and down (neck from +14° to -80°), which put
    /// the centre of mass 20 mm further forward than the head held still would have. It
    /// also clamps commanded head poses, so leave it off outside such a test.
    pub head_band_deg: f64,
}

impl Default for PolicyParams {
    fn default() -> Self {
        Self {
            enabled: true,
            mode: Mode::Walk,
            walk: None,
            stand: None,
            sitstand: None,
            ground_pick: None,
            kick_left: None,
            kick_right: None,
            roulade: None,
            lie: None,
            action_scale: None,
            standing_action_scale: 1.0,
            // The prototype's `--standing-kp-ratio`.
            standing_gain_ratio: 0.8,
            gain: 200,
            head_lowpass: None,
            head_deadband: None,
            legs_lowpass: None,
            walk_settle_s: None,
            walk_stands: false,
            ground_pick_period: None,
            ground_pick_action_scale: None,
            ground_pick_gain_ratio: 1.0,
            kick_duration: 0.5,
            roulade_duration: 1.0,
            roulade_action_scale: 1.0,
            roulade_gain_ratio: 1.0,
            voltage_adapt: false,
            nominal_voltage: 7.4,
        }
    }
}

impl Default for SafetyParams {
    fn default() -> Self {
        Self {
            fall_gravity_z: -0.5,
            fall_debounce_ms: 200,
            deadman_ms: 500,
            gain_limp: 50,
            battery_empty_shutdown: true,
            limp_fall: true,
            limp_fall_tilt_z: -0.90,
            limp_fall_predict_z: -0.5,
            limp_fall_lookahead_ms: 300,
            limp_fall_debounce_ms: 60,
            limp_fall_still_rate: 1.0,
            limp_fall_still_ms: 200,
            limp_fall_max_ms: 1500,
            limp_fall_pose_ms: 600,
            limp_fall_pose_gain: 160,
            limp_fall_hand_back: true,
            head_band_deg: 0.0,
        }
    }
}

#[derive(Debug, Clone, Serialize, Deserialize)]
#[serde(deny_unknown_fields, default)]
pub struct Bus {
    /// Serial port of the servo bus. On the Orange Pi Zero 3W (A733) with the Robot HAT E1 it is
    /// UART0 (header pins 8/10), `/dev/ttyS0`.
    pub port: String,
    /// Which servos are on it. The original alpha runs Dynamixel XL330s; this robot runs
    /// Feetech HL-2915s, which speak a different protocol at a different rate (500 kbit/s —
    /// the A733's UART cannot make 1 Mbit/s) and need the mapping below.
    pub servo: ServoKind,
    /// Feetech only: the bus ID of the servo at each joint, in `JOINT_NAMES` order (left leg,
    /// neck/head/mouth, right leg). Empty until the robot has been mapped; the bus refuses to
    /// open without it, rather than guess which servo is which joint.
    pub joint_ids: Vec<u8>,
    /// Feetech only: +1 or −1 per joint — −1 where a positive encoder step is a negative joint
    /// angle. Empty means all +1.
    pub joint_signs: Vec<i8>,
    /// Feetech only: encoder counts (4096 per turn) from the servo's centre, 2048, to the
    /// joint's zero. Empty means all 0.
    pub joint_offsets: Vec<i16>,
    /// Feetech only: whether the IMU board answers on the bus. Off for bring-up before its
    /// firmware exists — the loop then reads the servos alone and reports orientation as not
    /// ready, so nothing that needs it will run.
    pub imu: bool,
    /// Feetech only: where the IMU is. `bus` is the PDB/IMU board, ID 200 on the servo bus;
    /// `bno055` is a BNO055 on I²C (the Robot HAT E1 build, which has no PDB), at
    /// [`Self::imu_i2c`] / [`Self::imu_i2c_address`].
    pub imu_source: ImuSource,
    /// Feetech, `imu_source = "bno055"`: the i2c-dev node. `/dev/i2c-0` is TWI0 on the Orange Pi
    /// Zero 3W (header pins 3/5), the Robot HAT E1's Qwiic J5.
    pub imu_i2c: String,
    /// Feetech, `imu_source = "bno055"`: the chip's 7-bit address — 40 (0x28) on the Adafruit
    /// breakout, 41 (0x29) with its ADR pin high.
    pub imu_i2c_address: u8,
    /// Feetech only: how the IMU chip sits in the trunk, as the sensor axis behind each trunk
    /// axis (x forward, y left, z up): `"z,y,-x"` means trunk x = sensor z, y = sensor y,
    /// z = −sensor x, which is the original board. Found by laying the robot on its back and
    /// standing it up and seeing which sensor axis carries gravity.
    pub imu_axes: String,
    /// Feetech only: degrees added to the reported trunk pitch (positive reads more nose-down),
    /// for a board that sits off its nominal mounting. The policies cannot learn a systematic
    /// offset — their IMU randomization is zero-centred — so it is corrected here. On the
    /// HL-2915 robot (2026-10-09), standing under the policy, the IMU read 1.6–4.5° (mean
    /// 3.3°) further back than the model at the same joint angles; whether that is the board
    /// or the joint zeros is for a level on the trunk to settle before this is set.
    pub imu_pitch_trim_deg: f64,
    /// Feetech only: degrees added to the reported trunk roll (positive reads gravity further
    /// along trunk −y), for a board sitting rolled on its mounting. On 2026-10-11 the refitted
    /// board read ~2° of roll on a robot standing with level legs, and the walk turned and
    /// shuffled until it was taken out.
    pub imu_roll_trim_deg: f64,
    /// Feetech only: median of three ticks on the IMU's gyro and gravity. It rejects a single
    /// bad block but delays the reading by about a tick; the walking policies were trained
    /// with 0–20 ms of IMU lag and, in the BAM simulation, rock and flail the neck past it as
    /// the HL-2915 robot did (2026-10-10). On by default until the robot confirms it.
    pub imu_median: bool,
    /// Feetech only: the servos' live position Kp (register 50) at the policies' running gain;
    /// standing and limp scale from it. The factory value is 32 — roughly fifteen times as
    /// stiff as the servos the policies were trained on, which makes the walking policy kick
    /// itself over. 8 was measured to sit near the trained stiffness.
    pub position_kp: u8,
    /// Feetech only: the same, for the neck, head and mouth. Stiffer than the legs because the
    /// neck holds the head up: at the legs' 6 it sagged 15° off the home pose.
    pub position_kp_head: u8,
    /// Feetech only: the servos' live position Kd (register 51), set at bring-up.
    pub position_kd: u8,
    /// Feetech only: the current each servo may draw, mA. Written to the servos at every
    /// startup, since they forget it at every power cycle. The default is the servos' own
    /// power-up value.
    pub current_limit_ma: f64,
    /// Feetech only: whether the mouth servo holds. Off leaves it out of torque-enable and of
    /// every goal write, so it stays limp while the rest hold. For testing the legs while the
    /// mouth runs hot holding its pose (2026-10-12: 37 → 66 °C in ten minutes).
    pub mouth_torque: bool,
    /// With `mouth_torque = false`: power the mouth only while it has something to say — a
    /// sound playing (lip sync) or an open-mouth intent — and let it go limp again 0.3 s after.
    /// Closed and idle the beak holds nothing, so it does not heat (2026-10-14).
    pub mouth_wake: bool,
}

/// Where the robot's IMU is.
#[derive(Debug, Clone, Copy, Default, PartialEq, Eq, Serialize, Deserialize)]
#[serde(rename_all = "snake_case")]
pub enum ImuSource {
    /// The PDB/IMU board on the servo bus.
    Bus,
    /// A BNO055 on I²C (the Robot HAT E1 build).
    #[default]
    Bno055,
}

impl ImuSource {
    pub fn as_str(self) -> &'static str {
        match self {
            ImuSource::Bus => "bus",
            ImuSource::Bno055 => "bno055",
        }
    }
}

/// The servo family on the bus.
#[derive(Debug, Clone, Copy, Default, PartialEq, Eq, Serialize, Deserialize)]
#[serde(rename_all = "snake_case")]
pub enum ServoKind {
    DynamixelXl330,
    #[default]
    FeetechHls,
}

impl ServoKind {
    pub fn as_str(self) -> &'static str {
        match self {
            ServoKind::DynamixelXl330 => "dynamixel_xl330",
            ServoKind::FeetechHls => "feetech_hls",
        }
    }
}

#[derive(Debug, Clone, Serialize, Deserialize)]
#[serde(deny_unknown_fields, default)]
pub struct Control {
    /// Control loop rate. 50 Hz is inherited from the prototype, where it was chosen on a
    /// Pi Zero 2W — re-derive it on the Radxa rather than trusting it.
    pub hz: u32,
    /// Per-tick EMA on the velocity command: `cmd += α × (target − cmd)`. The prototype's
    /// `--cmd-alpha` — what turns a stick snap into a ramp the gait can follow. `1.0` is
    /// pass-through.
    pub cmd_alpha: f64,
    /// Same, for head targets and the body pose.
    pub head_alpha: f64,
    /// Heading hold (`duck_control::heading`): while a client asks to translate without
    /// turning, the yaw rate commanded per radian the robot has turned off the heading the
    /// straight segment started on, 1/s. `0` (the default) turns it off. The walking policies
    /// track a yaw rate, not a heading: on the HL-2915 robot (2026-10-10) a straight 8 s walk
    /// ended anywhere from −11° to +137° off.
    pub heading_hold_gain: f64,
    /// The largest yaw rate the heading hold asks for, rad/s.
    pub heading_hold_max: f64,
    /// Time constant of the heading low-pass the hold acts on, s (0 = none). The trunk yaws
    /// with every step (3.5–8.6° on the robot's straight walks); on 2026-10-11 a hold acting on
    /// the raw heading at gain 1 chased that wobble into ±30° swings and a fall.
    pub heading_hold_tau_s: f64,
    /// Heading error the hold leaves alone, degrees.
    pub heading_hold_deadband_deg: f64,
}

/// Thresholds that decide `healthy` — and therefore whether an update is kept.
///
/// **Not** the thresholds for everything `robot.health` reports. That answer also describes the
/// battery, the motor temperatures and the loop counters, and none of those may reach a verdict
/// (`docs/design/robotd-design.md` §3.4) — so none of them has a setting here. Naming this section
/// `[health]` invited exactly that mistake: it reads like "how the robot is doing", when what it
/// configures is the one question auto-rollback turns on.
///
/// Everything here is a property of the *software*. A future `[thermal]` section for a motor
/// temperature that should throttle the robot would be a different thing, and belongs under a
/// different name.
///
/// The section was called `[health]`. Renamed outright rather than aliased: a board carrying
/// the old name gets a parse error naming the section, which is a better outcome than a robot
/// quietly running on default thresholds nobody chose.
#[derive(Debug, Clone, Serialize, Deserialize)]
#[serde(deny_unknown_fields, default)]
pub struct UpdateGate {
    /// Below this achieved rate the robot reports unhealthy, which is what makes the
    /// updater's auto-rollback mean something. A loop running at 60% of target is alive,
    /// answers every request, and is badly broken.
    pub min_achieved_hz: f64,
    /// How many periods may pass with no tick before the loop counts as **wedged**.
    ///
    /// This detects a dead loop, not a slow one — `min_achieved_hz` owns degradation. Keep
    /// the two apart: set this near the period and it fires on ordinary scheduler jitter,
    /// which on a loaded board would report a perfectly good release unhealthy and roll it
    /// back. A loop that has not ticked in half a second is genuinely gone; one that
    /// ticked 80 ms late is just late.
    pub stall_periods: u32,
    /// Consecutive bus read failures tolerated before reporting unhealthy. One dropped
    /// transaction is ordinary; a run of them means the bus is gone.
    pub max_consecutive_errors: u32,
}

impl Default for Bus {
    fn default() -> Self {
        Self {
            port: "/dev/ttyS0".into(),
            servo: ServoKind::default(),
            joint_ids: Vec::new(),
            joint_signs: Vec::new(),
            joint_offsets: Vec::new(),
            imu: true,
            imu_source: ImuSource::default(),
            imu_i2c: "/dev/i2c-0".into(),
            imu_i2c_address: 0x28,
            imu_axes: "z,y,-x".into(),
            imu_pitch_trim_deg: 0.0,
            imu_roll_trim_deg: 0.0,
            imu_median: true,
            position_kp: 8,
            position_kp_head: 16,
            position_kd: 8,
            current_limit_ma: 2925.0,
            mouth_torque: true,
            mouth_wake: false,
        }
    }
}

impl Default for Control {
    fn default() -> Self {
        Self {
            hz: 50,
            cmd_alpha: 0.2,
            head_alpha: 0.2,
            heading_hold_gain: 0.0,
            heading_hold_max: 0.3,
            heading_hold_tau_s: 0.5,
            heading_hold_deadband_deg: 5.0,
        }
    }
}

impl Default for UpdateGate {
    fn default() -> Self {
        Self {
            // 90% of the default rate. Generous enough not to trip on a slow tick, tight
            // enough that a loop losing every tenth cycle is not called healthy.
            min_achieved_hz: 45.0,
            // 500 ms at the default rate. Deliberately far from the period: three periods
            // is 60 ms, which ordinary scheduler jitter exceeds on a busy machine, and a
            // health check that trips on jitter rolls back good releases.
            stall_periods: 25,
            max_consecutive_errors: 10,
        }
    }
}

#[derive(Debug, thiserror::Error)]
pub enum ParamsError {
    #[error("reading {path}: {source}")]
    Read {
        path: String,
        #[source]
        source: std::io::Error,
    },
    #[error("parsing {path}: {source}")]
    Parse {
        path: String,
        #[source]
        source: toml::de::Error,
    },
    #[error("{path}: control.hz must be between 1 and 1000, got {got}")]
    Rate { path: String, got: u32 },
    #[error(
        "{path}: battery.cells takes 2 and/or 3 (the packs robotd can tell apart), got {got:?}"
    )]
    BatteryCells { path: String, got: Vec<u8> },
    #[error(
        "{path}: media.bitrate must be between {min} and {max} bits per second, got {got} — \
         the unit is bits, so 2 Mb/s is 2000000"
    )]
    Bitrate {
        path: String,
        got: u32,
        min: u32,
        max: u32,
    },
}

/// The band `media.bitrate` is accepted in, bits per second.
///
/// The floor is not taste: it is where a typo lands. `bitrate = 2000` is somebody who meant
/// kilobits, and 2 kb/s is a stream that never produces a picture — far better refused at the
/// editor than debugged off a board. The ceiling is what the link and the VPU are for; above it
/// the encoder is being asked for something no robot's wifi will carry.
pub const BITRATE_MIN: u32 = 100_000;
pub const BITRATE_MAX: u32 = 20_000_000;

impl Params {
    /// Load from `path`. A missing file at the *default* location is not an error — an
    /// unprovisioned board should still come up on defaults rather than refuse to start,
    /// and a daemon that will not start is much harder to diagnose remotely than one
    /// running on known defaults. A file explicitly named on the command line must exist.
    pub fn load(path: &Path, explicit: bool) -> Result<Self, ParamsError> {
        let text = match std::fs::read_to_string(path) {
            Ok(text) => text,
            Err(e) if e.kind() == std::io::ErrorKind::NotFound && !explicit => {
                tracing::warn!(path = %path.display(), "no params file; using defaults");
                return Ok(Self::default());
            }
            Err(source) => {
                return Err(ParamsError::Read {
                    path: path.display().to_string(),
                    source,
                });
            }
        };

        // Strict first. A file this build fully understands parses exactly as it always has —
        // one pass, serde's own spans, no second guess — and that is the overwhelmingly common
        // case. The lenient path below only ever runs on a file that has already failed.
        let params = match toml::from_str::<Params>(&text) {
            Ok(params) => params,
            // Not an unknown-key problem: a syntax error, or a value of the wrong type. The
            // strict error is what gets reported, because it is the one carrying a line and a
            // column.
            Err(source) => {
                let Some((reparsed, ignored)) = without_unknown_keys(&text) else {
                    return Err(ParamsError::Parse {
                        path: path.display().to_string(),
                        source,
                    });
                };
                tracing::warn!(
                    path = %path.display(),
                    ignored = %ignored.join(", "),
                    "this build has no such keys; they are ignored and their values do nothing"
                );
                // Pruned, and what is left still does not parse — a real error sharing a file
                // with an inert one. This reports the real one, which costs the position: serde
                // is now looking at a table rather than at the text. The alternative was worse.
                // Returning the strict error here would name the key this release just declared
                // harmless as the reason the daemon will not start, and send whoever reads it to
                // delete a section that was never the problem.
                reparsed.map_err(|source| ParamsError::Parse {
                    path: path.display().to_string(),
                    source,
                })?
            }
        };
        params.validate(path)?;
        Ok(params)
    }

    /// Reject values that would produce a loop that cannot work, at startup rather than as
    /// a division by zero three seconds later.
    fn validate(&self, path: &Path) -> Result<(), ParamsError> {
        if self.control.hz == 0 || self.control.hz > 1000 {
            return Err(ParamsError::Rate {
                path: path.display().to_string(),
                got: self.control.hz,
            });
        }
        if self.battery.cells.is_empty() || self.battery.cells.iter().any(|c| !(2..=3).contains(c))
        {
            return Err(ParamsError::BatteryCells {
                path: path.display().to_string(),
                got: self.battery.cells.clone(),
            });
        }
        // Checked here rather than in `mediad`, so `robotctl configure` refuses to write it:
        // the daemon that would choke on this one is not the daemon whose gate the editor runs.
        if let Some(bitrate) = self.media.bitrate
            && !(BITRATE_MIN..=BITRATE_MAX).contains(&bitrate)
        {
            return Err(ParamsError::Bitrate {
                path: path.display().to_string(),
                got: bitrate,
                min: BITRATE_MIN,
                max: BITRATE_MAX,
            });
        }
        Ok(())
    }

    pub fn period(&self) -> std::time::Duration {
        std::time::Duration::from_secs_f64(1.0 / self.control.hz as f64)
    }
}

/// Re-parse a file that `deny_unknown_fields` rejected, dropping the keys this build has no
/// place for, and say which they were. `None` when nothing was dropped — the parse failed for
/// some other reason and the caller should report that instead.
///
/// **Why unknown keys are no longer fatal.** They were, and the reasoning was sound as far as it
/// went: a silently ignored `min_acheived_hz` leaves an operator believing they moved a threshold
/// they did not. What that argument missed is the other way a key becomes unknown — the build
/// changed underneath a file nobody typed into. A robot running a branch had `[chorale]` in its
/// `robotd.toml`; updating it to a `main` without that feature produced a `robotd` that would not
/// start, four consecutive rollbacks, and a bench session spent on a robot that was fine. The
/// section was inert. Refusing to run over it is a far larger penalty than the mistake it guards
/// against, and it lands on exactly the transitions — a downgrade, a branch, a release that
/// dropped a feature — where the operator did nothing wrong at all.
///
/// So the value is kept and the enforcement moved: every dropped key is named at `warn`, and
/// `robotctl configure` writes only keys the registry knows. What is gone is a robot that will
/// not walk because of a line in a config file that does nothing.
///
/// **The registry is the authority on what a key is**, not serde. It has to be: serde's answer
/// arrives as prose inside an error, and this needs the question asked per key. That is safe
/// because it is not a second copy of the schema —
/// [`registry::tests::the_registry_covers_every_key_exactly`] pins it to [`Params`] in both
/// directions, so a key the registry does not know is a key `Params` does not have.
///
/// `deny_unknown_fields` stays on the structs. It is what makes that test possible, and it is
/// the backstop here: if the registry ever did drift, the pruned table would still be rejected
/// rather than quietly deserialised into something else.
#[allow(clippy::type_complexity)]
fn without_unknown_keys(text: &str) -> Option<(Result<Params, toml::de::Error>, Vec<String>)> {
    let mut table: toml::Table = text.parse().ok()?;
    let mut ignored: Vec<String> = Vec::new();

    table.retain(|section, value| {
        let Some(fields) = value.as_table_mut() else {
            // A bare value at the top level — `hz = 50` written outside any section, which is
            // the shape a hand-edit takes when someone forgets the header. No registry key can
            // name it, and reporting it by its bare name is what tells them why.
            ignored.push(section.to_string());
            return false;
        };
        if !registry::has_section(section) {
            // Reported as the section rather than as each of its keys: `[chorale]` is one
            // decision someone made, not four mistakes.
            ignored.push(format!("[{section}]"));
            return false;
        }
        fields.retain(|key, _| {
            if registry::entry_for(&format!("{section}.{key}")).is_some() {
                true
            } else {
                ignored.push(format!("{section}.{key}"));
                false
            }
        });
        true
    });

    if ignored.is_empty() {
        // Nothing here was an unknown key, so the strict parse failed for a reason this cannot
        // help with. `None` says exactly that, and keeps the caller's two cases apart.
        return None;
    }
    ignored.sort();
    Some((toml::Value::Table(table).try_into::<Params>(), ignored))
}

#[cfg(test)]
mod tests {
    use super::*;

    fn write(dir: &std::path::Path, body: &str) -> std::path::PathBuf {
        let path = dir.join("robotd.toml");
        std::fs::write(&path, body).unwrap();
        path
    }

    /// The capture device is derived from the playback one, and the derivation must be
    /// idempotent: an operator who writes the full ALSA spec gets the device they wrote,
    /// not one with a second subdevice glued on that no card answers to.
    #[test]
    fn the_capture_device_does_not_double_its_subdevice() {
        let plain = AudioParams {
            device: "plughw:aic3104".to_owned(),
            ..AudioParams::default()
        };
        assert_eq!(plain.capture_device(), "plughw:aic3104,0");

        let spelled_out = AudioParams {
            device: "plughw:aic3104,0".to_owned(),
            ..AudioParams::default()
        };
        assert_eq!(spelled_out.capture_device(), "plughw:aic3104,0");
    }

    /// An unprovisioned board must still come up. A daemon that refuses to start because a
    /// config file is absent is far harder to diagnose on a robot than one running on
    /// documented defaults.
    #[test]
    fn a_missing_default_file_falls_back_to_defaults() {
        let dir = tempfile::tempdir().unwrap();
        let p = Params::load(&dir.path().join("absent.toml"), false).unwrap();
        assert_eq!(p.control.hz, 50);
    }

    /// But a file named explicitly on the command line must exist — silently ignoring
    /// `--params /path/typo.toml` would run the robot on settings nobody chose.
    #[test]
    fn an_explicitly_named_missing_file_is_an_error() {
        let dir = tempfile::tempdir().unwrap();
        assert!(Params::load(&dir.path().join("absent.toml"), true).is_err());
    }

    /// A file that has not said which pack takes either; an HD-1910 robot says 2S and its
    /// servos' 8.4 V; a cell count robotd cannot tell apart is refused at load.
    #[test]
    fn the_battery_section() {
        let d = Params::default().battery;
        assert_eq!((d.cells, d.max_volts), (vec![2, 3], 0.0));
        let dir = tempfile::tempdir().unwrap();
        let path = write(
            dir.path(),
            "[battery]
cells = [2]
max_volts = 8.4
",
        );
        let p = Params::load(&path, true).unwrap();
        assert_eq!((p.battery.cells, p.battery.max_volts), (vec![2], 8.4));
        let bad = write(
            dir.path(),
            "[battery]
cells = [4]
",
        );
        assert!(matches!(
            Params::load(&bad, true),
            Err(ParamsError::BatteryCells { .. })
        ));
    }

    /// Partial files are the normal case — a board overrides the port and nothing else.
    #[test]
    fn absent_sections_take_their_defaults() {
        let dir = tempfile::tempdir().unwrap();
        let path = write(dir.path(), "[bus]\nport = \"/dev/ttyUSB0\"\n");
        let p = Params::load(&path, true).unwrap();
        assert_eq!(p.bus.port, "/dev/ttyUSB0");
        assert_eq!(p.control.hz, 50);
        assert_eq!(p.update_gate.stall_periods, 25);
    }

    /// [`QUALITY_LABELS`] is what the registry offers and what the file may contain, and
    /// [`Quality::ALL`] is what the daemon can do — a rung in one and not the other is either a
    /// choice the editor writes and `mediad` cannot read, or a mode nobody can select.
    #[test]
    fn the_head_band_is_off_unless_set() {
        assert_eq!(Params::default().safety.head_band_deg, 0.0);
        let parsed: Params = toml::from_str(
            "[safety]
head_band_deg = 15.0
",
        )
        .expect("parses");
        assert_eq!(parsed.safety.head_band_deg, 15.0);
    }

    #[test]
    fn the_fall_hand_back_is_on_unless_turned_off() {
        assert!(
            Params::default().safety.limp_fall_hand_back,
            "the alpha standing policy gets up"
        );
        let parsed: Params = toml::from_str(
            "[safety]
limp_fall_hand_back = false
",
        )
        .expect("parses");
        assert!(!parsed.safety.limp_fall_hand_back);
        assert!(
            parsed.safety.limp_fall,
            "turning off the hand-back keeps the limp"
        );
    }

    #[test]
    fn every_quality_label_round_trips() {
        assert_eq!(QUALITY_LABELS.len(), Quality::ALL.len());
        for (label, quality) in QUALITY_LABELS.iter().zip(Quality::ALL) {
            assert_eq!(*label, quality.label());
            let parsed: Params =
                toml::from_str(&format!("[media]\nquality = \"{label}\"\n")).expect("parses");
            assert_eq!(parsed.media.quality, quality);
        }
    }

    /// The labels are `webrtcsink`'s own property nicknames — the strings that get set on the
    /// element. `gcc`, not `googcc`: a nickname this file spelled its own way would be a config
    /// key that parses, validates, saves, and then silently leaves the element on its default.
    #[test]
    fn every_congestion_label_round_trips() {
        assert_eq!(CONGESTION_LABELS.len(), CongestionControl::ALL.len());
        for (label, mode) in CONGESTION_LABELS.iter().zip(CongestionControl::ALL) {
            assert_eq!(*label, mode.nick());
            let parsed: Params =
                toml::from_str(&format!("[media]\ncongestion_control = \"{label}\"\n"))
                    .expect("parses");
            assert_eq!(parsed.media.congestion_control, mode);
        }
        // `gcc` is webrtcsink's own default, so a robot with no key set must land there — naming
        // it must not change what every robot has been running.
        assert_eq!(
            MediaParams::default().congestion_control,
            CongestionControl::Gcc
        );
    }

    /// The starting bitrate follows the picture unless somebody says otherwise — the whole
    /// reason `bitrate` is optional rather than a number to keep in step by hand.
    #[test]
    fn an_unset_bitrate_follows_the_quality() {
        let mut media = MediaParams::default();
        for quality in Quality::ALL {
            media.quality = quality;
            assert_eq!(media.bitrate_resolved(), quality.default_bitrate());
        }
        media.bitrate = Some(3_000_000);
        assert_eq!(media.bitrate_resolved(), 3_000_000);
    }

    /// A bitrate in the wrong unit is the mistake this band exists to catch: `2000` is somebody
    /// who meant kilobits, and it would produce a stream with no picture in it.
    #[test]
    fn a_bitrate_in_kilobits_is_refused() {
        let dir = tempfile::tempdir().unwrap();
        let path = write(dir.path(), "[media]\nbitrate = 2000\n");
        assert!(Params::load(&path, true).is_err());
        let path = write(dir.path(), "[media]\nbitrate = 2000000\n");
        assert_eq!(
            Params::load(&path, true).unwrap().media.bitrate_resolved(),
            2_000_000
        );
    }

    /// Today's shipped behaviour, pinned: a robot with no `[media]` section streams its camera
    /// at exactly what `mediad`'s flags used to default to. This section changed where those
    /// numbers live and must not have changed the numbers.
    #[test]
    fn the_defaults_are_what_mediad_streamed_before_the_section_existed() {
        let media = Params::default().media;
        assert!(media.camera, "mediad.service carried --camera");
        assert_eq!(media.quality.size(), (1280, 720));
        assert_eq!(media.quality.fps(), 30);
        assert_eq!(media.bitrate_resolved(), 2_000_000);
    }

    /// The Robot HAT E1 robot's file parses, and says what that build needs: no PDB, so the
    /// IMU is the BNO055 on Qwiic J5, and the servos are on UART0.
    #[test]
    fn the_robot_hat_e1_config_parses() {
        let file = include_str!("../../deploy/robots/opi-hl2915-robothat-e1.toml");
        let p: Params = toml::from_str(file).expect("opi-hl2915-robothat-e1.toml must parse");
        assert_eq!(p.bus.port, "/dev/ttyS0");
        assert_eq!(p.bus.imu_source, ImuSource::Bno055);
        assert_eq!(p.bus.imu_i2c, "/dev/i2c-0");
        assert_eq!(p.bus.imu_i2c_address, 0x28);
    }

    /// The shipped example must agree with the built-in defaults, or the file documents a
    /// robot that does not exist — and an operator reading it would draw wrong conclusions
    /// about what their board is actually doing.
    #[test]
    fn the_shipped_example_matches_the_defaults() {
        let shipped = include_str!("../../deploy/robotd.toml");
        let from_file: Params = toml::from_str(shipped).expect("deploy/robotd.toml must parse");
        let built_in = Params::default();

        assert_eq!(from_file.bus.port, built_in.bus.port);
        assert_eq!(from_file.bus.servo, built_in.bus.servo);
        assert_eq!(from_file.bus.joint_ids, built_in.bus.joint_ids);
        assert_eq!(from_file.bus.imu, built_in.bus.imu);
        assert_eq!(from_file.bus.imu_source, built_in.bus.imu_source);
        assert_eq!(from_file.bus.imu_i2c, built_in.bus.imu_i2c);
        assert_eq!(from_file.bus.imu_i2c_address, built_in.bus.imu_i2c_address);
        assert_eq!(from_file.bus.imu_axes, built_in.bus.imu_axes);
        assert_eq!(from_file.bus.position_kp, built_in.bus.position_kp);
        assert_eq!(
            from_file.bus.position_kp_head,
            built_in.bus.position_kp_head
        );
        assert_eq!(from_file.bus.position_kd, built_in.bus.position_kd);
        assert_eq!(
            from_file.bus.current_limit_ma,
            built_in.bus.current_limit_ma
        );
        assert_eq!(from_file.bus.mouth_torque, built_in.bus.mouth_torque);
        assert_eq!(from_file.control.hz, built_in.control.hz);
        assert_eq!(from_file.control.cmd_alpha, built_in.control.cmd_alpha);
        assert_eq!(from_file.control.head_alpha, built_in.control.head_alpha);
        assert_eq!(from_file.policy.resolved(), built_in.policy.resolved());
        assert_eq!(from_file.safety.limp_fall, built_in.safety.limp_fall);
        assert_eq!(
            from_file.safety.battery_empty_shutdown,
            built_in.safety.battery_empty_shutdown
        );
        assert_eq!(
            from_file.update_gate.min_achieved_hz,
            built_in.update_gate.min_achieved_hz
        );
        assert_eq!(
            from_file.update_gate.stall_periods,
            built_in.update_gate.stall_periods
        );
        assert_eq!(
            from_file.update_gate.max_consecutive_errors,
            built_in.update_gate.max_consecutive_errors
        );
        assert_eq!(from_file.media.camera, built_in.media.camera);
        assert_eq!(from_file.media.quality, built_in.media.quality);
        assert_eq!(
            from_file.media.bitrate_resolved(),
            built_in.media.bitrate_resolved()
        );
        assert_eq!(
            from_file.media.congestion_control,
            built_in.media.congestion_control
        );
    }

    /// The resolved walk-mode defaults are the prototype's **current alpha configuration**
    /// — the values `microduck_runtime` ships as built-in defaults, which its installer
    /// deliberately passes no flags to override. Changing any of these silently changes how
    /// the robot moves relative to the thing this daemon replaces.
    #[test]
    fn walk_mode_resolves_to_the_prototype_alpha_config() {
        let p = Params::default().policy.resolved();
        assert_eq!(p.mode, Mode::Walk);
        assert_eq!(p.action_scale, 0.9);
        assert_eq!(p.standing_action_scale, 1.0);
        assert_eq!(p.standing_gain_ratio, 0.8, "--standing-kp-ratio");
        assert_eq!(p.gain, 200);
        assert_eq!(
            p.head_lowpass,
            Some(0.5),
            "trained with the filter ON at 0.5"
        );
        assert_eq!(
            p.legs_lowpass,
            Some(0.7),
            "trained with the filter ON at 0.7"
        );
        assert_eq!(p.ground_pick_period, 4.0);
        assert_eq!(p.ground_pick_action_scale, 1.0);
        assert_eq!(p.ground_pick_gain_ratio, 1.0);
        assert_eq!(p.kick_duration, 0.5);
        assert_eq!(p.roulade_duration, 1.0, "one roll, the measured time");
        assert_eq!(p.roulade_action_scale, 1.0);
        assert_eq!(p.roulade_gain_ratio, 1.0);
        assert!(!p.voltage_adapt, "off by default in the prototype");
        assert_eq!(p.nominal_voltage, 7.4);

        let name = |p: &Option<std::path::PathBuf>| {
            p.as_ref()
                .and_then(|p| p.file_name())
                .map(|n| n.to_string_lossy().into_owned())
        };
        assert!(p.walk.ends_with("policies/alpha_walking.onnx"));
        assert_eq!(name(&p.stand).as_deref(), Some("alpha_stand.onnx"));
        assert_eq!(name(&p.sitstand).as_deref(), Some("alpha_sitstand.onnx"));
        assert_eq!(
            name(&p.ground_pick).as_deref(),
            Some("alpha_ground_pick.onnx")
        );
        assert_eq!(name(&p.kick_left).as_deref(), Some("ball_kick_left.onnx"));
        assert_eq!(name(&p.kick_right).as_deref(), Some("ball_kick_right.onnx"));
        assert_eq!(name(&p.roulade).as_deref(), Some("roulade.onnx"));
    }

    /// Command smoothing matches the prototype's `--cmd-alpha` / `--head-alpha`.
    #[test]
    fn command_smoothing_defaults_match_the_prototype() {
        let c = Control::default();
        assert_eq!(c.cmd_alpha, 0.2);
        assert_eq!(c.head_alpha, 0.2);
    }

    /// The thermal guard warns and stops walking by default, short of the servos' own
    /// shutdown; sitting down is opt-in.
    #[test]
    fn the_thermal_guard_defaults() {
        let t = Thermal::default();
        assert_eq!(
            (t.warn_c, t.walk_max_c, t.sit_c, t.hysteresis_c),
            (55.0, 65.0, 0.0, 5.0)
        );
    }

    /// Heading hold is opt-in: a robot whose file does not ask for it steers exactly as before.
    #[test]
    fn heading_hold_is_off_by_default() {
        let c = Control::default();
        assert_eq!(c.heading_hold_gain, 0.0);
        assert_eq!(c.heading_hold_max, 0.3);
        assert_eq!(c.heading_hold_tau_s, 0.5);
        assert_eq!(c.heading_hold_deadband_deg, 5.0);
    }

    /// One line — `mode = "roller"` — must reproduce the prototype's whole roller preset,
    /// which its installer rebased on the alpha defaults: the roller policy and its tuning
    /// (kp 200, scale 0.8, the crouch on the ground-pick trigger at 3 s / 0.8), and
    /// everything else exactly as walking mode has it — sit/stand, kicks, roulade, the
    /// trained low-pass. Only the standing network stays out (the prototype loads it and
    /// then skips every standing transition in roller mode, so it never runs).
    #[test]
    fn roller_mode_resolves_to_the_prototype_roller_preset() {
        let dir = tempfile::tempdir().unwrap();
        let path = write(dir.path(), "[policy]\nmode = \"roller\"\n");
        let p = Params::load(&path, true).unwrap().policy.resolved();

        assert_eq!(p.mode, Mode::Roller);
        assert!(p.walk.ends_with("policies/roller.onnx"));
        assert_eq!(
            p.stand, None,
            "the prototype never runs standing in roller mode"
        );
        assert!(
            p.sitstand
                .as_ref()
                .unwrap()
                .ends_with("alpha_sitstand.onnx"),
            "the rebased roller line keeps the sit"
        );
        assert!(
            p.kick_left
                .as_ref()
                .unwrap()
                .ends_with("ball_kick_left.onnx")
        );
        assert!(
            p.kick_right
                .as_ref()
                .unwrap()
                .ends_with("ball_kick_right.onnx")
        );
        assert!(p.roulade.as_ref().unwrap().ends_with("roulade.onnx"));
        assert!(
            p.ground_pick
                .as_ref()
                .unwrap()
                .ends_with("roller_crouch.onnx")
        );
        assert_eq!(p.action_scale, 0.8);
        assert_eq!(p.ground_pick_period, 3.0);
        assert_eq!(p.ground_pick_action_scale, 0.8);
        assert_eq!(
            p.head_lowpass,
            Some(0.5),
            "the rebased roller line keeps the trained filters"
        );
        assert_eq!(p.legs_lowpass, Some(0.7));
        assert_eq!(p.gain, 200);
    }

    /// `"none"` disables an optional slot outright — the prototype's `--sitstand-policy None`
    /// convention — and `1.0` turns a low-pass into a pass-through, which is how its preset
    /// spells "off".
    #[test]
    fn none_and_unity_are_the_off_switches() {
        let dir = tempfile::tempdir().unwrap();
        let path = write(
            dir.path(),
            "[policy]\nsitstand = \"None\"\nhead_lowpass = 1.0\n",
        );
        let p = Params::load(&path, true).unwrap().policy.resolved();
        assert_eq!(p.sitstand, None);
        assert_eq!(
            p.head_lowpass, None,
            "alpha 1.0 is a pass-through, so store it as off"
        );
        assert_eq!(
            p.legs_lowpass,
            Some(0.7),
            "the other filter keeps its default"
        );
    }

    /// A typo in a key is named and ignored, and the setting it was aimed at keeps its default.
    ///
    /// It used to be fatal, on the argument that silently ignoring `min_acheived_hz` leaves the
    /// operator believing they moved a threshold they did not. The value of that is real and is
    /// why the key is named at `warn`; what it does not justify is a robot that will not start.
    /// See [`without_unknown_keys`].
    #[test]
    fn a_typo_is_ignored_and_leaves_the_real_key_alone() {
        let dir = tempfile::tempdir().unwrap();
        let path = write(dir.path(), "[update_gate]\nmin_acheived_hz = 10.0\n");
        let p = Params::load(&path, true).expect("a typo must not stop the robot starting");
        assert_eq!(
            p.update_gate.min_achieved_hz,
            UpdateGate::default().min_achieved_hz,
            "the misspelt key must not have moved the real one"
        );

        let (_, ignored) = without_unknown_keys("[update_gate]\nmin_acheived_hz = 10.0\n")
            .expect("an unknown key is what this file has");
        assert_eq!(ignored, ["update_gate.min_acheived_hz"]);
    }

    /// The renamed section, reported as the section rather than as each key under it.
    ///
    /// `install.sh` never overwrites `robotd.toml`, so a board carrying `[health]` keeps it
    /// across every update. That used to mean a `robotd` that would not start; it now means a
    /// line in the journal naming the section and a robot that walks.
    #[test]
    fn the_old_health_section_name_is_ignored_by_name() {
        let dir = tempfile::tempdir().unwrap();
        let path = write(dir.path(), "[health]\nmin_achieved_hz = 40.0\n");
        assert!(Params::load(&path, true).is_ok());

        let (_, ignored) = without_unknown_keys("[health]\nmin_achieved_hz = 40.0\n").unwrap();
        assert_eq!(ignored, ["[health]"], "one decision, not one line per key");
    }

    /// The incident this came from. A robot running the `duck-chorale` branch had `[chorale]`
    /// in its `robotd.toml`; `main` has no such feature, so the update to it produced a `robotd`
    /// that exited on every start, a health gate that timed out, and four rollbacks in a row —
    /// over a section that does nothing.
    #[test]
    fn a_section_from_another_branch_does_not_stop_the_robot() {
        let dir = tempfile::tempdir().unwrap();
        let path = write(
            dir.path(),
            "[control]\nhz = 50\n\n[chorale]\naccept = true\n",
        );
        let p = Params::load(&path, true).expect("an inert section must not be fatal");
        assert_eq!(p.control.hz, 50, "the rest of the file must still be read");
    }

    /// The other half, so leniency cannot become "accept anything". A value of the wrong type is
    /// still an error, with its position, exactly as before.
    #[test]
    fn a_bad_value_is_still_rejected_with_its_position() {
        let dir = tempfile::tempdir().unwrap();
        let path = write(dir.path(), "[control]\nhz = \"fast\"\n");
        let err = Params::load(&path, true)
            .expect_err("a string where a number belongs is not something to warn about")
            .to_string();
        assert!(err.contains("line"), "{err}");
    }

    /// A real error sharing a file with an inert one. The error must be about `hz`, and must not
    /// be about `[chorale]` — naming the section this release just declared harmless as the
    /// reason the daemon will not start is how someone spends an afternoon deleting the wrong
    /// thing.
    #[test]
    fn a_bad_value_beside_an_unknown_section_names_the_bad_value() {
        let dir = tempfile::tempdir().unwrap();
        let path = write(
            dir.path(),
            "[chorale]\naccept = true\n\n[control]\nhz = \"fast\"\n",
        );
        let err = Params::load(&path, true)
            .expect_err("the file still does not parse")
            .to_string();
        assert!(err.contains("hz"), "{err}");
        assert!(!err.contains("chorale"), "{err}");
    }

    /// And a file that is not TOML at all fails as it always did, rather than being pruned into
    /// something that parses.
    #[test]
    fn a_syntax_error_is_still_a_syntax_error() {
        let dir = tempfile::tempdir().unwrap();
        let path = write(dir.path(), "[control\nhz = 50\n");
        assert!(Params::load(&path, true).is_err());
    }

    /// A file this build understands completely takes the strict path and reports nothing.
    #[test]
    fn a_clean_file_has_nothing_to_report() {
        assert!(without_unknown_keys("[control]\nhz = 50\n").is_none());
    }

    /// Zero would divide by zero when computing the period; absurdly high would spin.
    #[test]
    fn an_impossible_rate_is_rejected_at_startup() {
        let dir = tempfile::tempdir().unwrap();
        for hz in ["0", "5000"] {
            let path = write(dir.path(), &format!("[control]\nhz = {hz}\n"));
            assert!(Params::load(&path, true).is_err(), "hz = {hz} was accepted");
        }
    }
}
