canadoce/DuckBuddy/duck-control/src/imu.rs

//! The `imu_to_dxl` v2 board (LSM6DSV16X), decoded — and [`TrunkFrame`], the sensor→trunk
//! arithmetic it shares with the BNO055 on I²C ([`crate::bno055`]).
//!
//! One IMU per robot, one code path for each. The board rides the Dynamixel bus and its 12-byte block is
//! fetched in the same `sync_read` as the servos, so there is no separate sensor to poll
//! and no fusion to run on the host — the chip's SFLP block ships a game-rotation
//! quaternion and estimates its own gyro bias.
//!
//! Block layout at address 124:
//!
//! | bytes | contents |
//! |---|---|
//! | 0..6  | gyro x/y/z, `i16` LE raw counts, ±500 dps |
//! | 6..12 | SFLP quaternion x/y/z as IEEE half-precision; `w = √(1 − x² − y² − z²)` |
//!
//! The board's full diagnostic block is 20 bytes (it also carries raw accelerometer, a
//! sample counter and status flags). The control loop consumes only the first 12 so the
//! read fits alongside the servos in one transaction.

use crate::model::NUM_JOINTS;

/// Bytes of the v2 board's block consumed per tick.
pub const IMU_BLOCK_LEN: usize = 12;

/// What the control loop knows about the robot's orientation.
#[derive(Debug, Clone, Copy, PartialEq)]
pub struct ImuData {
    /// Angular velocity in the trunk frame, rad/s.
    pub gyro: [f64; 3],
    /// Projected gravity in the trunk frame, unit vector. Upright is `[0, 0, -1]`.
    ///
    /// This is what the policy observes, and what fall detection thresholds on.
    pub gravity: [f64; 3],
    /// Orientation, trunk→world, scalar-first `[w, x, y, z]`.
    pub quat: [f64; 4],
}

impl Default for ImuData {
    fn default() -> Self {
        Self {
            gyro: [0.0; 3],
            gravity: [0.0, 0.0, -1.0],
            quat: [1.0, 0.0, 0.0, 0.0],
        }
    }
}

impl ImuData {
    /// A still robot whose trunk sees gravity along `g` (any length; upright is `[0, 0, -1]`),
    /// with the shortest rotation that takes `g` to the world's down as its orientation.
    /// `None` for a zero vector. For fakes and tests: a real IMU measures both.
    pub fn from_gravity(g: [f64; 3]) -> Option<Self> {
        let n = (g[0] * g[0] + g[1] * g[1] + g[2] * g[2]).sqrt();
        if !(n > 1e-9) {
            return None;
        }
        let a = [g[0] / n, g[1] / n, g[2] / n];
        // a → b = [0, 0, -1]: q = [1 + a·b, a × b], normalized; upside down turns about x.
        let dot = -a[2];
        let mut q = [1.0 + dot, -a[1], a[0], 0.0];
        if q[0] < 1e-9 {
            q = [0.0, 1.0, 0.0, 0.0];
        }
        let m = (q[0] * q[0] + q[1] * q[1] + q[2] * q[2] + q[3] * q[3]).sqrt();
        Some(Self {
            gyro: [0.0; 3],
            gravity: a,
            quat: [q[0] / m, q[1] / m, q[2] / m, q[3] / m],
        })
    }
}

/// ±500 dps at 17.5 mdps/LSB, in rad/s.
const GYRO_RAD_PER_LSB: f64 = 0.0175 * std::f64::consts::PI / 180.0;

/// Sensor readings to trunk-frame [`ImuData`]: the mounting rotation, the last good
/// orientation held across samples that carry none, the readiness count and the median of
/// three. Shared by every IMU the robot can carry — the bus board ([`SflpDecoder`]) and the
/// BNO055 on I²C ([`crate::bno055`]) — so both report orientation through exactly the same
/// arithmetic.
pub struct TrunkFrame {
    /// Sensor→trunk mounting rotation, scalar-first.
    mount: [f64; 4],
    /// Last quaternion the sensor actually produced. Held across samples that arrive before
    /// its fusion has written one — snapping to identity would report a robot as upright
    /// when its orientation is simply unknown, which is the worst possible lie to tell
    /// fall detection.
    last_quat: [f64; 4],
    /// Samples carrying a live quaternion. Gates [`TrunkFrame::ready`].
    quat_samples: u32,
    gyro_history: [[f64; 3]; 2],
    gravity_history: [[f64; 3]; 2],
    /// Median of three ticks on gyro and gravity (on by default). It rejects a single wild
    /// block, but at 50 Hz it also delays a swing by about a tick, and the walking policies
    /// fail past ~20 ms of IMU lag (BAM simulation, 2026-10-10): with it, the HL-2915 robot's
    /// trunk rocked and the policy flailed the neck as on the robot.
    median: bool,
}

impl TrunkFrame {
    pub fn new(mount: [f64; 4]) -> Self {
        Self {
            mount,
            last_quat: [1.0, 0.0, 0.0, 0.0],
            quat_samples: 0,
            gyro_history: [[0.0; 3]; 2],
            gravity_history: [[0.0, 0.0, -1.0]; 2],
            median: true,
        }
    }

    /// Pass each sample through as read, without the median of three.
    pub fn with_median(mut self, median: bool) -> Self {
        self.median = median;
        self
    }

    /// Whether the sensor has demonstrably produced fused output — roughly 0.25 s at 100 Hz.
    ///
    /// Until this is true the orientation is a default, not a measurement. Slice 2's fall
    /// detection must not run before it.
    pub fn ready(&self) -> bool {
        self.quat_samples >= 25
    }

    /// One sample in the sensor's own frame: angular velocity in rad/s and, when the sample
    /// carries one, the sensor→world orientation (scalar-first, world z up). A quaternion
    /// that is not close to unit length is ignored, as if the sample carried none.
    pub fn update(&mut self, gyro_sensor: [f64; 3], quat_sensor: Option<[f64; 4]>) -> ImuData {
        let gyro = rotate(self.mount, gyro_sensor);

        if let Some(q_sensor) = quat_sensor {
            let mount_inv = [
                self.mount[0],
                -self.mount[1],
                -self.mount[2],
                -self.mount[3],
            ];
            let q = mul(q_sensor, mount_inv);
            let norm = (q[0] * q[0] + q[1] * q[1] + q[2] * q[2] + q[3] * q[3]).sqrt();
            if norm.is_finite() && norm > 0.5 {
                self.last_quat = [q[0] / norm, q[1] / norm, q[2] / norm, q[3] / norm];
                self.quat_samples = self.quat_samples.saturating_add(1);
            }
        }

        // Normalise *before* the median, matching the runtime. Note the consequence: a
        // component-wise median across three unit vectors is not itself unit-norm, so
        // during a transient the policy sees a slightly short vector. Steady state is
        // exact. Whether the training env expects strict unit norm is worth settling when
        // slice 2 wires up observations — normalising after the median would guarantee it,
        // but that is a behaviour change to a path that currently walks.
        let gravity = normalise(rotate_inverse(self.last_quat, [0.0, 0.0, -1.0]));

        let out = if self.median {
            ImuData {
                gyro: median3_each(&self.gyro_history, gyro),
                gravity: median3_each(&self.gravity_history, gravity),
                quat: self.last_quat,
            }
        } else {
            ImuData {
                gyro,
                gravity,
                quat: self.last_quat,
            }
        };
        self.gyro_history = [self.gyro_history[1], gyro];
        self.gravity_history = [self.gravity_history[1], gravity];
        out
    }
}

/// Decodes the board's block into [`ImuData`].
///
/// Stateful only for spike rejection and for holding the last good quaternion — there is
/// no filter here. Keeping the state explicit means [`crate::io::FakeIo`] can drive the
/// same decoder in tests.
pub struct SflpDecoder {
    frame: TrunkFrame,
}

impl Default for SflpDecoder {
    fn default() -> Self {
        Self::new(Self::DEFAULT_MOUNT)
    }
}

impl SflpDecoder {
    /// The board is mounted so that trunk = `[+raw_z, +raw_y, −raw_x]`, a +90° rotation
    /// about Y.
    pub const DEFAULT_MOUNT: [f64; 4] = [
        std::f64::consts::FRAC_1_SQRT_2,
        0.0,
        std::f64::consts::FRAC_1_SQRT_2,
        0.0,
    ];

    pub fn new(mount: [f64; 4]) -> Self {
        Self {
            frame: TrunkFrame::new(mount),
        }
    }

    /// Pass each block through as read, without the median of three.
    pub fn with_median(mut self, median: bool) -> Self {
        self.frame = self.frame.with_median(median);
        self
    }

    /// Whether the chip has demonstrably produced fused output — see [`TrunkFrame::ready`].
    pub fn ready(&self) -> bool {
        self.frame.ready()
    }

    pub fn decode(&mut self, raw: &[u8; IMU_BLOCK_LEN]) -> ImuData {
        let gyro_sensor = [
            i16::from_le_bytes([raw[0], raw[1]]) as f64 * GYRO_RAD_PER_LSB,
            i16::from_le_bytes([raw[2], raw[3]]) as f64 * GYRO_RAD_PER_LSB,
            i16::from_le_bytes([raw[4], raw[5]]) as f64 * GYRO_RAD_PER_LSB,
        ];

        // All-zero quaternion bytes mean SFLP has not written its table yet — the board
        // just powered up, or its init failed. Keep the last good value.
        let packed = [
            u16::from_le_bytes([raw[6], raw[7]]),
            u16::from_le_bytes([raw[8], raw[9]]),
            u16::from_le_bytes([raw[10], raw[11]]),
        ];
        let mut quat = None;
        if packed != [0, 0, 0] {
            let (x, y, z) = (half(packed[0]), half(packed[1]), half(packed[2]));
            let norm_sq = x * x + y * y + z * z;
            // A quaternion the chip never produced would fail this; ≤ 1.02 allows for
            // half-precision rounding at full scale.
            if x.is_finite() && y.is_finite() && z.is_finite() && norm_sq <= 1.02 {
                let w = (1.0 - norm_sq).max(0.0).sqrt();
                quat = Some([w, x, y, z]);
            }
        }
        self.frame.update(gyro_sensor, quat)
    }
}

/// Single-sample spike rejection. A dropped or corrupted block shows up as one wild value;
/// a median over three discards it without the lag of an average.
fn median3_each(history: &[[f64; 3]; 2], now: [f64; 3]) -> [f64; 3] {
    let m = |a: f64, b: f64, c: f64| a.max(b).min(c).max(a.min(b));
    [
        m(history[0][0], history[1][0], now[0]),
        m(history[0][1], history[1][1], now[1]),
        m(history[0][2], history[1][2], now[2]),
    ]
}

/// IEEE 754 binary16 → f64. The LSM6DSV16X ships quaternion components in this format.
fn half(bits: u16) -> f64 {
    let sign = if bits & 0x8000 != 0 { -1.0 } else { 1.0 };
    let exp = ((bits >> 10) & 0x1F) as i32;
    let frac = (bits & 0x3FF) as f64;
    match exp {
        0 => sign * frac * 2.0_f64.powi(-24),
        0x1F if frac == 0.0 => sign * f64::INFINITY,
        0x1F => f64::NAN,
        _ => sign * (1.0 + frac / 1024.0) * 2.0_f64.powi(exp - 15),
    }
}

/// Hamilton product, scalar-first.
fn mul(a: [f64; 4], b: [f64; 4]) -> [f64; 4] {
    let ([aw, ax, ay, az], [bw, bx, by, bz]) = (a, b);
    [
        aw * bw - ax * bx - ay * by - az * bz,
        aw * bx + ax * bw + ay * bz - az * by,
        aw * by - ax * bz + ay * bw + az * bx,
        aw * bz + ax * by - ay * bx + az * bw,
    ]
}

/// `q · v · q⁻¹`
fn rotate(q: [f64; 4], v: [f64; 3]) -> [f64; 3] {
    let (t, c) = cross_terms(q, v);
    [
        v[0] + q[0] * t[0] + c[0],
        v[1] + q[0] * t[1] + c[1],
        v[2] + q[0] * t[2] + c[2],
    ]
}

/// `q⁻¹ · v · q` — world vector expressed in the body frame.
fn rotate_inverse(q: [f64; 4], v: [f64; 3]) -> [f64; 3] {
    let (t, c) = cross_terms(q, v);
    [
        v[0] - q[0] * t[0] + c[0],
        v[1] - q[0] * t[1] + c[1],
        v[2] - q[0] * t[2] + c[2],
    ]
}

fn cross_terms(q: [f64; 4], v: [f64; 3]) -> ([f64; 3], [f64; 3]) {
    let (x, y, z) = (q[1], q[2], q[3]);
    let t = [
        (y * v[2] - z * v[1]) * 2.0,
        (z * v[0] - x * v[2]) * 2.0,
        (x * v[1] - y * v[0]) * 2.0,
    ];
    let c = [
        y * t[2] - z * t[1],
        z * t[0] - x * t[2],
        x * t[1] - y * t[0],
    ];
    (t, c)
}

/// Unit vector, falling back to "upright" rather than dividing by ~zero.
fn normalise(v: [f64; 3]) -> [f64; 3] {
    let mag = (v[0] * v[0] + v[1] * v[1] + v[2] * v[2]).sqrt();
    if mag > 0.1 {
        [v[0] / mag, v[1] / mag, v[2] / mag]
    } else {
        [0.0, 0.0, -1.0]
    }
}

/// `mount` followed by a trunk-frame rotation about Y, so the reported pitch reads
/// `pitch_deg` further nose-down (the projected-gravity pitch the policy sees: positive is
/// gravity along trunk +x). Gyro and gravity both go through the mount, so they stay in one
/// frame. For a board a few degrees off its nominal mounting: a systematic offset is
/// something the policies cannot learn (their IMU randomization is zero-centred), so the
/// runtime removes it — as upstream's runtime does with its pitch offset.
pub fn with_pitch_trim(mount: [f64; 4], pitch_deg: f64) -> [f64; 4] {
    // A trunk-frame rotation by δ about Y turns upright gravity (0, 0, −1) into
    // (−sin δ, 0, −cos δ), a pitch of −δ; hence the sign.
    let half = (-pitch_deg).to_radians() / 2.0;
    mul([half.cos(), 0.0, half.sin(), 0.0], mount)
}

/// `mount` followed by a trunk-frame rotation about X, so the reported roll — `atan2(−g_y,
/// −g_z)` of the projected gravity, positive with gravity along trunk −y — reads `roll_deg`
/// more. The roll counterpart of [`with_pitch_trim`]: on 2026-10-11 the IMU board, refitted,
/// read about 2° of roll on a robot whose legs stood level, and the walk fell apart.
pub fn with_roll_trim(mount: [f64; 4], roll_deg: f64) -> [f64; 4] {
    // A trunk-frame rotation by δ about X turns upright gravity (0, 0, −1) into
    // (0, sin δ, −cos δ), a roll of −δ; hence the sign.
    let half = (-roll_deg).to_radians() / 2.0;
    mul([half.cos(), half.sin(), 0.0, 0.0], mount)
}

/// Mounting rotation from an axis map: `"z,y,-x"` means trunk x = sensor z, trunk y = sensor
/// y, trunk z = −sensor x — the original board, [`SflpDecoder::DEFAULT_MOUNT`].
///
/// Written this way because it is what someone holding the robot can check: lay it on its
/// back and see which sensor axis carries gravity. A quaternion is not. Mirror images are
/// refused — a board cannot be mounted as one.
pub fn mount_from_axes(spec: &str) -> Result<[f64; 4], String> {
    let mut m = [[0.0f64; 3]; 3];
    let parts: Vec<&str> = spec.split(',').map(str::trim).collect();
    if parts.len() != 3 {
        return Err(format!(
            "imu axes {spec:?}: want three comma-separated axes like \"z,y,-x\""
        ));
    }
    let mut used = [false; 3];
    for (row, part) in parts.iter().enumerate() {
        let (sign, axis) = match part.strip_prefix('-') {
            Some(rest) => (-1.0, rest),
            None => (1.0, part.strip_prefix('+').unwrap_or(part)),
        };
        let col = match axis {
            "x" => 0,
            "y" => 1,
            "z" => 2,
            _ => return Err(format!("imu axes {spec:?}: {part:?} is not ±x, ±y or ±z")),
        };
        if std::mem::replace(&mut used[col], true) {
            return Err(format!("imu axes {spec:?}: sensor {axis} used twice"));
        }
        m[row][col] = sign;
    }
    let det = m[0][0] * (m[1][1] * m[2][2] - m[1][2] * m[2][1])
        - m[0][1] * (m[1][0] * m[2][2] - m[1][2] * m[2][0])
        + m[0][2] * (m[1][0] * m[2][1] - m[1][1] * m[2][0]);
    if det < 0.0 {
        return Err(format!(
            "imu axes {spec:?} is a mirror image, not a rotation — flip the sign of one axis"
        ));
    }
    // Rotation matrix (sensor → trunk) to quaternion, picking the numerically largest term.
    let tr = m[0][0] + m[1][1] + m[2][2];
    let q = if tr > 0.0 {
        let s = (tr + 1.0).sqrt() * 2.0;
        [
            0.25 * s,
            (m[2][1] - m[1][2]) / s,
            (m[0][2] - m[2][0]) / s,
            (m[1][0] - m[0][1]) / s,
        ]
    } else if m[0][0] > m[1][1] && m[0][0] > m[2][2] {
        let s = (1.0 + m[0][0] - m[1][1] - m[2][2]).sqrt() * 2.0;
        [
            (m[2][1] - m[1][2]) / s,
            0.25 * s,
            (m[0][1] + m[1][0]) / s,
            (m[0][2] + m[2][0]) / s,
        ]
    } else if m[1][1] > m[2][2] {
        let s = (1.0 + m[1][1] - m[0][0] - m[2][2]).sqrt() * 2.0;
        [
            (m[0][2] - m[2][0]) / s,
            (m[0][1] + m[1][0]) / s,
            0.25 * s,
            (m[1][2] + m[2][1]) / s,
        ]
    } else {
        let s = (1.0 + m[2][2] - m[0][0] - m[1][1]).sqrt() * 2.0;
        [
            (m[1][0] - m[0][1]) / s,
            (m[0][2] + m[2][0]) / s,
            (m[1][2] + m[2][1]) / s,
            0.25 * s,
        ]
    };
    Ok(q)
}

/// Compile-time assurance that the joint count and this module stay independent — the IMU
/// block is fixed-size regardless of how many servos share the bus.
const _: () = assert!(NUM_JOINTS > 0);

#[cfg(test)]
mod tests {
    use super::*;

    /// The axis map must reproduce the original board's mount exactly, or switching the
    /// default to the new key would silently rotate every existing robot.
    #[test]
    fn the_default_axis_map_is_the_default_mount() {
        let q = mount_from_axes("z,y,-x").unwrap();
        for (a, b) in q.iter().zip(SflpDecoder::DEFAULT_MOUNT) {
            assert!((a - b).abs() < 1e-12, "{q:?}");
        }
    }

    /// Every axis map rotates sensor axes exactly where it says: checked through the same
    /// `rotate` the decoder uses, so it is the behaviour that is pinned, not a quaternion sign.
    #[test]
    fn axis_maps_rotate_as_written() {
        for (spec, want) in [
            ("z,y,-x", [[0., 0., -1.], [0., 1., 0.], [1., 0., 0.]]),
            // The rev-a PDB R2f: U2 on the bottom face. Measured on the robot 2026-10-04.
            ("y,x,-z", [[0., 1., 0.], [1., 0., 0.], [0., 0., -1.]]),
            ("x,y,z", [[1., 0., 0.], [0., 1., 0.], [0., 0., 1.]]),
            // The open PDB/IMU R3: U2 on the top face. Not yet measured on a robot.
            ("-y,x,z", [[0., 1., 0.], [-1., 0., 0.], [0., 0., 1.]]),
        ] {
            let q = mount_from_axes(spec).unwrap();
            for (axis, expect) in want.iter().enumerate() {
                let mut v = [0.0; 3];
                v[axis] = 1.0;
                let got = rotate(q, v);
                for k in 0..3 {
                    assert!(
                        (got[k] - expect[k]).abs() < 1e-9,
                        "{spec}: sensor axis {axis} -> {got:?}"
                    );
                }
            }
        }
    }

    /// The trim shifts the reported pitch by exactly its value, nose-down positive, for any
    /// mount — checked through the decoder's own maths: the chip reports the sensor's
    /// orientation, the decoder puts gravity through the (trimmed) mount.
    #[test]
    fn pitch_trim_shifts_the_reported_pitch() {
        for spec in ["z,y,-x", "y,x,-z"] {
            let mount = mount_from_axes(spec).unwrap();
            // Trunk upright: gravity in the sensor frame is the mount's inverse of "down".
            let g_sensor = rotate_inverse(mount, [0.0, 0.0, -1.0]);
            for trim in [0.0, 3.3, -5.0] {
                let g = rotate(with_pitch_trim(mount, trim), g_sensor);
                let pitch = g[0].atan2((g[1] * g[1] + g[2] * g[2]).sqrt()).to_degrees();
                assert!(
                    (pitch - trim).abs() < 1e-9,
                    "{spec} trim {trim}: pitch {pitch}"
                );
                assert!(
                    g[1].abs() < 1e-9,
                    "{spec} trim {trim}: the trim leaked into roll"
                );
            }
            let same = with_pitch_trim(mount, 0.0);
            for (a, b) in same.iter().zip(mount) {
                assert!((a - b).abs() < 1e-12);
            }
        }
    }

    #[test]
    fn roll_trim_shifts_the_reported_roll() {
        for spec in ["z,y,-x", "y,x,-z"] {
            let mount = mount_from_axes(spec).unwrap();
            let g_sensor = rotate_inverse(mount, [0.0, 0.0, -1.0]);
            for trim in [0.0, 2.0, -3.5] {
                let g = rotate(with_roll_trim(mount, trim), g_sensor);
                let roll = (-g[1]).atan2(-g[2]).to_degrees();
                assert!(
                    (roll - trim).abs() < 1e-9,
                    "{spec} trim {trim}: roll {roll}"
                );
                assert!(
                    g[0].abs() < 1e-9,
                    "{spec} trim {trim}: the trim leaked into pitch"
                );
            }
            // With a pitch trim too, each shows up on its own axis (to first order).
            let both = with_roll_trim(with_pitch_trim(mount, 3.3), 2.0);
            let g = rotate(both, g_sensor);
            let pitch = g[0].atan2((g[1] * g[1] + g[2] * g[2]).sqrt()).to_degrees();
            let roll = (-g[1]).atan2(-g[2]).to_degrees();
            assert!(
                (pitch - 3.3).abs() < 0.01 && (roll - 2.0).abs() < 0.01,
                "{pitch} {roll}"
            );
        }
    }

    #[test]
    fn mirror_images_and_typos_are_refused() {
        assert!(mount_from_axes("x,y,-z").unwrap_err().contains("mirror"));
        assert!(mount_from_axes("x,x,z").is_err());
        assert!(mount_from_axes("x,y").is_err());
        assert!(mount_from_axes("x,y,w").is_err());
    }

    /// Half-precision decoding is hand-rolled, so pin the cases that matter: zero, one,
    /// a negative, and a subnormal. A wrong exponent bias here silently tilts the horizon.
    #[test]
    fn half_precision_decodes_known_values() {
        assert_eq!(half(0x0000), 0.0);
        assert_eq!(half(0x3C00), 1.0);
        assert_eq!(half(0xBC00), -1.0);
        assert_eq!(half(0x3800), 0.5);
        assert!((half(0x3555) - 0.333).abs() < 1e-3);
    }

    /// A block of zeroes is the board saying "SFLP has not started". Reporting identity —
    /// i.e. perfectly upright — would tell fall detection the robot is fine when its
    /// orientation is simply unknown.
    #[test]
    fn all_zero_quaternion_bytes_hold_the_last_good_value() {
        let mut d = SflpDecoder::default();
        assert!(!d.ready());

        let zero = d.decode(&[0u8; IMU_BLOCK_LEN]);
        assert_eq!(zero.quat, [1.0, 0.0, 0.0, 0.0]);
        assert!(!d.ready(), "a zero block must not count as a live sample");

        // 0x3C00 = 1.0 in the x slot would exceed unit norm on its own; use a modest
        // rotation the chip could actually emit.
        let mut block = [0u8; IMU_BLOCK_LEN];
        block[6..8].copy_from_slice(&0x3000u16.to_le_bytes()); // x = 0.125
        let live = d.decode(&block);
        assert_ne!(live.quat, [1.0, 0.0, 0.0, 0.0]);

        let held = d.decode(&[0u8; IMU_BLOCK_LEN]);
        assert_eq!(held.quat, live.quat, "zero block must hold, not reset");
    }

    /// `ready()` gates fall detection in slice 2. If it were true from the first block,
    /// the robot would be judged on a default orientation for the first quarter second.
    #[test]
    fn not_ready_until_the_chip_has_produced_output() {
        let mut d = SflpDecoder::default();
        let mut block = [0u8; IMU_BLOCK_LEN];
        block[6..8].copy_from_slice(&0x3000u16.to_le_bytes());
        for _ in 0..24 {
            d.decode(&block);
        }
        assert!(!d.ready());
        d.decode(&block);
        assert!(d.ready());
    }

    /// In steady state gravity must be a unit vector at any orientation — the policy
    /// observes it directly and was trained on normalised input.
    ///
    /// Three identical blocks per orientation so the median settles. Mid-transient the
    /// median blends three different unit vectors component-wise and the result is
    /// slightly short; that is the runtime's behaviour and is deliberately preserved (see
    /// the note in `decode`).
    #[test]
    fn gravity_is_a_unit_vector_in_steady_state() {
        let mut d = SflpDecoder::default();
        let mut block = [0u8; IMU_BLOCK_LEN];
        for packed in [0x0000u16, 0x3000, 0x3800, 0xB000] {
            block[6..8].copy_from_slice(&packed.to_le_bytes());
            d.decode(&block);
            d.decode(&block);
            let g = d.decode(&block).gravity;
            let mag = (g[0] * g[0] + g[1] * g[1] + g[2] * g[2]).sqrt();
            assert!(
                (mag - 1.0).abs() < 1e-9,
                "gravity magnitude {mag} for {packed:#06x}"
            );
        }
    }

    /// The transient case, pinned so the bound is known rather than assumed: switching
    /// orientation between ticks blends three vectors and shortens the result. If this
    /// ever gets far from 1.0 the policy is being fed something training never saw.
    #[test]
    fn gravity_stays_close_to_unit_through_a_transient() {
        let mut d = SflpDecoder::default();
        let mut block = [0u8; IMU_BLOCK_LEN];
        block[6..8].copy_from_slice(&0x0000u16.to_le_bytes());
        d.decode(&block);
        block[6..8].copy_from_slice(&0x3800u16.to_le_bytes());
        let g = d.decode(&block).gravity;
        let mag = (g[0] * g[0] + g[1] * g[1] + g[2] * g[2]).sqrt();
        assert!(mag > 0.5, "transient gravity collapsed to {mag}");
        assert!(mag <= 1.0 + 1e-9);
    }

    /// Gyro counts are signed. Reading them as unsigned would turn every negative rate
    /// into a large positive one, which reads as a robot spinning.
    #[test]
    fn gyro_counts_are_signed() {
        let mut d = SflpDecoder::default();
        let mut block = [0u8; IMU_BLOCK_LEN];
        block[0..2].copy_from_slice(&(-1000i16).to_le_bytes());
        // Three identical blocks so the median settles on this sample.
        d.decode(&block);
        d.decode(&block);
        let out = d.decode(&block);
        let magnitude: f64 = out.gyro.iter().map(|v| v.abs()).sum();
        assert!(magnitude > 0.0);
        let expected = 1000.0 * GYRO_RAD_PER_LSB;
        assert!(
            (magnitude - expected).abs() < 1e-9,
            "expected |gyro| {expected}, got {magnitude}"
        );
    }

    /// Without the median a change shows on the tick it arrives; with it, only once two of
    /// the last three blocks agree.
    #[test]
    fn without_the_median_a_change_shows_at_once() {
        let mut still = [0u8; IMU_BLOCK_LEN];
        still[0..2].copy_from_slice(&0i16.to_le_bytes());
        let mut turning = still;
        turning[0..2].copy_from_slice(&(-1000i16).to_le_bytes());
        let rate =
            |d: &mut SflpDecoder| d.decode(&turning).gyro.iter().map(|v| v.abs()).sum::<f64>();

        let mut median = SflpDecoder::default();
        median.decode(&still);
        median.decode(&still);
        assert_eq!(rate(&mut median), 0.0);

        let mut direct = SflpDecoder::default().with_median(false);
        direct.decode(&still);
        direct.decode(&still);
        assert!((rate(&mut direct) - 1000.0 * GYRO_RAD_PER_LSB).abs() < 1e-9);
    }
}
