canadoce/DuckBuddy/(commit log)

2026-11-06 robotd: Robot HAT E1 and BNO055 body IMU support
    - duck-control: BNO055 over I2C as the body IMU ([bus] imu_source = "bno055",
    imu_i2c, imu_i2c_address), with a bno055_probe example
    - deploy/robots/opi-hl2915-robothat-e1.toml: robot config for the Orange Pi
    Zero 3W + Robot HAT E1 + HL-2915 build
    - deploy/audio: AIC3104 device tree and service for the Robot HAT E1, mic
    routes line1-se and mic2r-both, codec bus found from sysfs
    - docs/hardware/INTERFACE-CN.md: translated to English, Robot HAT E1 section
2026-11-06 hardware/pcb/pdb-imu: open PDB/IMU board R3 (tscircuit) and firmware 1.2
    - the R3 board design with JLCPCB fabrication files and ordering notes
    - imu-feetech firmware 1.2: battery voltage at byte 14 (R3 only), README in
    English with the R3 J7 Tag-Connect flashing pads
    [pdb-imu-r3-bom-v2.csv, pdb-imu-r3-bom.csv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]
2026-11-06 hardware/cad: open head shell and LiPo plate
    - open-head: development head that holds the Robot HAT E1 next to the Orange
    Pi Zero 3W, plus the speaker ring and the face plate collar
    - lipo-plate: battery plate for a 3S 2200 mAh LiPo with the BNO055 mount
    - print: DuckBuddy.3mf updated, README translated to English
    [DuckBuddy.3mf, banana_pcb_locker__2.stl, banana_pcb_locker_duckbuddy.stl, bottom_head_shell_duckbuddy.stl, face_part_duckbuddy.stl, jaw_soft__bottom_head_shell__56.stl, jaw_soft__elec_rpi_robot_hat_pcb__51.stl, jaw_soft__face_part__43.stl]
2026-11-06 tools/bringup: Raspberry Pi test bench and Robot HAT E1 support
    - --bench runs agent.py on a Raspberry Pi with the Robot HAT E1, which talks
    to factory servos at 1 Mbit/s, in place of the Feetech USB board
    - --hat robothat-e1 for the robot build, BNO055 test in the whole-robot test
    - one-at-a-time setup of factory servos in an assembled robot
    - bringup, joint_align, robot-tests and servo tools translated to English
2026-11-06 docs: Robot HAT E1 only, English README as the default
    - README.md is the English README (README-EN.md removed); the hardware
    section, diagram, build steps, parts list and FAQ describe the Robot HAT E1
    build, linked to https://code.caric.io/Robotics/elec_RPI_Robot_HAT
    - docs/hardware/INTERFACE-CN.md and deploy/audio/README-A733-CN.md rewritten
    for the Robot HAT E1; the old HAT's images removed, the software diagram
    updated
    - the Robot HAT E1 is the default: robotd port /dev/ttyS0 and imu_source
    bno055, installer --hat robothat-e1, ping_all.py and bringup on /dev/ttyS0;
    the rev-a robot config sets imu_source = "bus"
2026-11-06 docs: servo wiring as two daisy chains (port A: head then one leg, port B: the other leg), no Y-cable
2026-11-07 deploy/brain: set up the Orange Pi brain and install the DuckBuddy services
    The brain is the Orange Pi Zero 3W (A733) with the Robot HAT E1 in the head.
    - install.sh (on the board, sudo): device tree overlay (TLV320AIC3104 on
    TWI0 as a real ALSA card "aic3104", TWI2 for the Qwiic J8 ToF, UART0 at a
    96 MHz clock for exact 1M/500k), the codec driver built from the matching
    kernel source, mixer setup at boot (alsamixer works), /etc/asound.conf
    with duck_out/duck_in, 3S battery guard, camera modules and camgrab with
    the IMX219 tuning, the SD card power cycle on reboot, udev names, groups,
    the NetworkManager polkit rule for visiond, lingering, Python packages.
    Removes the earlier o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
    [agent.py, camgrab.c]
2026-11-07 servo dummies: printed stand-ins for the joints without a servo
    hardware/cad/servo-dummy: an XL330-shaped dummy (STL, 3MF, build123d source) and
    layout/robot_layout.py, which colors where the dummies go on the full robot model.
    joint_ids 0 marks a joint with a dummy: robotd skips it on the bus, and the
    bring-up workbench maps, checks and rescans around it.
    [servo_dummy.3mf, servo_dummy.stl]
2026-11-07 voiced: Moonshine v2 English and who is speaking
    Speech to text is Moonshine v2 base (English), with the DPDFNet denoiser
    (GTCRN still selectable). voices.py keeps voice prints (TitaNet-small): people
    introduce themselves ("my name is ...") and later phrases tell who spoke; the
    name goes to lifed and shows on the phone page. deploy.sh fetches the models
    into ~/models/hearing and installs the duckbrain units.
2026-11-07 tools/sim: the whole duck on a Mac, with a web page for its body
    uv run tools/sim/phoebe_sim.py starts robotd --fake (with the policies), lifed,
    voiced, visiond, duckweb, duckbrain and duckjev. Stand-ins for aplay, arecord,
    duckcam, amixer and nmcli connect them to the page: the browser's mic, camera
    and speakers, a ToF slider, Start/Stop, tilt buttons and the services' logs.
    robotd --fake-tilt reads the fake IMU's gravity from a file.
2026-11-08 deploy/brain: make the SD card power cycle on reboot more robust
    One reboot in a few still left the board off until the power was pulled. The
    card's power now stays off for 1 s instead of 0.5 s, and the switch-on is read
    back from the PMIC and retried until it holds.
2026-11-08 deploy/brain: boot even when a servo holds the data line low
    U-Boot on the Orange Pi image keeps its console on UART0, the servo bus, and waits one second
    for a key before it starts Linux. A faulty servo that holds the data line low reads as a key
    press, so the board stopped at U-Boot's prompt and never booted.
    uboot_nowait.py changes U-Boot's built-in bootdelay=1 to bootdelay=-2 (start without checking
    for a key) on the boot card, fixes U-Boot's own checksum and the package checksum, saves the
    card's boot area first and reads the write back. install.sh runs it; it changes only a U-Boot
    with exactly the expected settings and does nothing when it is already changed.
2026-11-09 face plate: Radxa camera, SparkFun ToF and a 1 W LED, framed by the open head
    hardware/cad/face-plate: the head's face plate with its sensor mounts changed for the
    Radxa Camera 8M 219 and the SparkFun Qwiic Mini ToF Imager (VL53L5CX), plus a seat and
    hole for a 1 W LED. Same outline and Pi standoffs as the plate in DuckBuddy.3mf.
    The open head's rim now frames the whole plate, over the top and down both sides,
    and its fit check covers the camera, the ToF board and the LED.
    [face_plate.3mf, face_plate.stl, open_head_shell.3mf, open_head_shell.stl]
2026-11-09 feet: soft cast soles, with a drawing and a quote request
    hardware/feet: the feet and soles as STL (STEP and the CAD zip are rebuilt by
    src/feet_parts.py and src/make_rfq.sh), a drawing, material and quality requirements,
    and a quote request for Shore 60A cast polyurethane soles in place of TPU 95A.
    [foot_left.stl, foot_right.stl, sole_left.stl, sole_right.stl]
2026-11-09 lipo plate: the BNO055 on its own mount on the rear hip servos
    The BNO055 breakout leaves the LiPo plate's front face for a small frame that holds
    it flat, chip up, on the tops of the two rear hip servos, where the PDB/IMU board
    goes; it screws into their horn holes (passive horns left off) and outer top holes.
    The plate keeps the old brackets to the rear hip servos. New tools place the whole
    robot and check the head's reach; the docs and the robot config follow.
    [imu_mount.3mf, imu_mount.step, imu_mount.stl, lipo_plate.3mf, lipo_plate.step, lipo_plate.stl]
2026-11-09 lipo plate: the BNO055 mount fits over the rear hip servos' hubs
    With the passive horns off, the servos' hubs stay on their tops. The
    mount's bosses are now caps that fit over the hubs and rest on them, and
    the horn screws go through the caps into the hubs.
    checks/neck_check.py runs only the head and neck part of the fit check
    against the BNO055 and its mount, for small changes to the mount.
    [DuckBuddy.3mf, imu_mount.3mf, imu_mount.step, imu_mount.stl]
